thriller91/Cansat-SupOp/README.md

#Projet τετραφάρμακος

#à propos
Nous construisons un cansat, ce satellite, qui sera largué d'un dirigeable du CNES, doit tenir dans une canette. Il doit réaliser 
plusieurs missions. Nous allons faire une mesure de données météorologiques, et une mesure de l'indice de végétation par une prise 
d'image dans deux gammes spectrales.

#les composants

Nous utilisons une Arduino mini pour contrôler nos capteurs (pression, température, hydrométrie, accélération, position GPS), nos 
caméras (caméra JPEG), notre module de transmission sans fil (Xbee) et notre carte mémoire micro-SD.
L'ensemble de ces composants doit être mis en commun, et il est important de bien respecter les tensions de chacun. Les programmes 
permettant de piloter ces composants sont rassemblés dans ce repository.
