thriller91/Cansat-SupOp/sources/Arduino/DHT22/README.md

#Capteur d'humidité et de température

##Branchement

- Pin 1 (on the left) → +5V
- Pin 2 → DHTPIN defini dans le programme
- Pin 4 → GND
- Connect a 10K resistor from pin 2 (data) to pin 1 (power) of the sensor
