thriller91/Cansat-SupOp/sources/Arduino/BMP085/README.md

# Ce programme marche sur la Mini (sans translateur de niveau)

##Branchement:
- SDA → AD4
- SCL → AD5
- GND → GND (alim stab)
- VCC → 3.3V (alim stab)
