thriller91/Cansat-SupOp/sources/prgm sol/communication/pycrop/cooked/Press.pdf

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

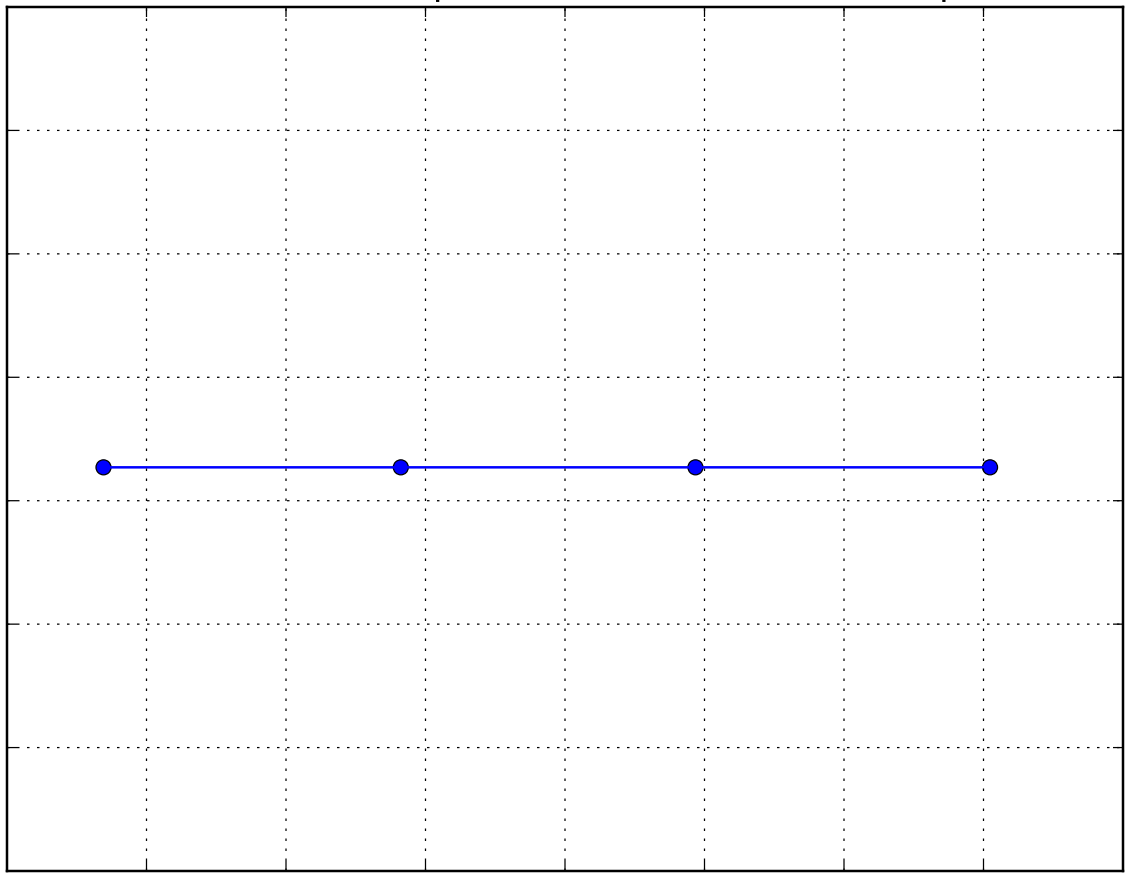
[picture p15: figure]
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
