thriller91/Cansat-SupOp/elec/tetrapharmakos_image0.png

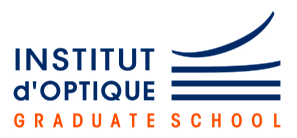
elec/tetrapharmakos_image0.png
