thriller91/Cansat-SupOp/elec/tetrapharmakos_image1.png

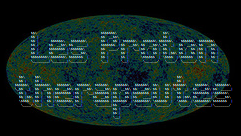
elec/tetrapharmakos_image1.png
