thriller91/Cansat-SupOp/sources/Arduino/tetra/IMG01.JPG

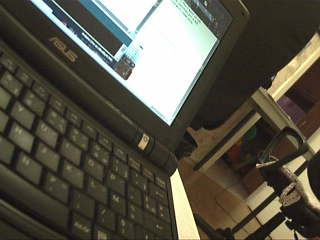
sources/Arduino/tetra/IMG01.JPG
