thriller91/Cansat-SupOp/sources/prgm sol/communication/pycrop/exemple.png

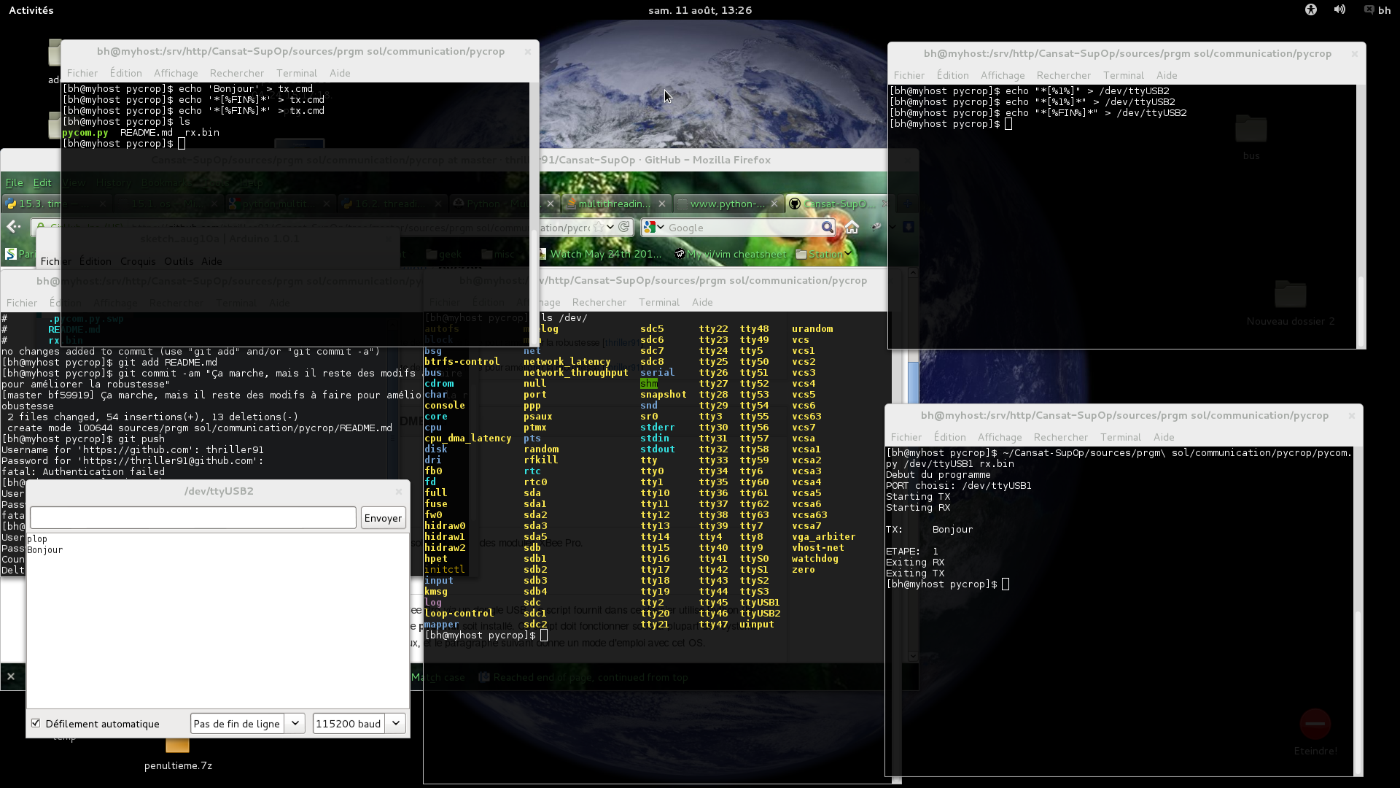
sources/prgm sol/communication/pycrop/exemple.png
