thriller91/Cansat-SupOp/sources/prgm sol/communication/pycrop/images/08-58-16.jpg

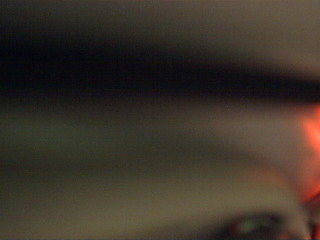
sources/prgm sol/communication/pycrop/images/08-58-16.jpg
