thriller91/Cansat-SupOp/sources/prgm sol/traitement images/a1.png

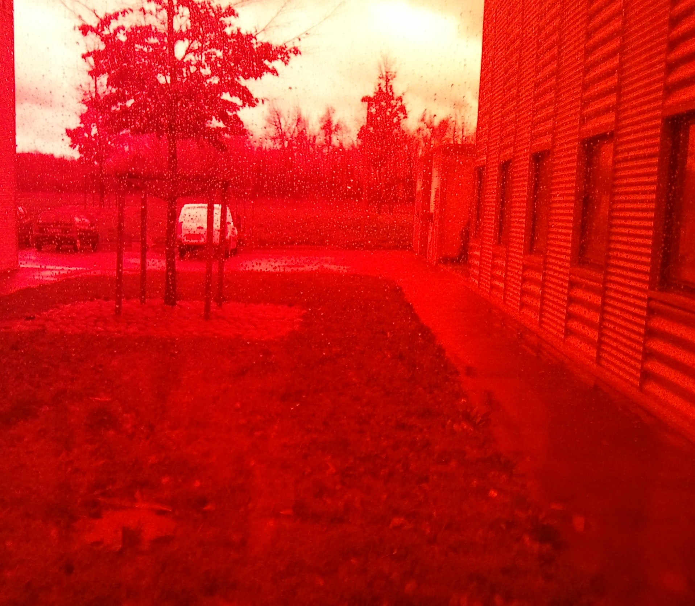
sources/prgm sol/traitement images/a1.png
