thriller91/Cansat-SupOp/sources/prgm sol/traitement images/a2.png

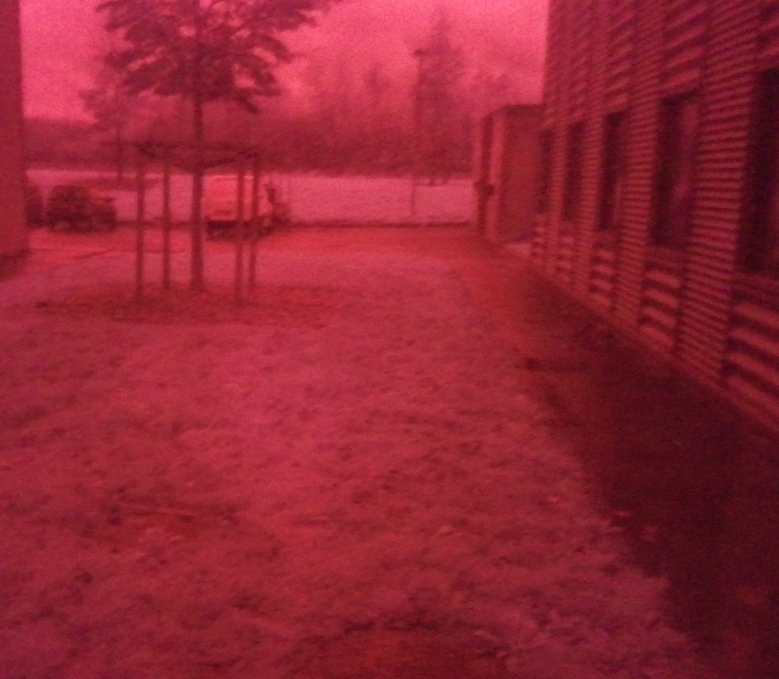
sources/prgm sol/traitement images/a2.png
