thriller91/Cansat-SupOp/sources/prgm sol/traitement images/b1.png

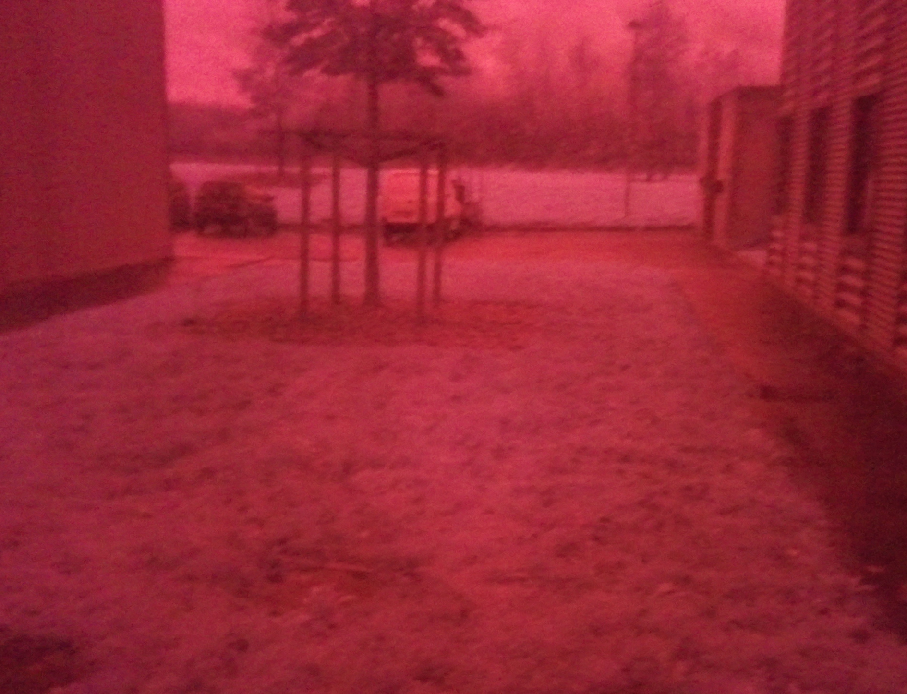
sources/prgm sol/traitement images/b1.png
