thriller91/Cansat-SupOp/sources/prgm sol/traitement images/b2.png

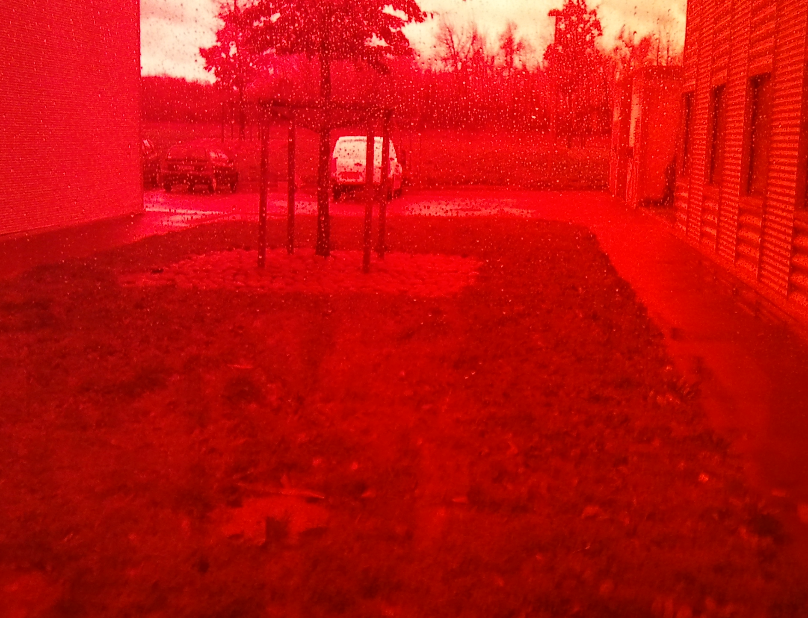
sources/prgm sol/traitement images/b2.png
