thriller91/Cansat-SupOp/sources/prgm sol/traitement images/efg/01.png

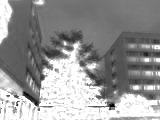
sources/prgm sol/traitement images/efg/01.png
