thriller91/Cansat-SupOp/sources/prgm sol/traitement images/efg/01IR.jpg

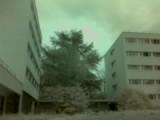
sources/prgm sol/traitement images/efg/01IR.jpg
