thriller91/Cansat-SupOp/sources/prgm sol/traitement images/efg/01R.jpg

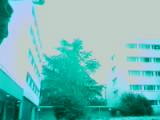
sources/prgm sol/traitement images/efg/01R.jpg
