thriller91/Cansat-SupOp/sources/prgm sol/traitement images/efg/02.png

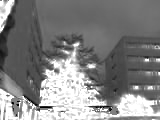
sources/prgm sol/traitement images/efg/02.png
