thriller91/Cansat-SupOp/sources/prgm sol/traitement images/efg/02IR.jpg

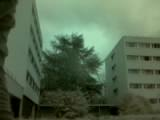
sources/prgm sol/traitement images/efg/02IR.jpg
