thriller91/Cansat-SupOp/sources/prgm sol/traitement images/efg/03.png

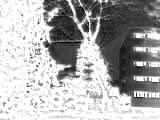
sources/prgm sol/traitement images/efg/03.png
