thriller91/Cansat-SupOp/sources/prgm sol/traitement images/efg/03IR.jpg

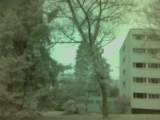
sources/prgm sol/traitement images/efg/03IR.jpg
