thriller91/Cansat-SupOp/sources/prgm sol/traitement images/efg/03R.jpg

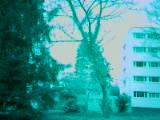
sources/prgm sol/traitement images/efg/03R.jpg
