thriller91/Cansat-SupOp/sources/prgm sol/traitement images/efg/04.png

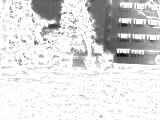
sources/prgm sol/traitement images/efg/04.png
