thriller91/Cansat-SupOp/sources/prgm sol/traitement images/efg/04IR.jpg

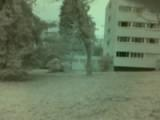
sources/prgm sol/traitement images/efg/04IR.jpg
