thriller91/Cansat-SupOp/sources/prgm sol/traitement images/efg/04R.jpg

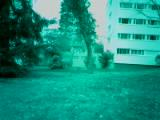
sources/prgm sol/traitement images/efg/04R.jpg
