thriller91/Cansat-SupOp/sources/prgm sol/traitement images/efg/05.png

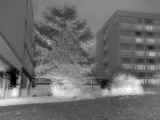
sources/prgm sol/traitement images/efg/05.png
