thriller91/Cansat-SupOp/sources/prgm sol/traitement images/efg/05IR.jpg

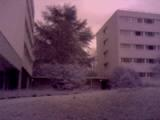
sources/prgm sol/traitement images/efg/05IR.jpg
