thriller91/Cansat-SupOp/sources/prgm sol/traitement images/efg/05R.jpg

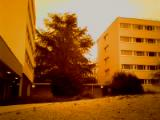
sources/prgm sol/traitement images/efg/05R.jpg
