thriller91/Cansat-SupOp/sources/prgm sol/traitement images/efg/06.png

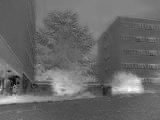
sources/prgm sol/traitement images/efg/06.png
