thriller91/Cansat-SupOp/sources/prgm sol/traitement images/efg/06IR.jpg

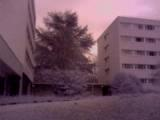
sources/prgm sol/traitement images/efg/06IR.jpg
