thriller91/Cansat-SupOp/sources/prgm sol/traitement images/efg/07.png

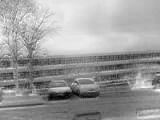
sources/prgm sol/traitement images/efg/07.png
