thriller91/Cansat-SupOp/sources/prgm sol/traitement images/efg/07IR.jpg

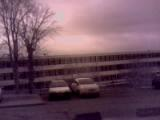
sources/prgm sol/traitement images/efg/07IR.jpg
