thriller91/Cansat-SupOp/sources/prgm sol/traitement images/efg/07R.jpg

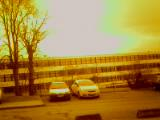
sources/prgm sol/traitement images/efg/07R.jpg
