thriller91/Cansat-SupOp/sources/prgm sol/traitement images/efg/08.png

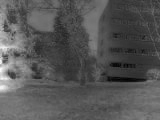
sources/prgm sol/traitement images/efg/08.png
