thriller91/Cansat-SupOp/sources/prgm sol/traitement images/efg/08IR.jpg

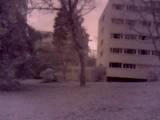
sources/prgm sol/traitement images/efg/08IR.jpg
