thriller91/Cansat-SupOp/sources/prgm sol/traitement images/efg/08R.jpg

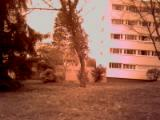
sources/prgm sol/traitement images/efg/08R.jpg
