thriller91/Cansat-SupOp/sources/prgm sol/traitement images/Photo1661.jpg

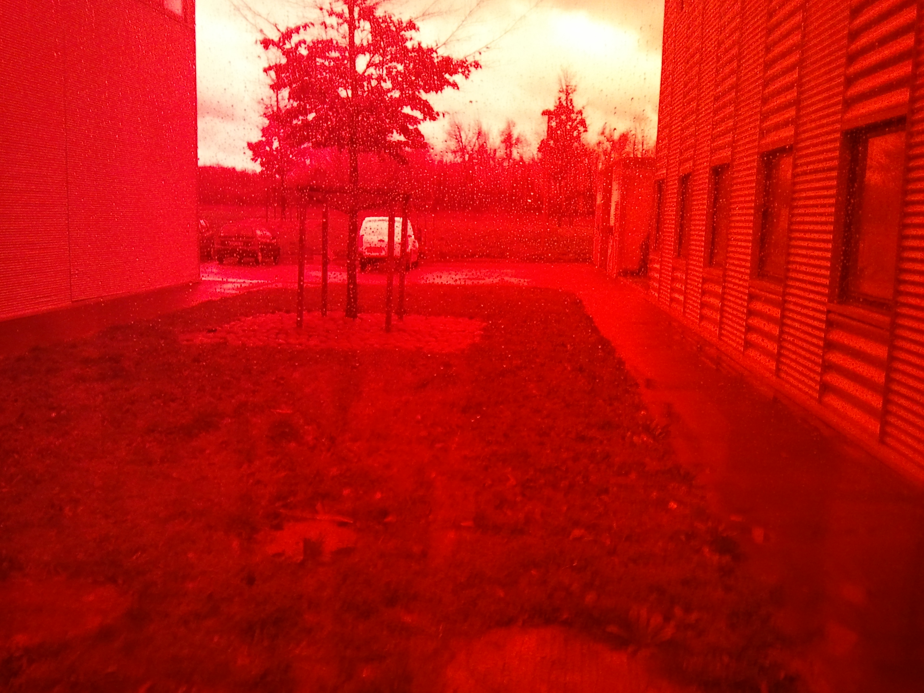
sources/prgm sol/traitement images/Photo1661.jpg
