thriller91/Cansat-SupOp/sources/prgm sol/traitement images/Photo1662.jpg

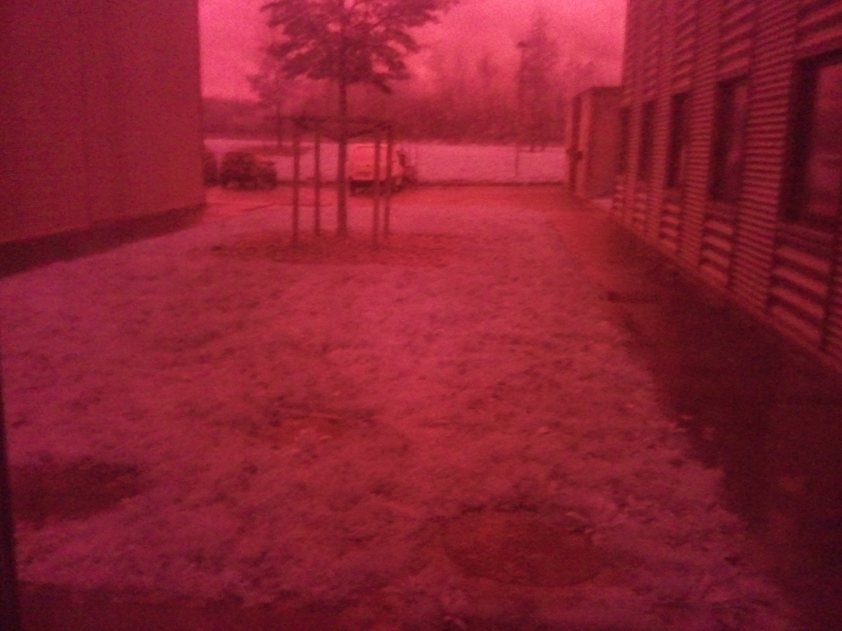
sources/prgm sol/traitement images/Photo1662.jpg
