thriller91/Cansat-SupOp/sources/prgm sol/traitement images/research/IMG01.JPG

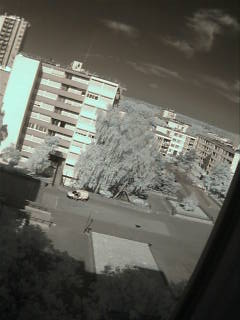
sources/prgm sol/traitement images/research/IMG01.JPG
