thriller91/Cansat-SupOp/website/images/elec/alim-photo.png

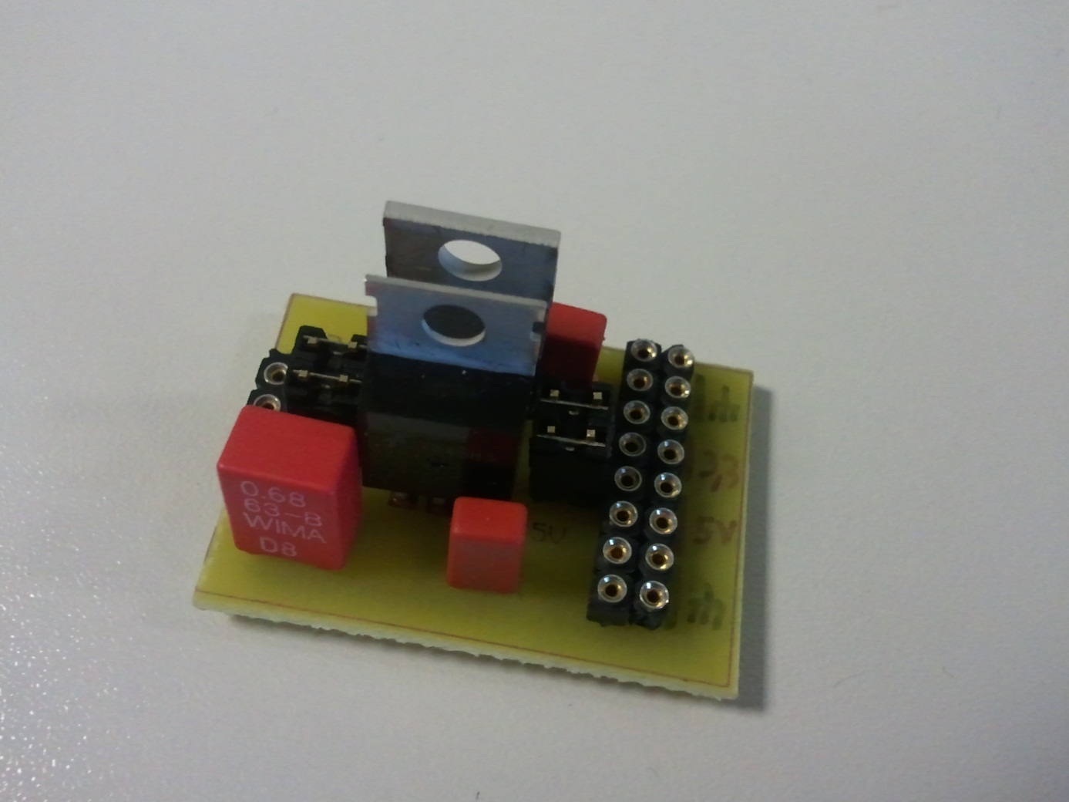
website/images/elec/alim-photo.png
