thriller91/Cansat-SupOp/website/images/elec/alim-schema.png

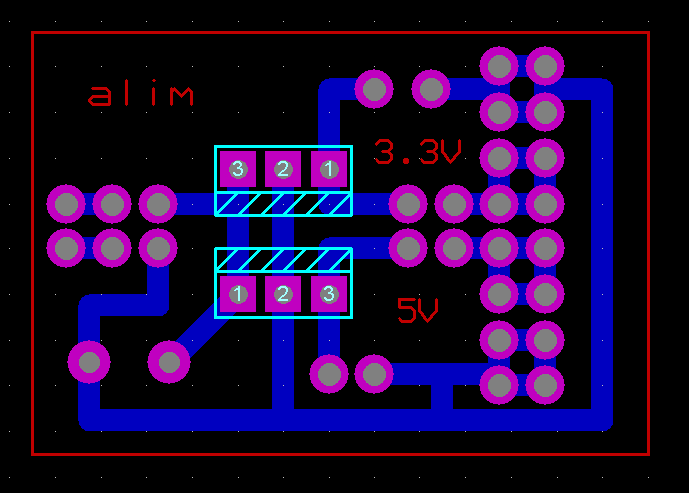
website/images/elec/alim-schema.png
