thriller91/Cansat-SupOp/website/images/elec/cansat-header.png

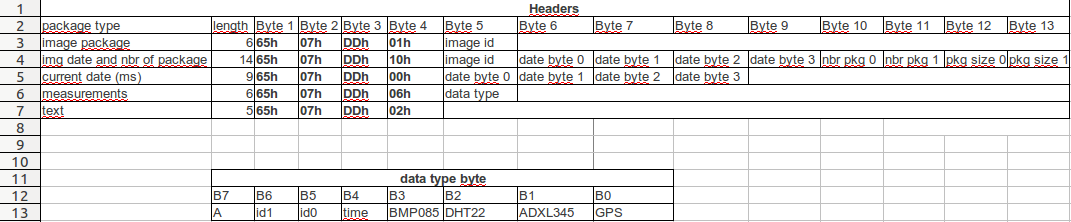
website/images/elec/cansat-header.png
