thriller91/Cansat-SupOp/website/images/elec/ccd.png

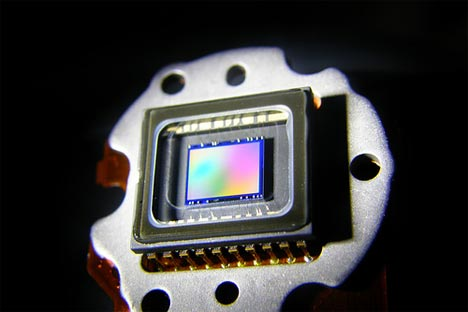
website/images/elec/ccd.png
