thriller91/Cansat-SupOp/website/images/elec/cube-cartes.png

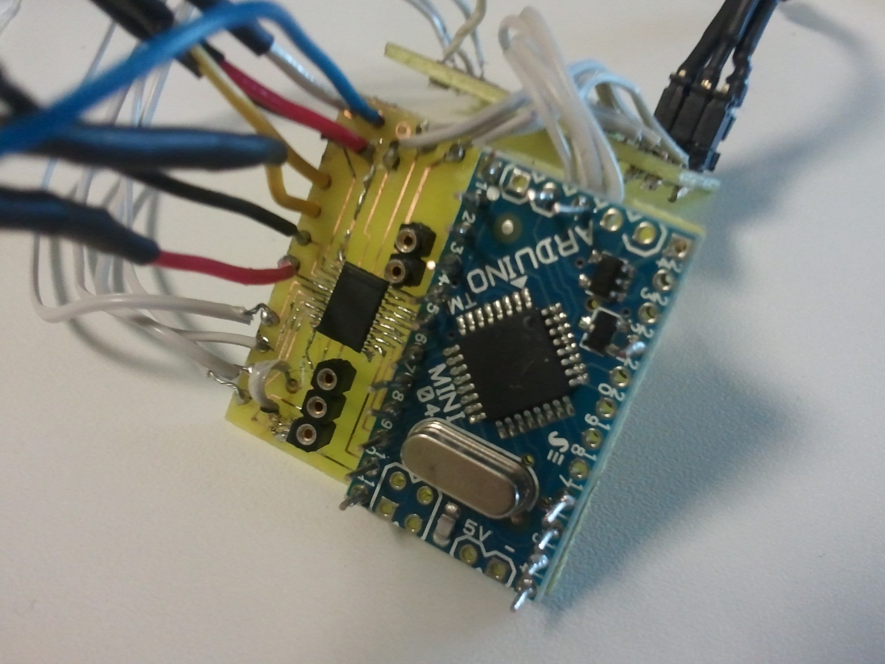
website/images/elec/cube-cartes.png
