thriller91/Cansat-SupOp/website/images/elec/cube-elec.png

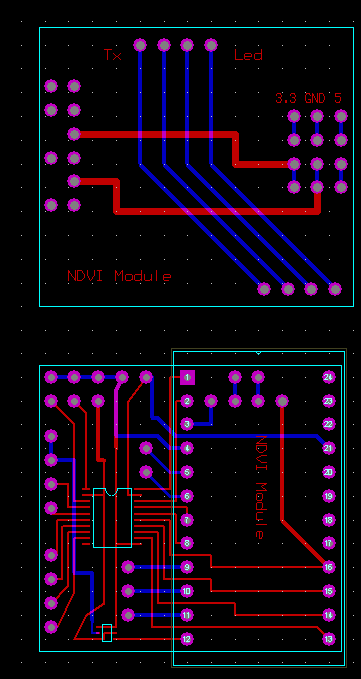
website/images/elec/cube-elec.png
