thriller91/Cansat-SupOp/website/images/elec/fatras.png

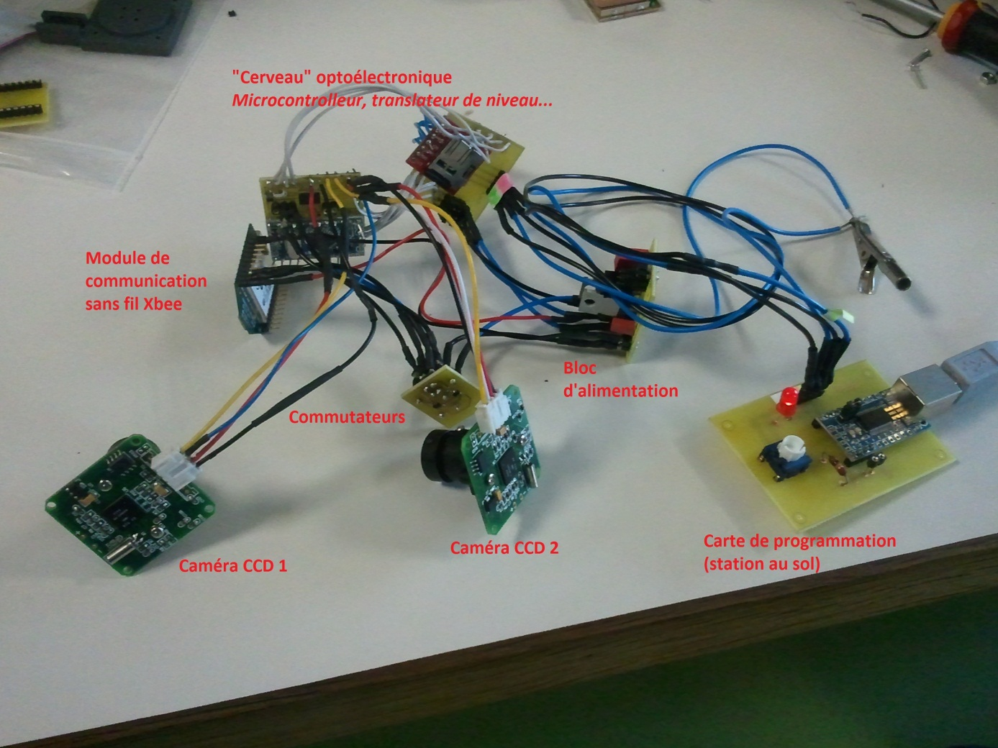
website/images/elec/fatras.png
