thriller91/Cansat-SupOp/website/images/elec/prog.png

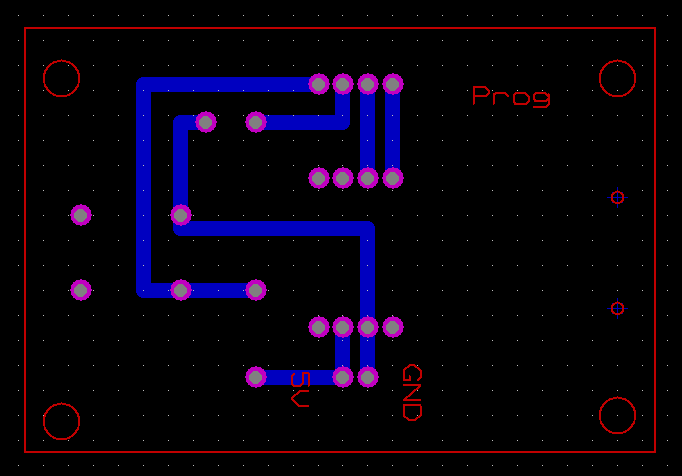
website/images/elec/prog.png
