thriller91/Cansat-SupOp/website/images/elec/schema-1-2-struct-logi.png

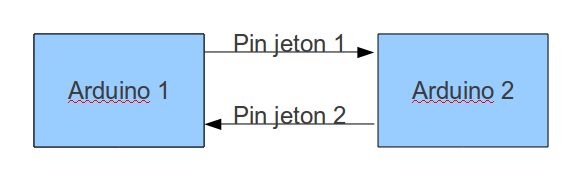
website/images/elec/schema-1-2-struct-logi.png
