thriller91/Cansat-SupOp/website/images/elec/translation-photo.png

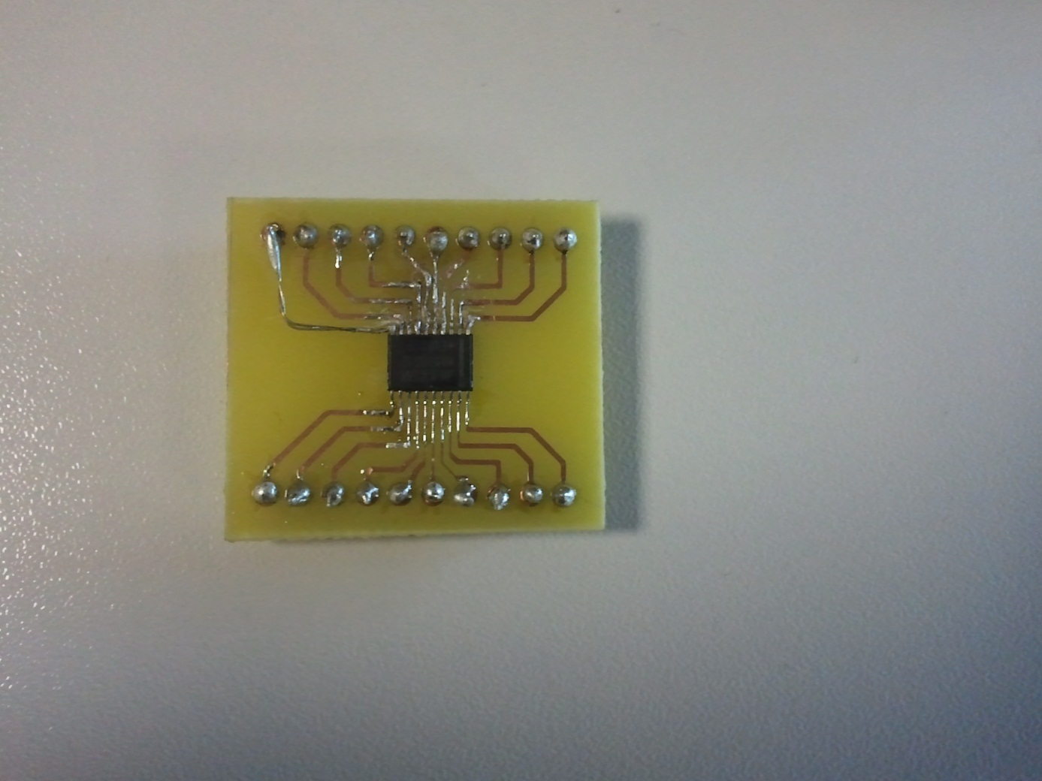
website/images/elec/translation-photo.png
