thriller91/Cansat-SupOp/website/images/elec/translation-schema.png

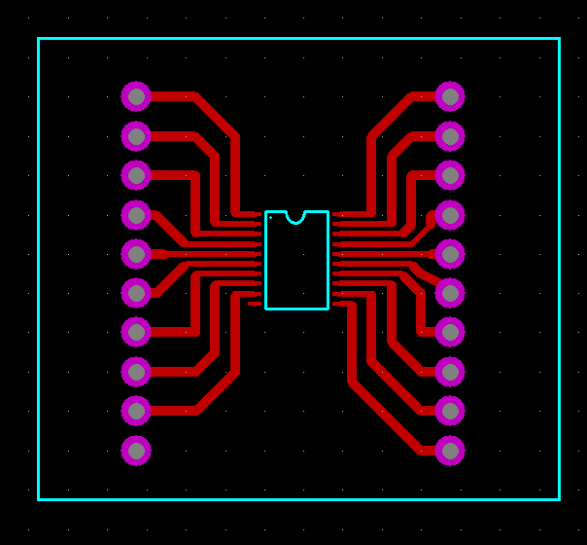
website/images/elec/translation-schema.png
