thriller91/Cansat-SupOp/website/images/global_ndvi_19990921.jpg

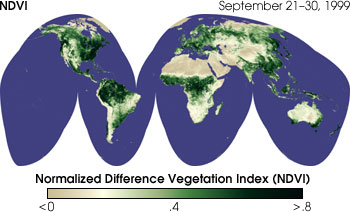
website/images/global_ndvi_19990921.jpg
