thriller91/Cansat-SupOp/website/images/hkgfmh.bmp

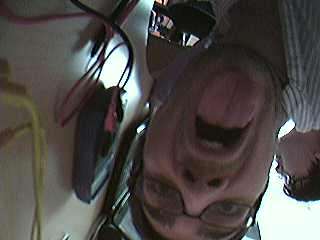
website/images/hkgfmh.bmp
