thriller91/Cansat-SupOp/website/images/nasa-sun-blue.jpg

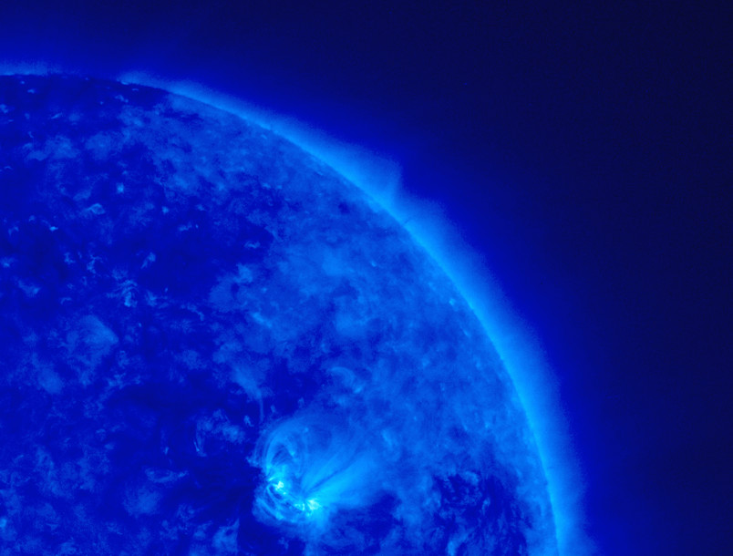
website/images/nasa-sun-blue.jpg
