thriller91/Cansat-SupOp/website/images/nasa-sun-stereo.jpg

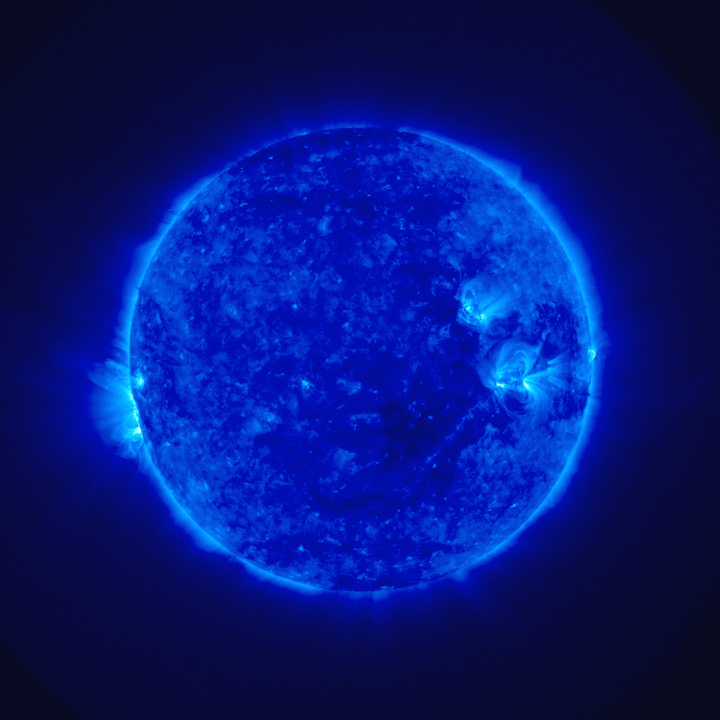
website/images/nasa-sun-stereo.jpg
