thriller91/Cansat-SupOp/website/images/parachute/DSCF2862.JPG

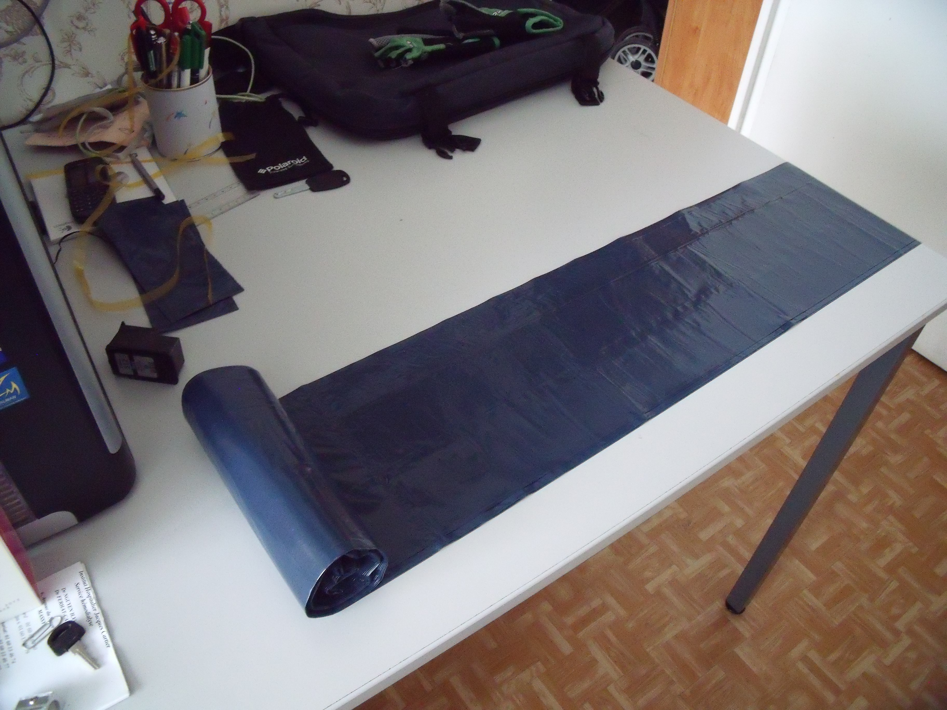
website/images/parachute/DSCF2862.JPG
