thriller91/Cansat-SupOp/website/images/parachute/DSCF2863.JPG

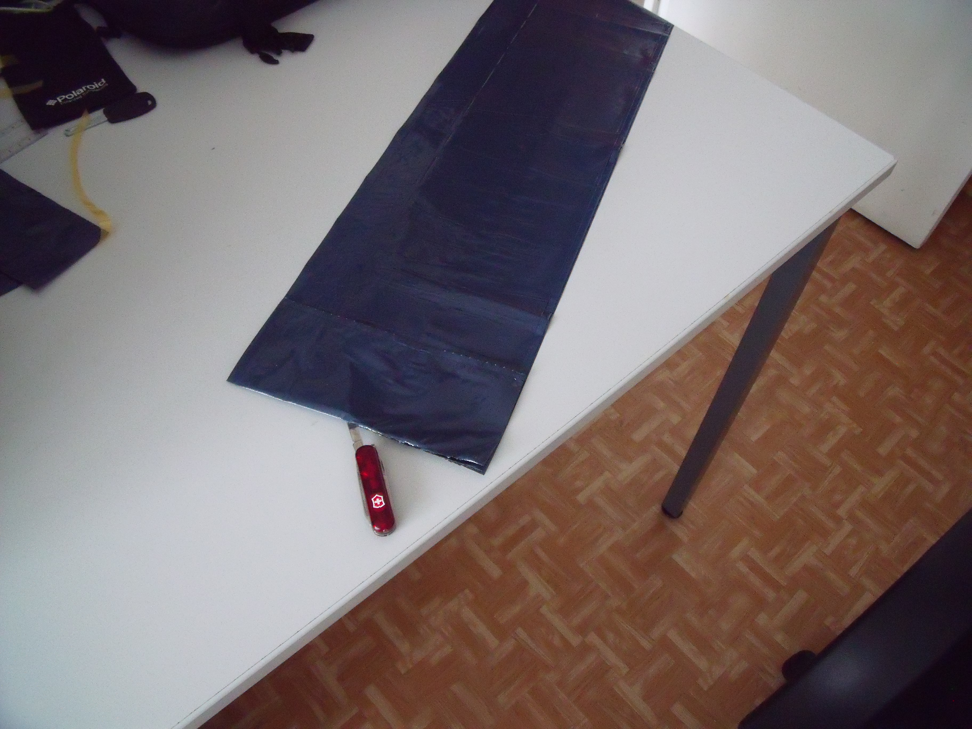
website/images/parachute/DSCF2863.JPG
