thriller91/Cansat-SupOp/website/images/parachute/DSCF2865.JPG

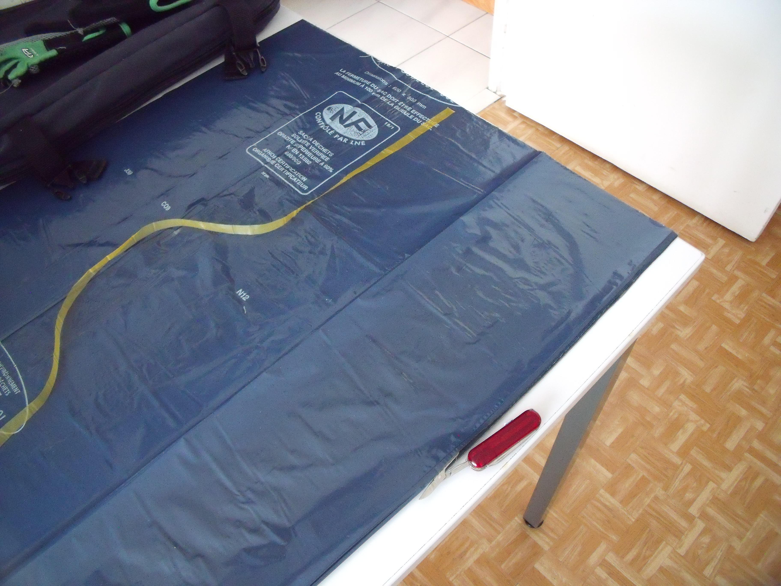
website/images/parachute/DSCF2865.JPG
