thriller91/Cansat-SupOp/website/images/parachute/DSCF2867.JPG

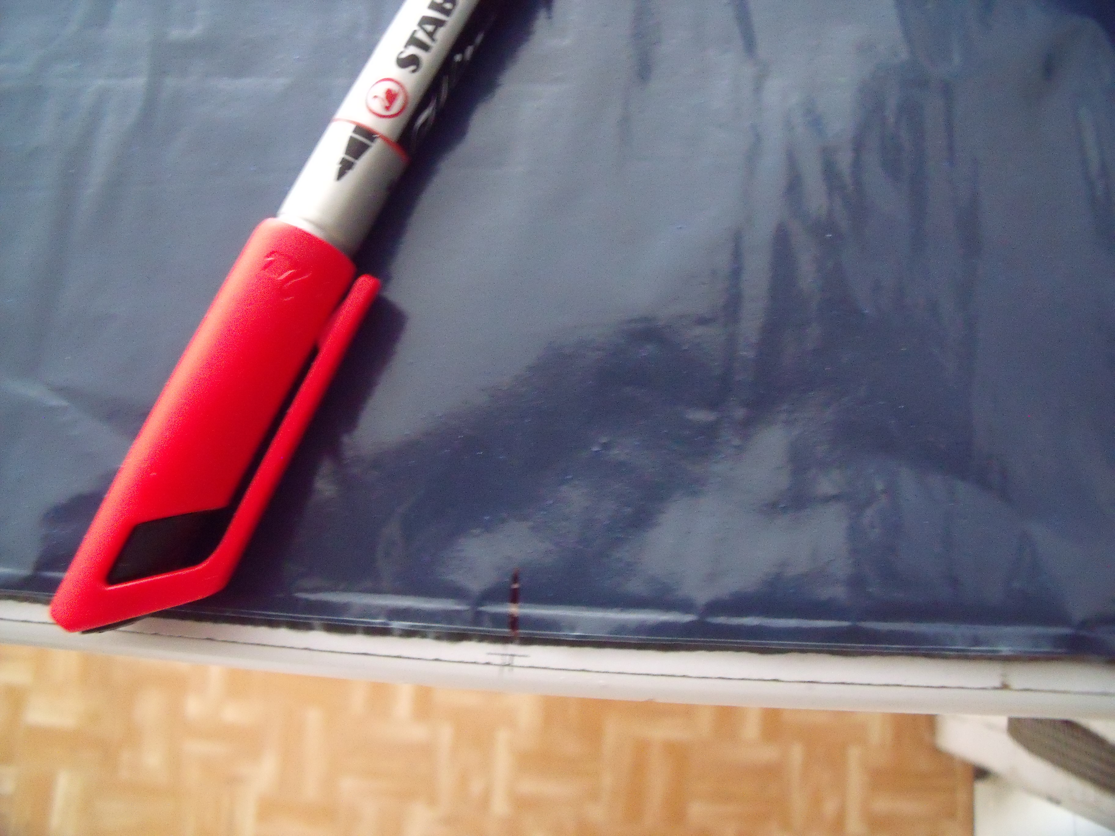
website/images/parachute/DSCF2867.JPG
