thriller91/Cansat-SupOp/website/images/parachute/DSCF2868.JPG

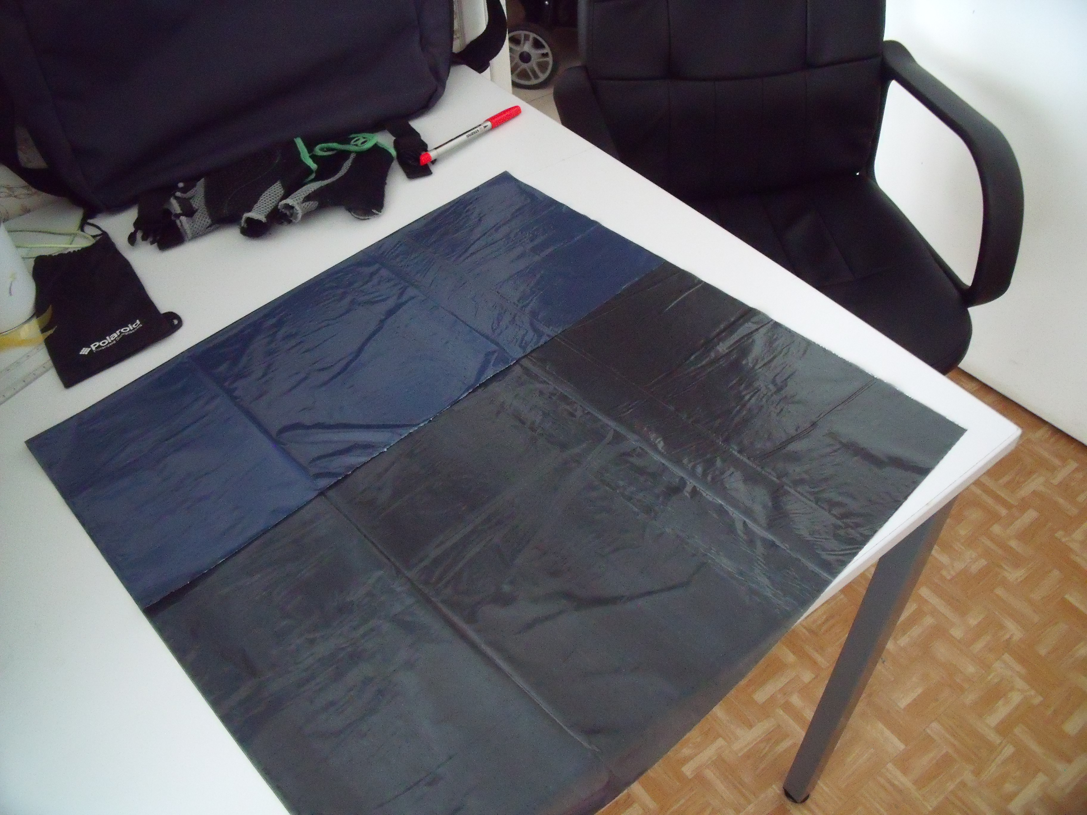
website/images/parachute/DSCF2868.JPG
