thriller91/Cansat-SupOp/website/images/parachute/DSCF2869.JPG

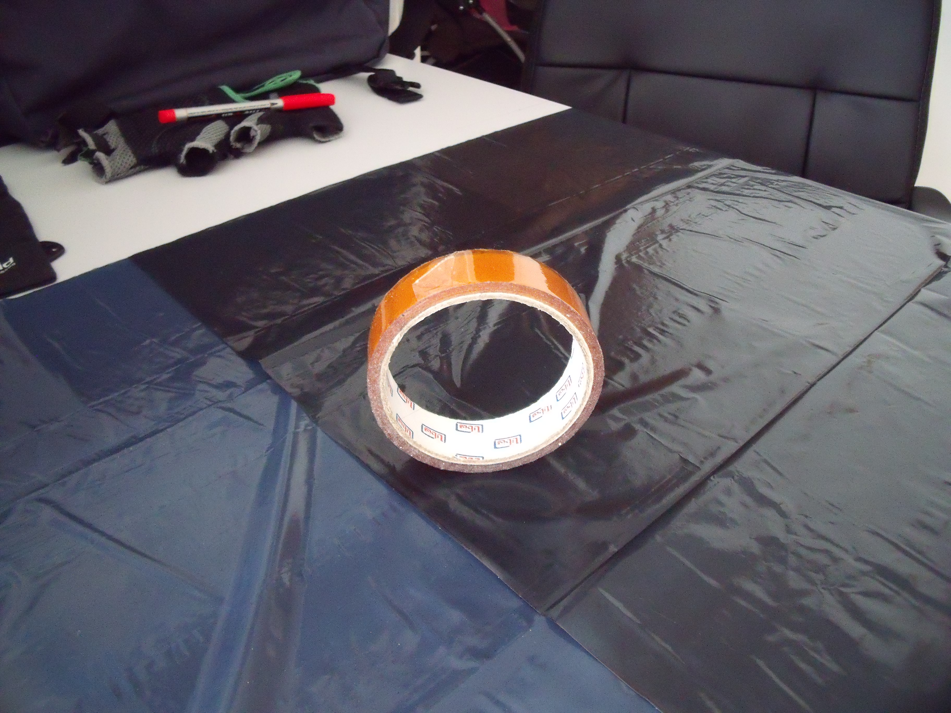
website/images/parachute/DSCF2869.JPG
