thriller91/Cansat-SupOp/website/images/parachute/DSCF2870.JPG

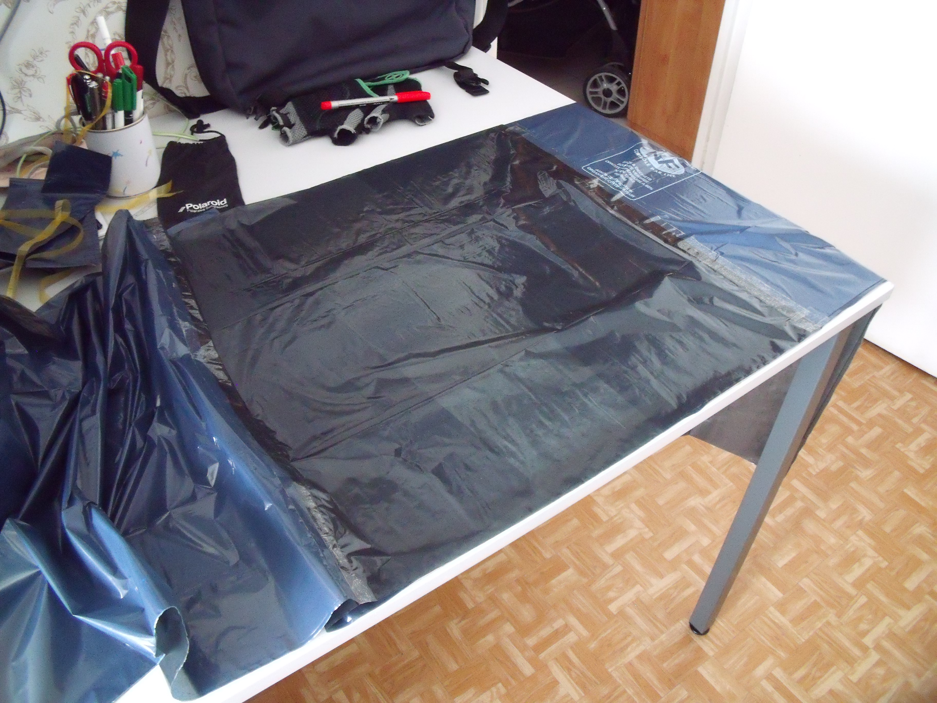
website/images/parachute/DSCF2870.JPG
