thriller91/Cansat-SupOp/website/images/parachute/DSCF2871.JPG

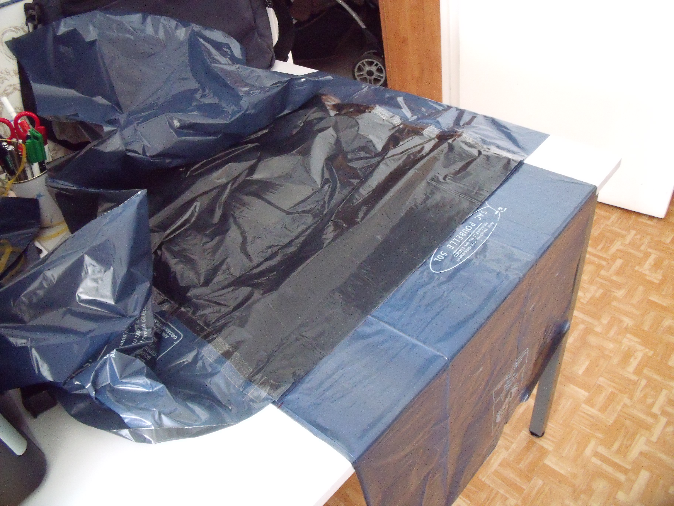
website/images/parachute/DSCF2871.JPG
