thriller91/Cansat-SupOp/website/images/parachute/DSCF2872.JPG

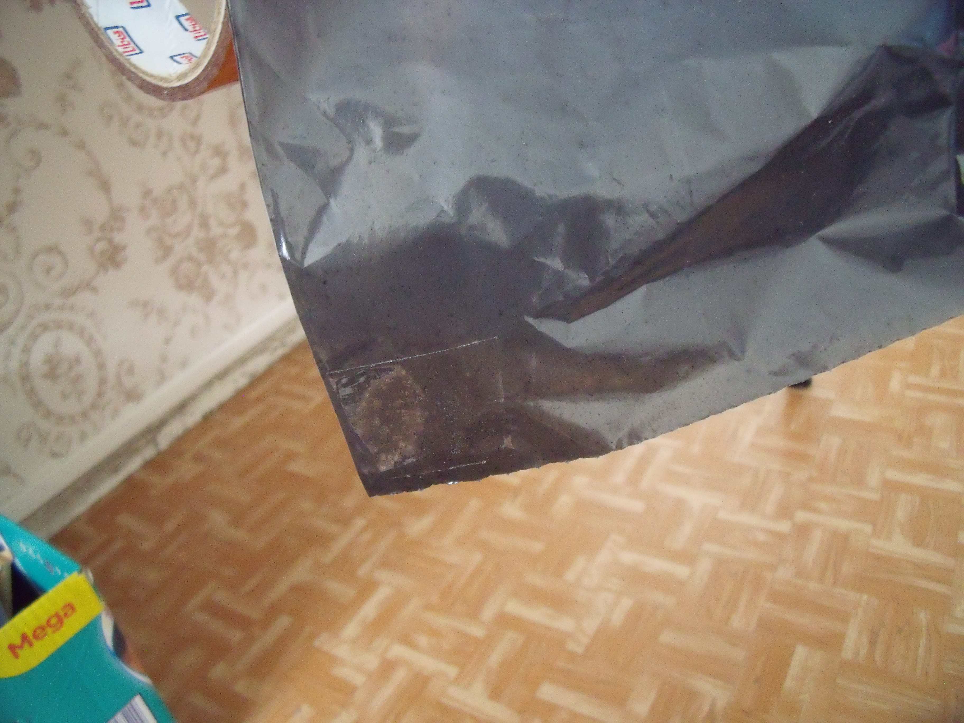
website/images/parachute/DSCF2872.JPG
