thriller91/Cansat-SupOp/website/images/parachute/DSCF2873.JPG

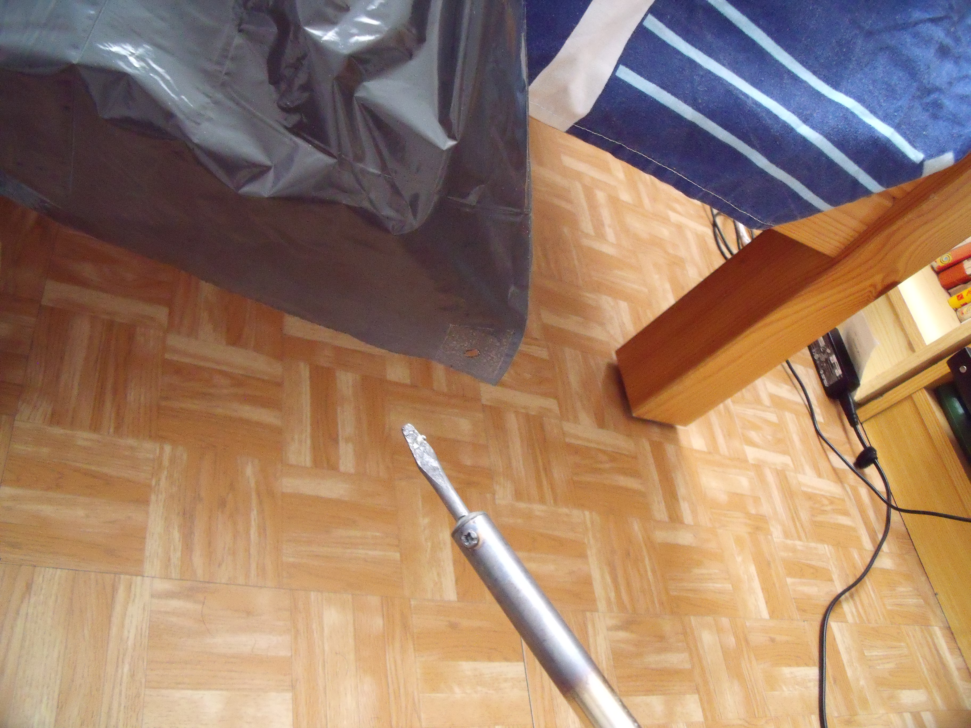
website/images/parachute/DSCF2873.JPG
