thriller91/Cansat-SupOp/website/images/parachute/DSCF2874.JPG

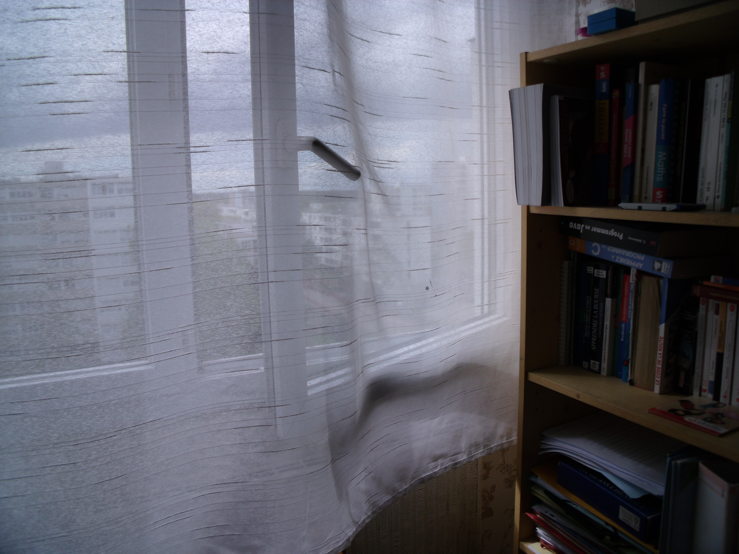
website/images/parachute/DSCF2874.JPG
