thriller91/Cansat-SupOp/website/images/parachute/DSCF2877.JPG

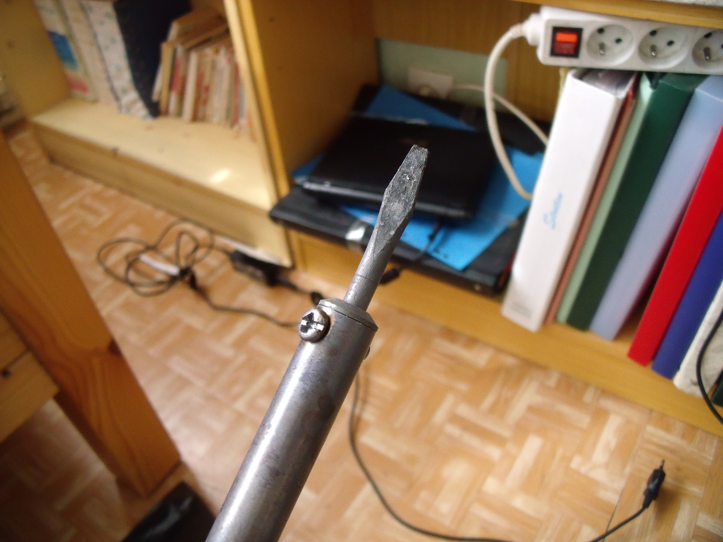
website/images/parachute/DSCF2877.JPG
