thriller91/Cansat-SupOp/website/images/parachute/DSCF2883.JPG

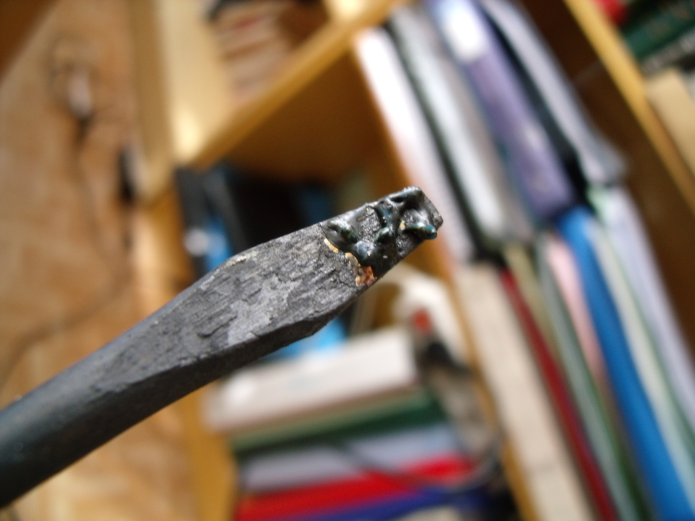
website/images/parachute/DSCF2883.JPG
