thriller91/Cansat-SupOp/website/images/parachute/DSCF2886.JPG

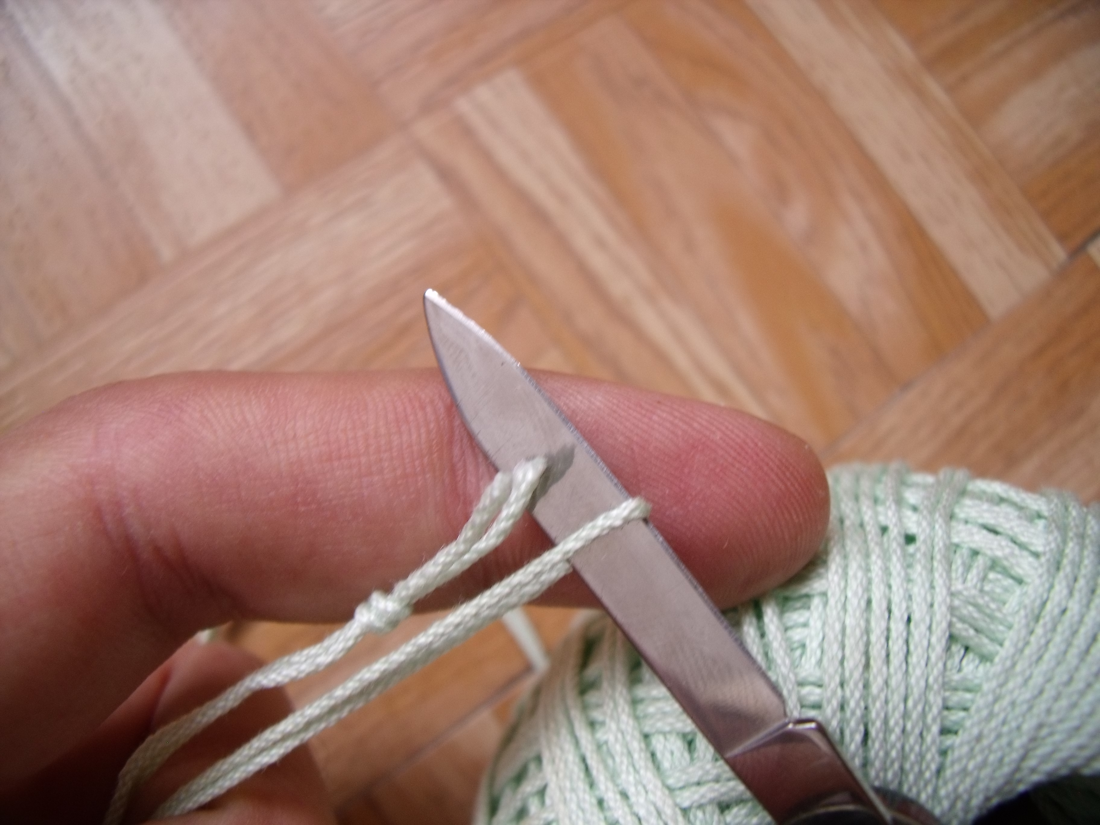
website/images/parachute/DSCF2886.JPG
