thriller91/Cansat-SupOp/website/images/parachute/DSCF2887.JPG

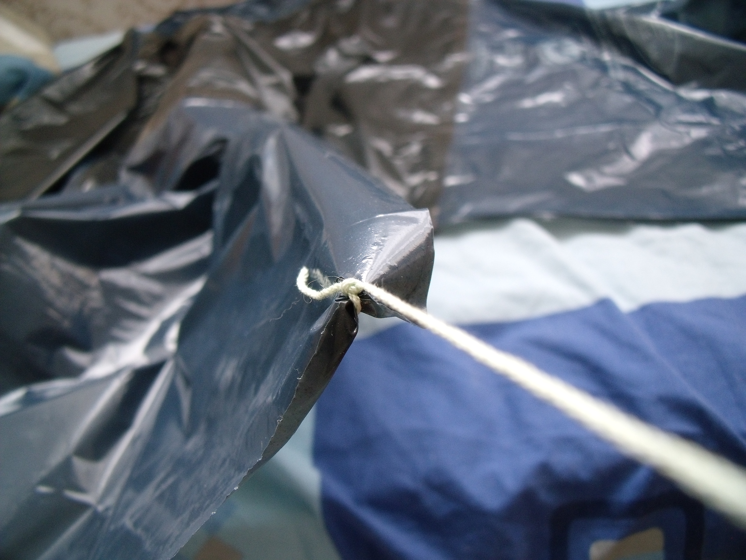
website/images/parachute/DSCF2887.JPG
