thriller91/Cansat-SupOp/website/images/parachute/DSCF2889.JPG

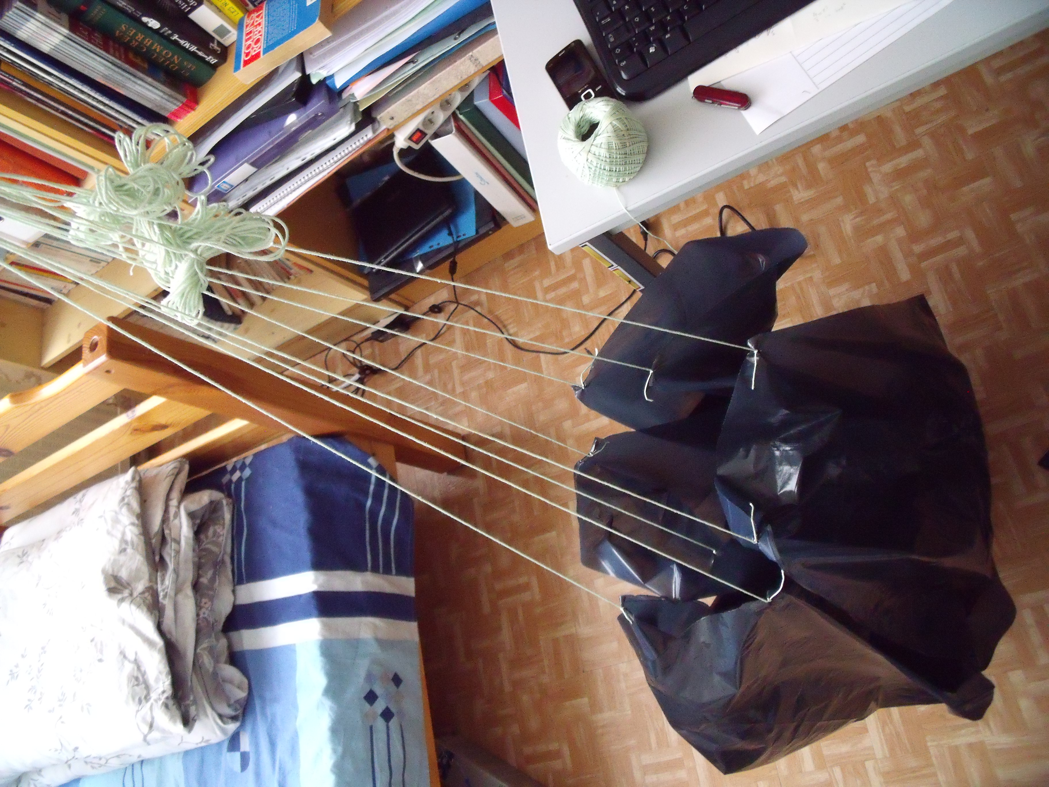
website/images/parachute/DSCF2889.JPG
