thriller91/Cansat-SupOp/website/images/plots/Budget_total.png

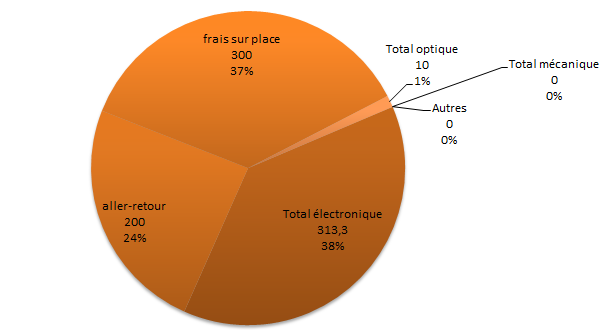
website/images/plots/Budget_total.png
