thriller91/Cansat-SupOp/website/images/plots/elec_diag.png

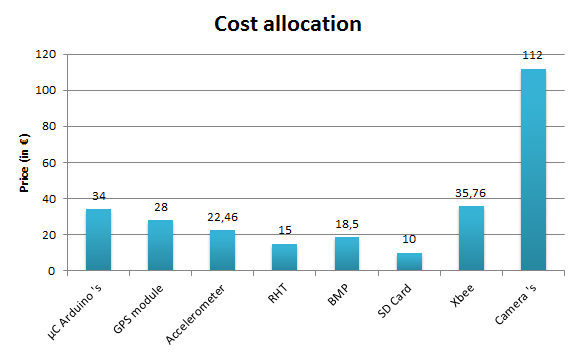
website/images/plots/elec_diag.png
