thriller91/Cansat-SupOp/website/images/plots/elec_mass.png

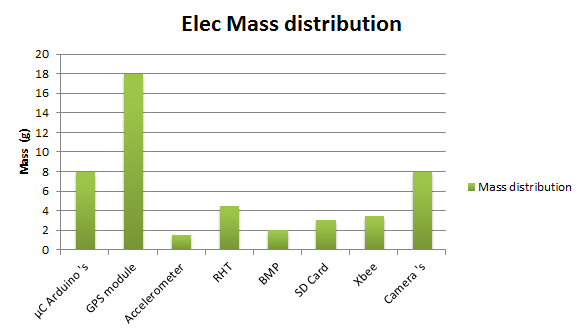
website/images/plots/elec_mass.png
