thriller91/Cansat-SupOp/website/images/plots/max_cons_camembert.png

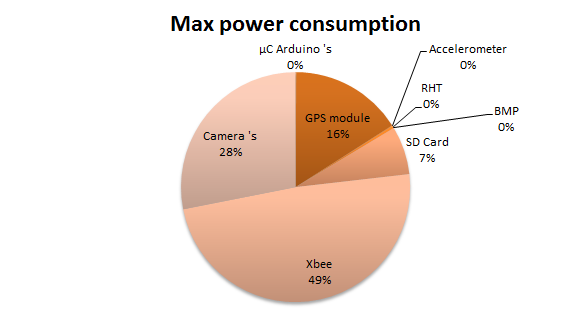
website/images/plots/max_cons_camembert.png
