thriller91/Cansat-SupOp/website/images/plots/max_cons_hist.png

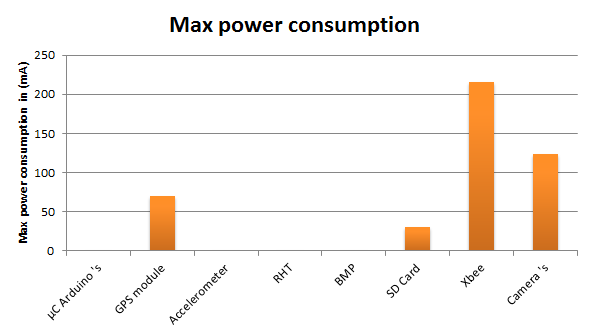
website/images/plots/max_cons_hist.png
