thriller91/Cansat-SupOp/website/images/plots/max_pow_camembert.png

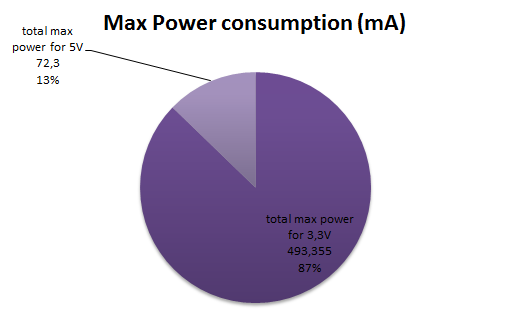
website/images/plots/max_pow_camembert.png
