thriller91/Cansat-SupOp/website/images/plots/max_pow_hist.png

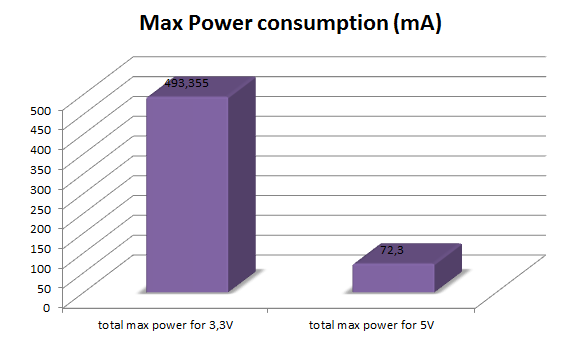
website/images/plots/max_pow_hist.png
