thriller91/Cansat-SupOp/website/images/plots/op_voltage.png

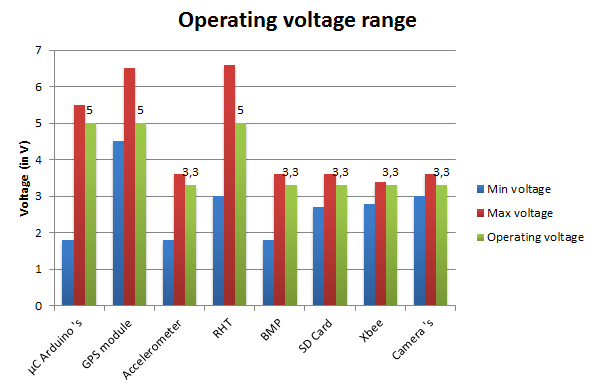
website/images/plots/op_voltage.png
