thriller91/Cansat-SupOp/website/images/plots/Structure_elec.png

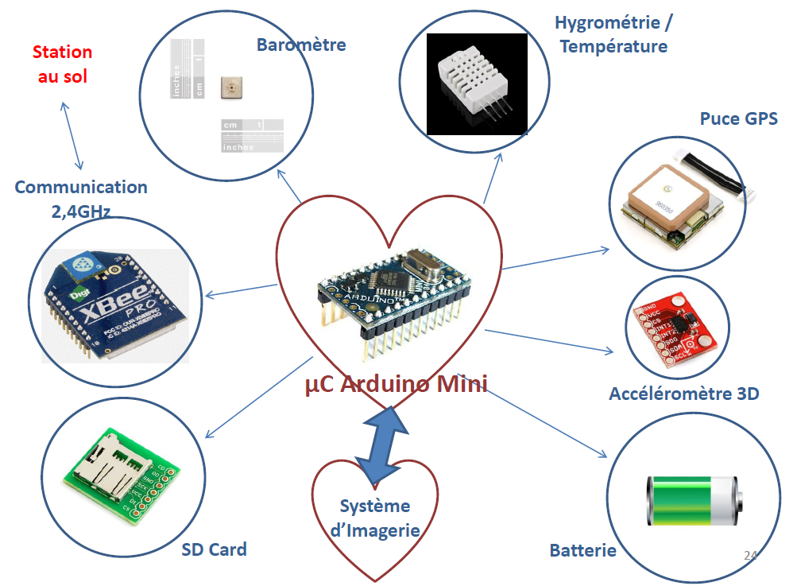
website/images/plots/Structure_elec.png
