thriller91/Cansat-SupOp/website/images/plots/temp.png

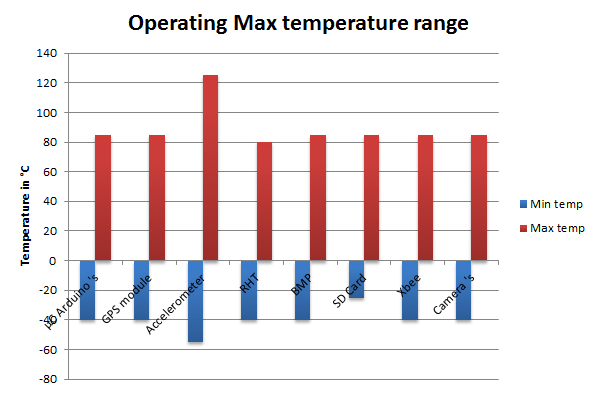
website/images/plots/temp.png
