thriller91/Cansat-SupOp/website/images/selec/DSCF3150.JPG

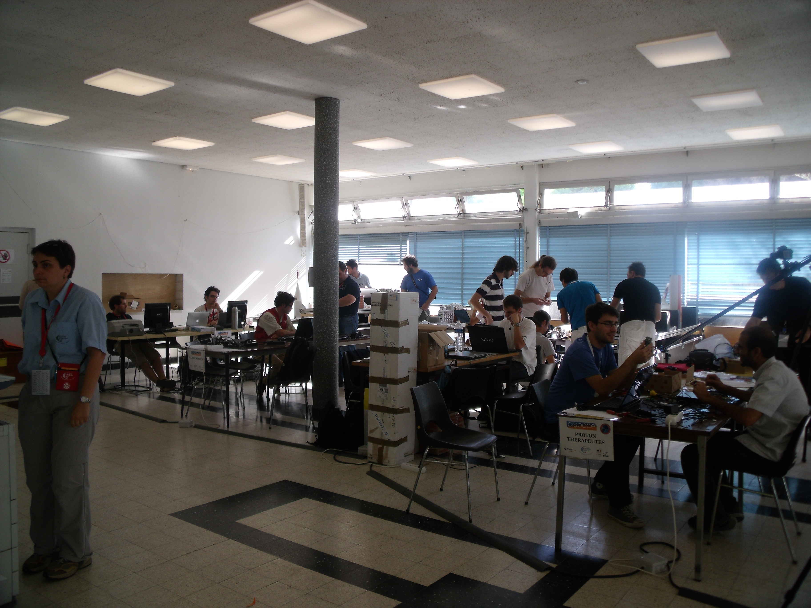
website/images/selec/DSCF3150.JPG
