thriller91/Cansat-SupOp/website/images/selec/DSCF3154.JPG

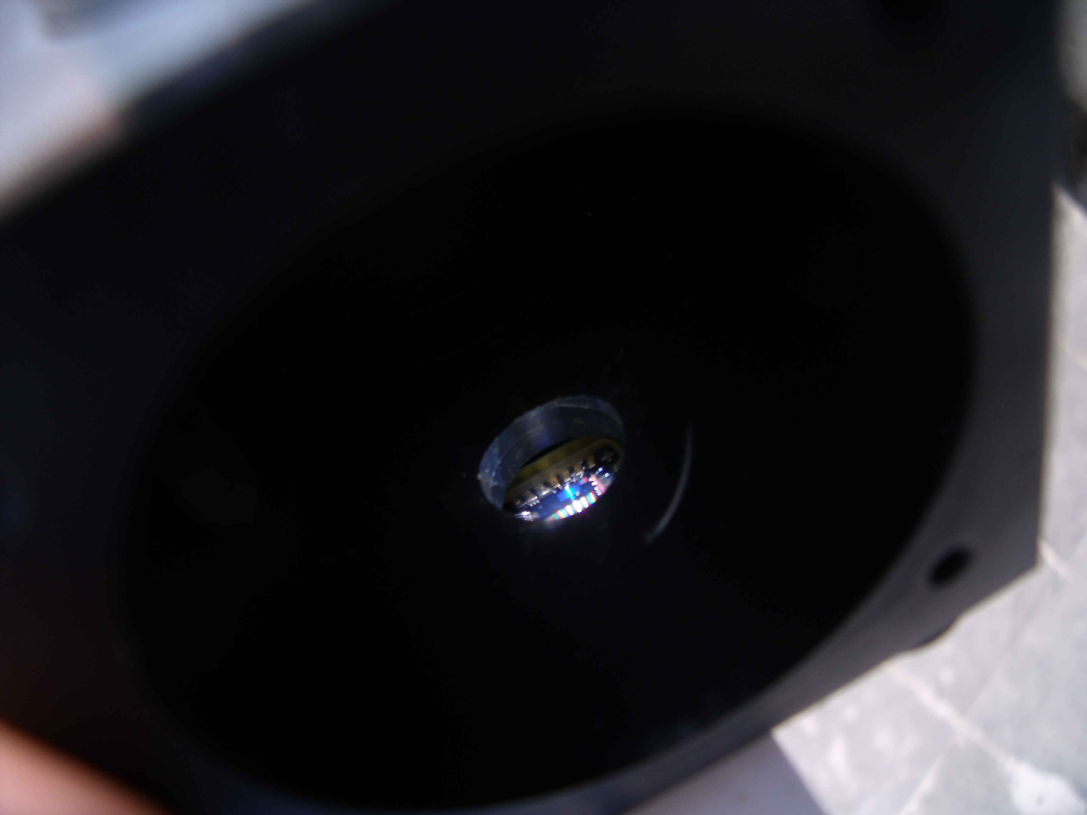
website/images/selec/DSCF3154.JPG
