thriller91/Cansat-SupOp/website/images/selec/DSCF3156.JPG

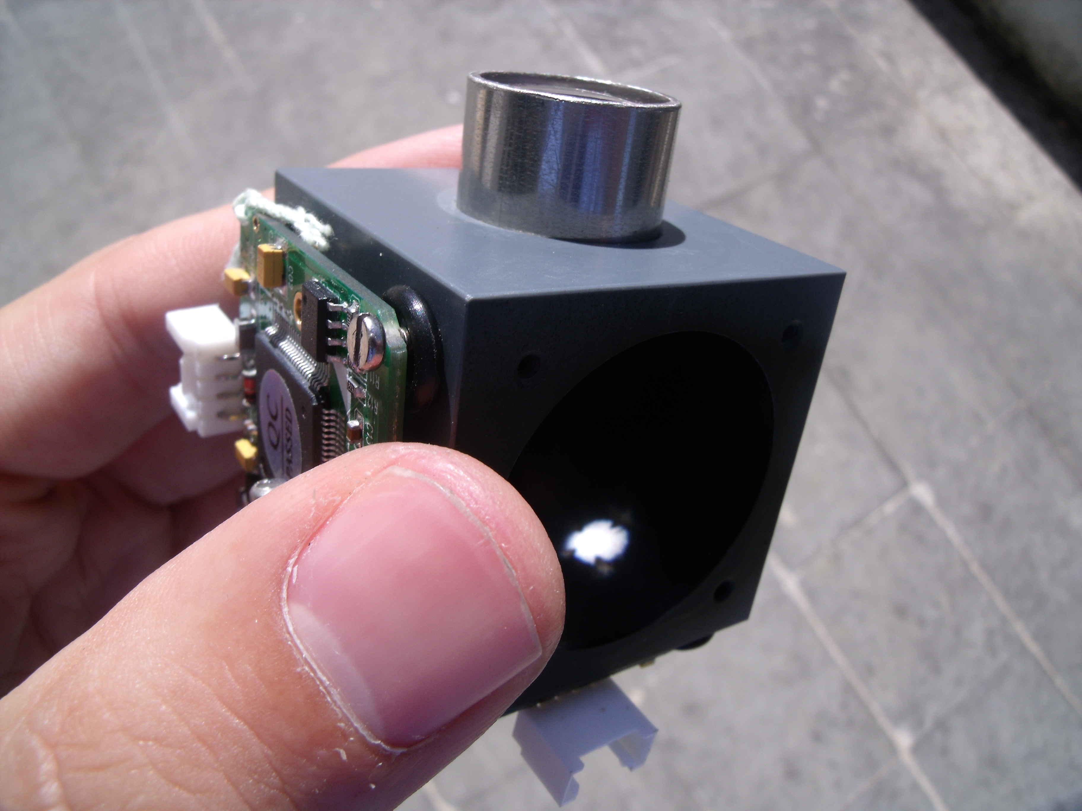
website/images/selec/DSCF3156.JPG
