thriller91/Cansat-SupOp/website/images/selec/DSCF3159.JPG

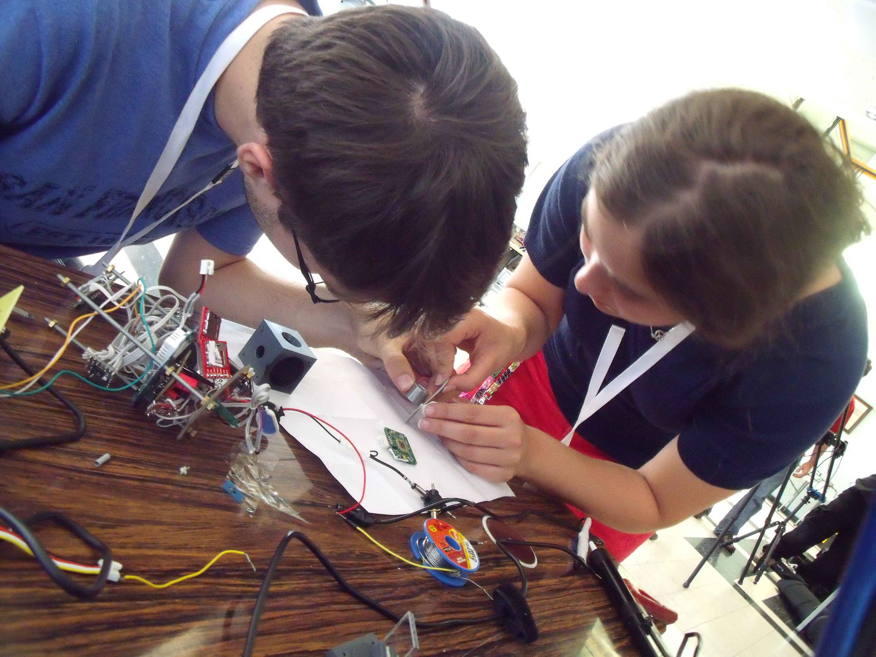
website/images/selec/DSCF3159.JPG
