thriller91/Cansat-SupOp/website/images/selec/DSCF3164.JPG

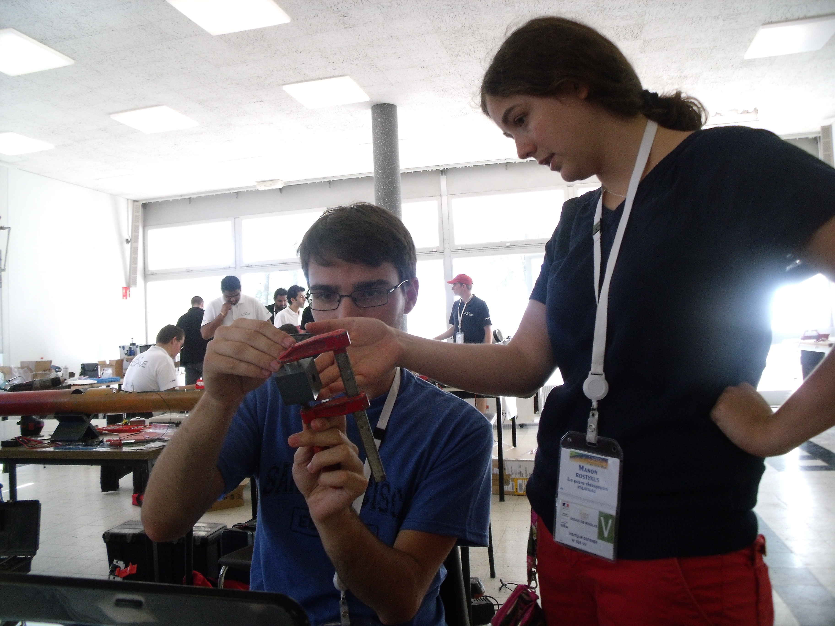
website/images/selec/DSCF3164.JPG
