thriller91/Cansat-SupOp/website/images/selec/DSCF3168.JPG

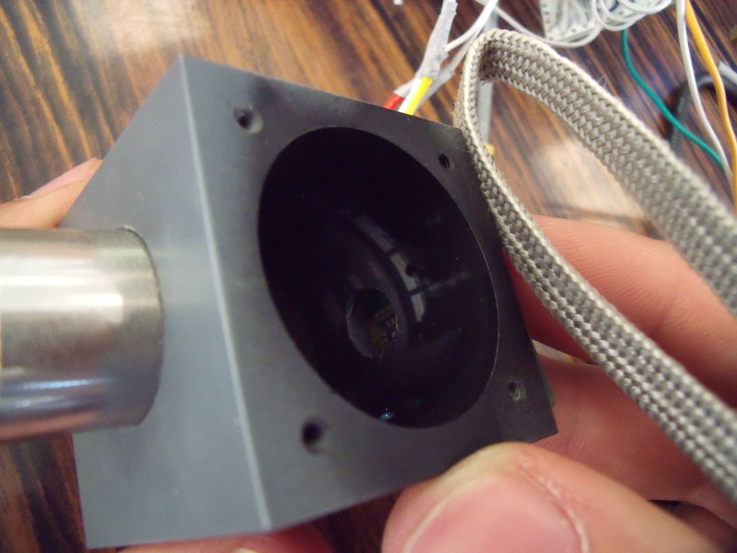
website/images/selec/DSCF3168.JPG
