thriller91/Cansat-SupOp/website/images/selec/DSCF3175.JPG

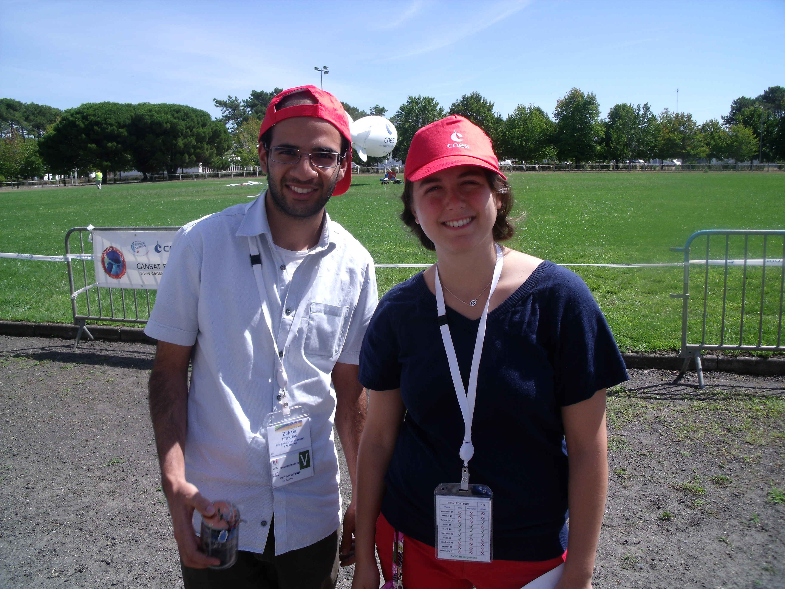
website/images/selec/DSCF3175.JPG
