thriller91/Cansat-SupOp/website/images/selec/DSCF3176.JPG

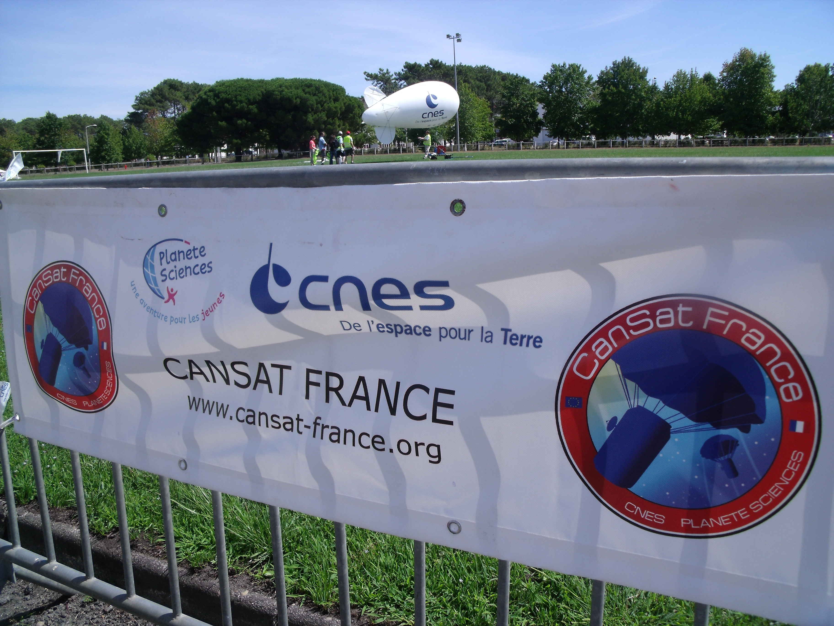
website/images/selec/DSCF3176.JPG
