thriller91/Cansat-SupOp/website/images/selec/DSCF3178.JPG

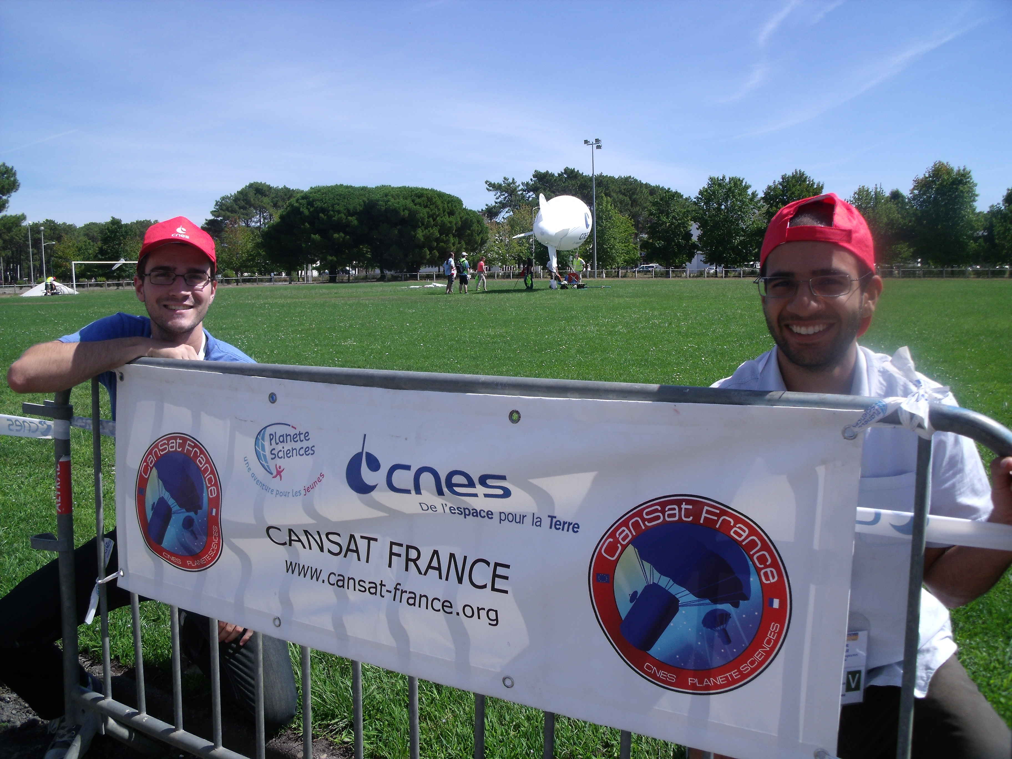
website/images/selec/DSCF3178.JPG
