thriller91/Cansat-SupOp/website/images/selec/DSCF3181.JPG

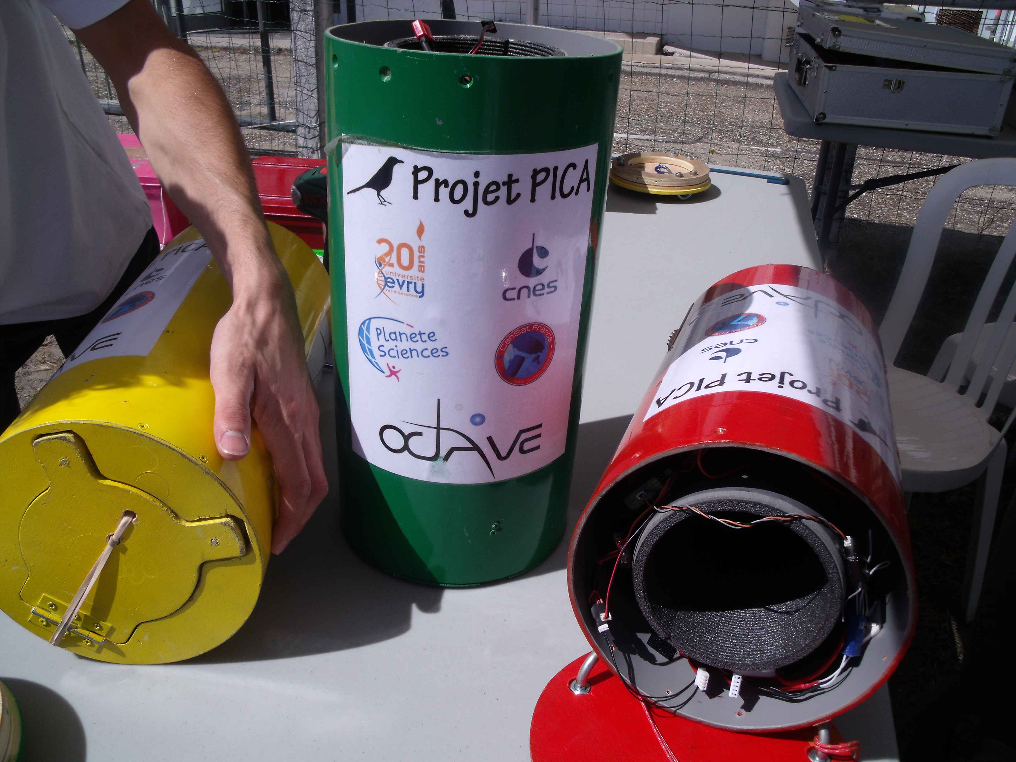
website/images/selec/DSCF3181.JPG
