thriller91/Cansat-SupOp/website/images/selec/DSCF3187.JPG

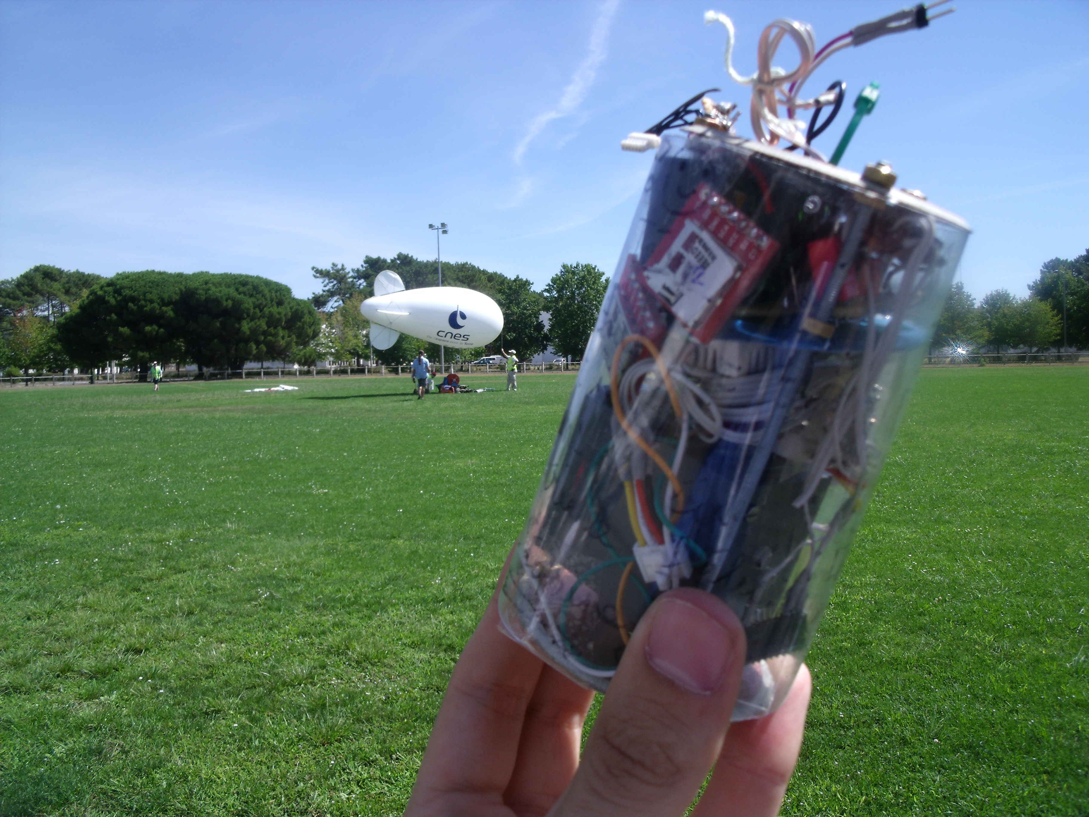
website/images/selec/DSCF3187.JPG
