thriller91/Cansat-SupOp/website/images/selec/DSCF3188.JPG

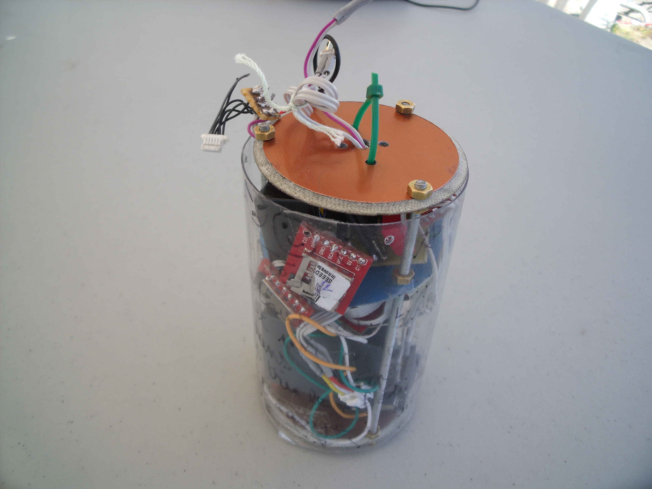
website/images/selec/DSCF3188.JPG
