thriller91/Cansat-SupOp/website/images/selec/DSCF3200.JPG

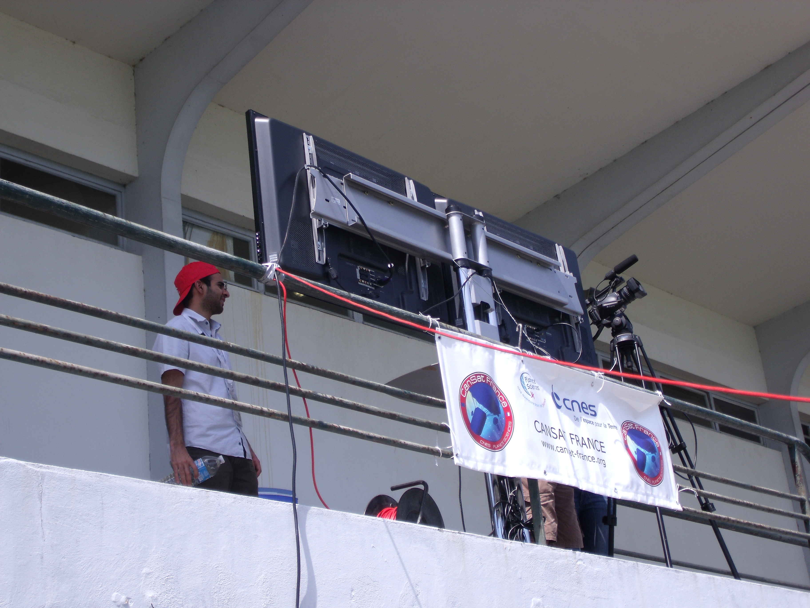
website/images/selec/DSCF3200.JPG
