thriller91/Cansat-SupOp/website/images/selec/DSCF3201.JPG

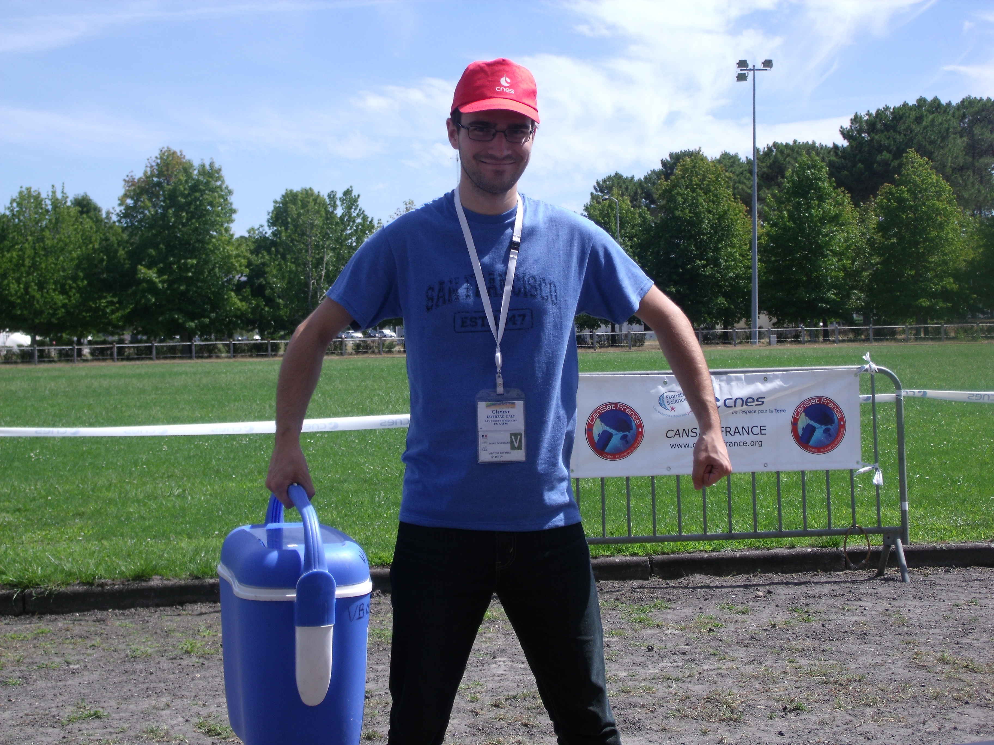
website/images/selec/DSCF3201.JPG
