thriller91/Cansat-SupOp/website/images/selec/DSCF3203.JPG

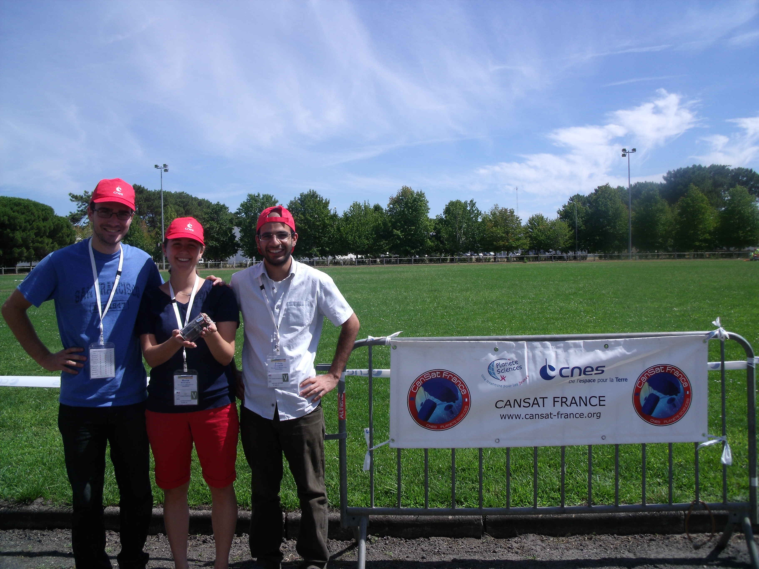
website/images/selec/DSCF3203.JPG
