thriller91/Cansat-SupOp/website/images/selec/DSCF3207.JPG

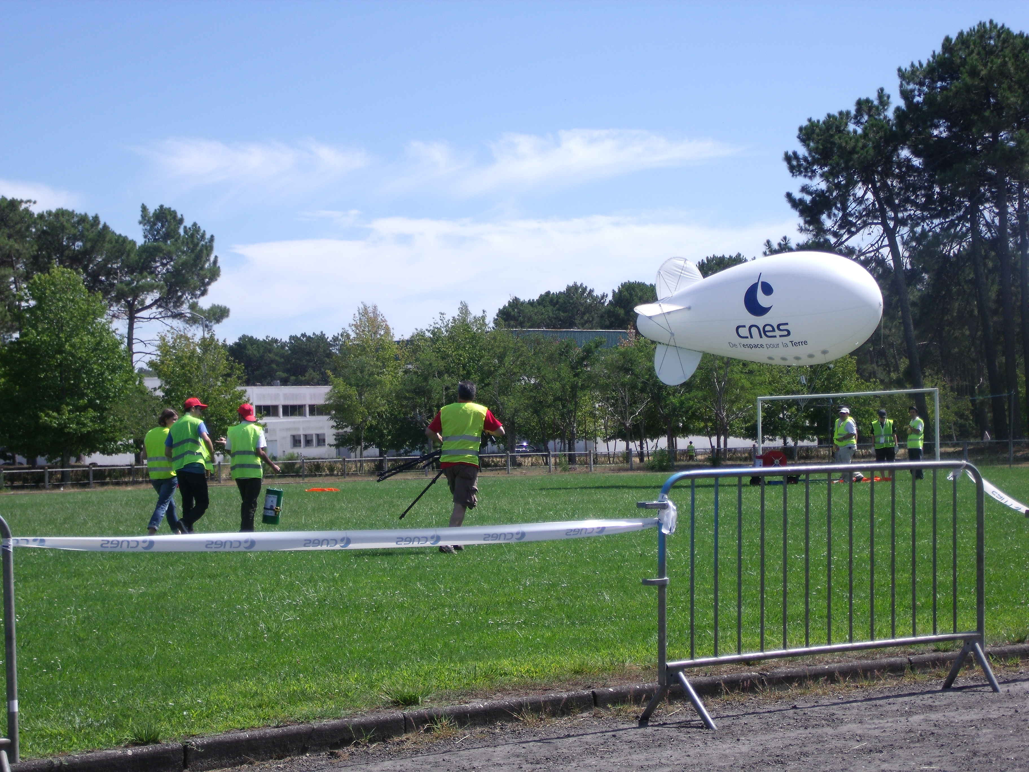
website/images/selec/DSCF3207.JPG
