thriller91/Cansat-SupOp/website/images/selec/DSCF3209.JPG

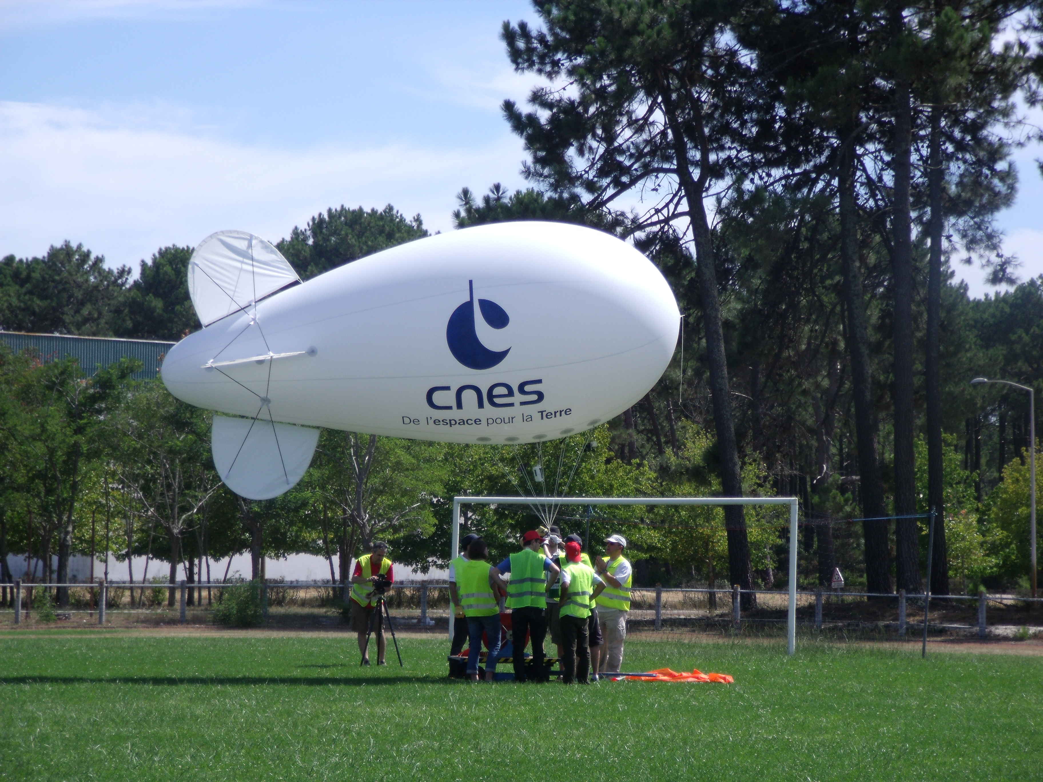
website/images/selec/DSCF3209.JPG
