thriller91/Cansat-SupOp/website/images/selec/DSCF3211.JPG

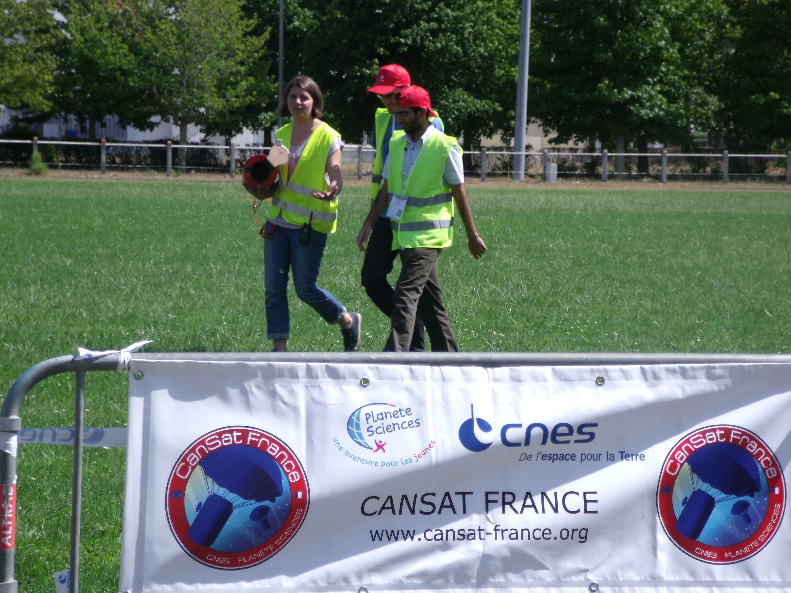
website/images/selec/DSCF3211.JPG
