thriller91/Cansat-SupOp/website/images/selec/DSCF3214.JPG

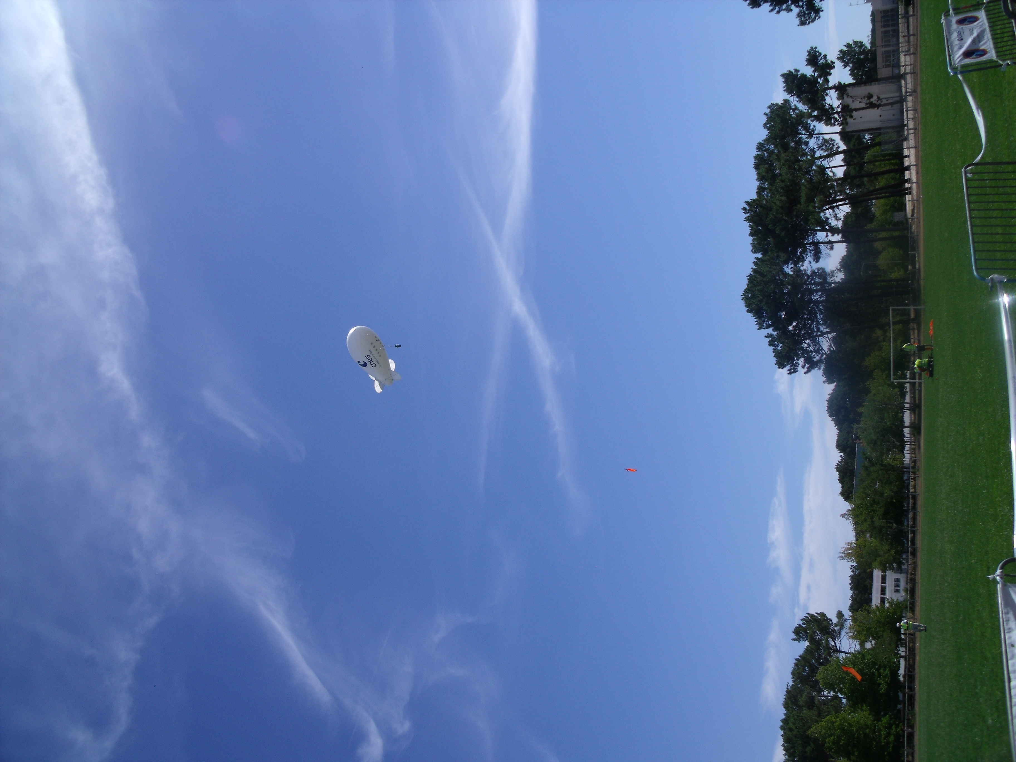
website/images/selec/DSCF3214.JPG
