thriller91/Cansat-SupOp/website/images/selec/DSCF3219.JPG

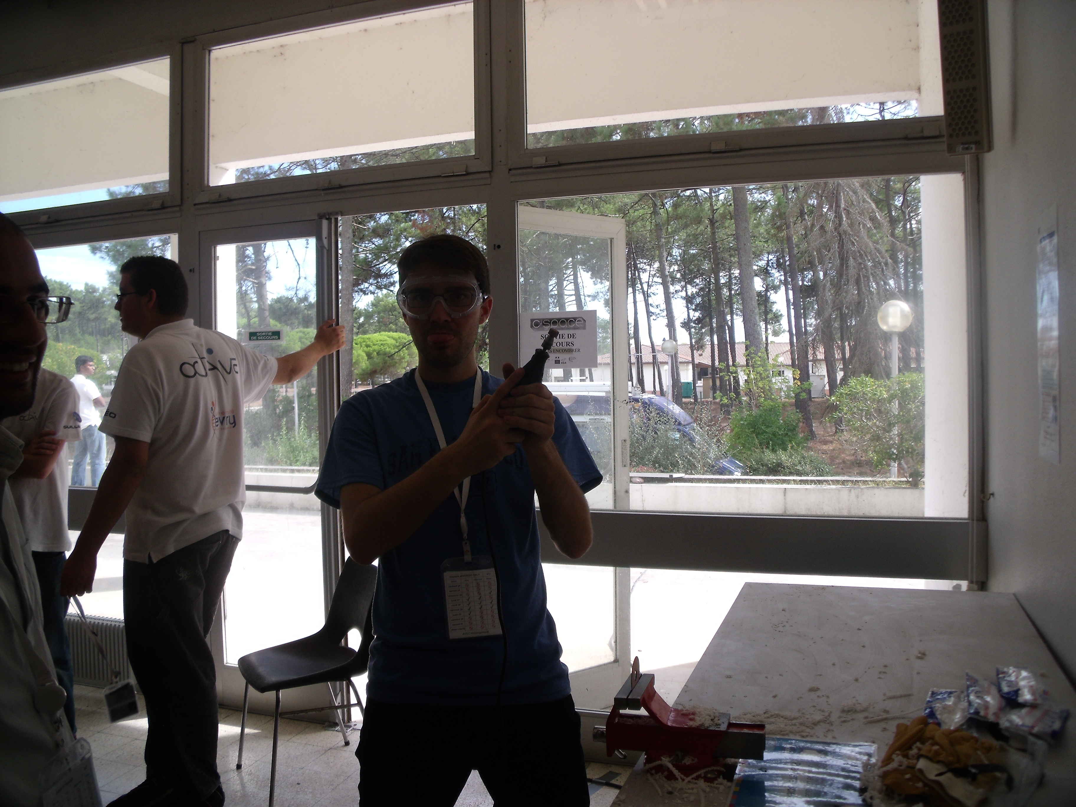
website/images/selec/DSCF3219.JPG
