thriller91/Cansat-SupOp/website/images/selec/DSCF3220.JPG

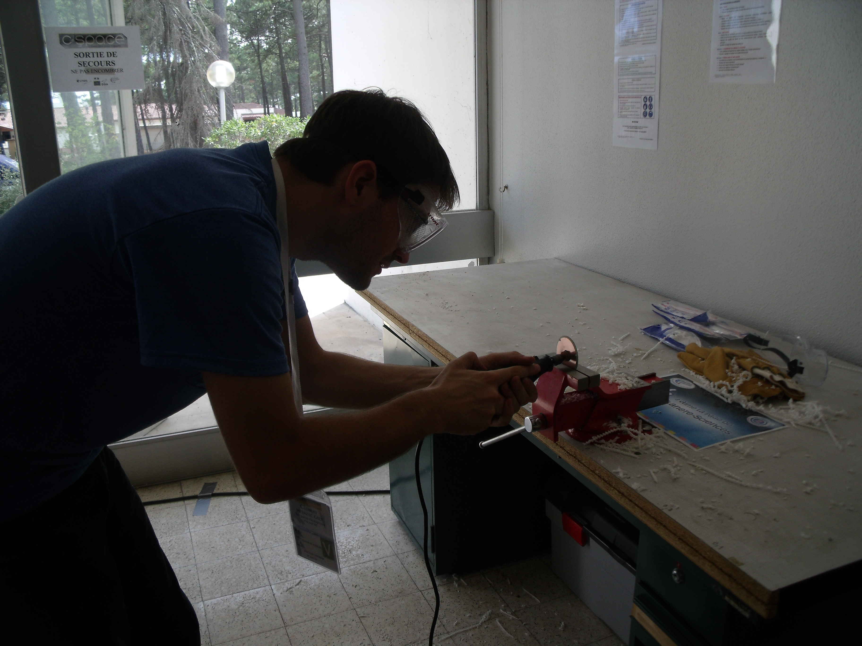
website/images/selec/DSCF3220.JPG
