thriller91/Cansat-SupOp/website/images/selec/DSCF3222.JPG

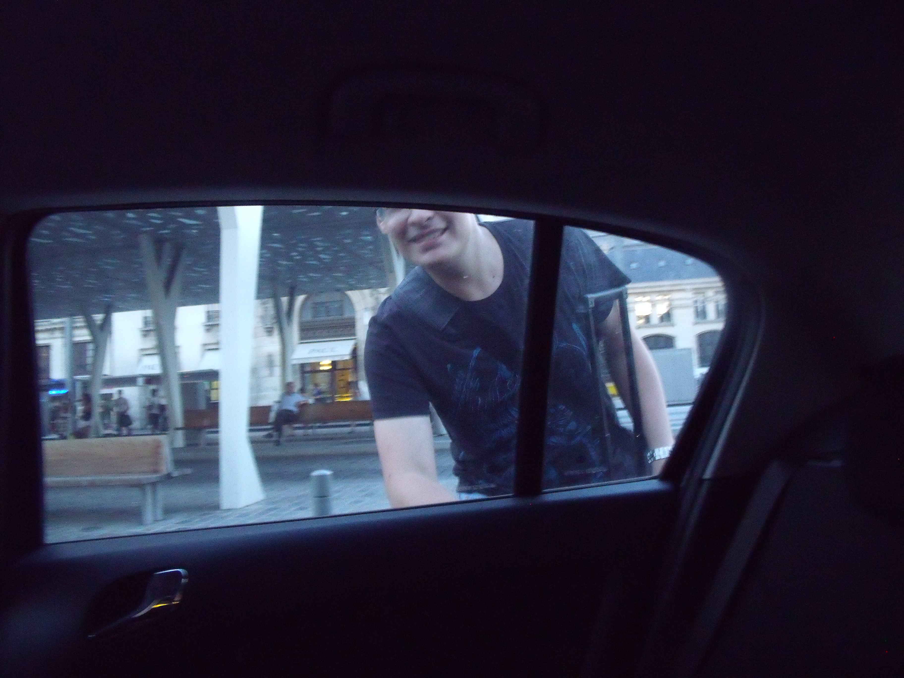
website/images/selec/DSCF3222.JPG
