thriller91/Cansat-SupOp/website/images/selec/DSCF3223.JPG

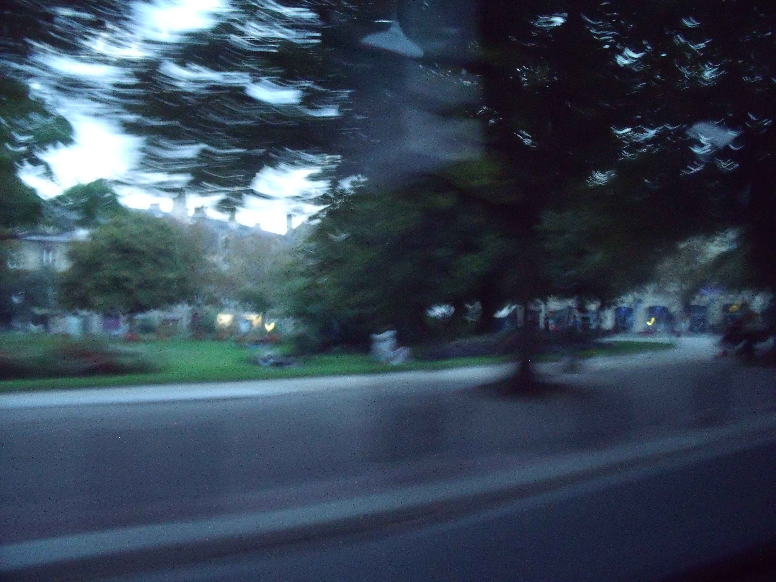
website/images/selec/DSCF3223.JPG
