thriller91/Cansat-SupOp/website/images/selec/DSCF3224.JPG

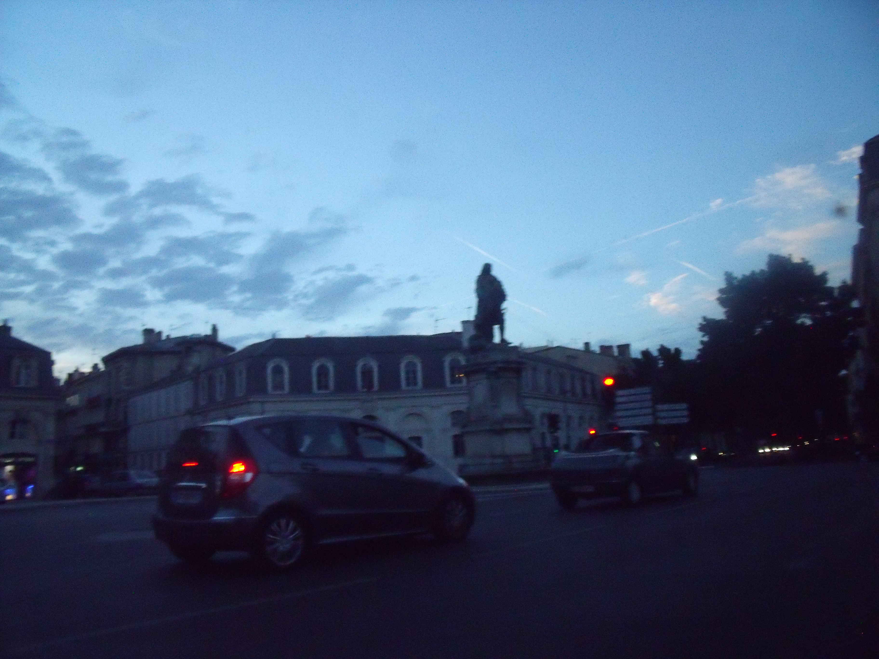
website/images/selec/DSCF3224.JPG
