thriller91/Cansat-SupOp/website/images/selec/DSCF3228.JPG

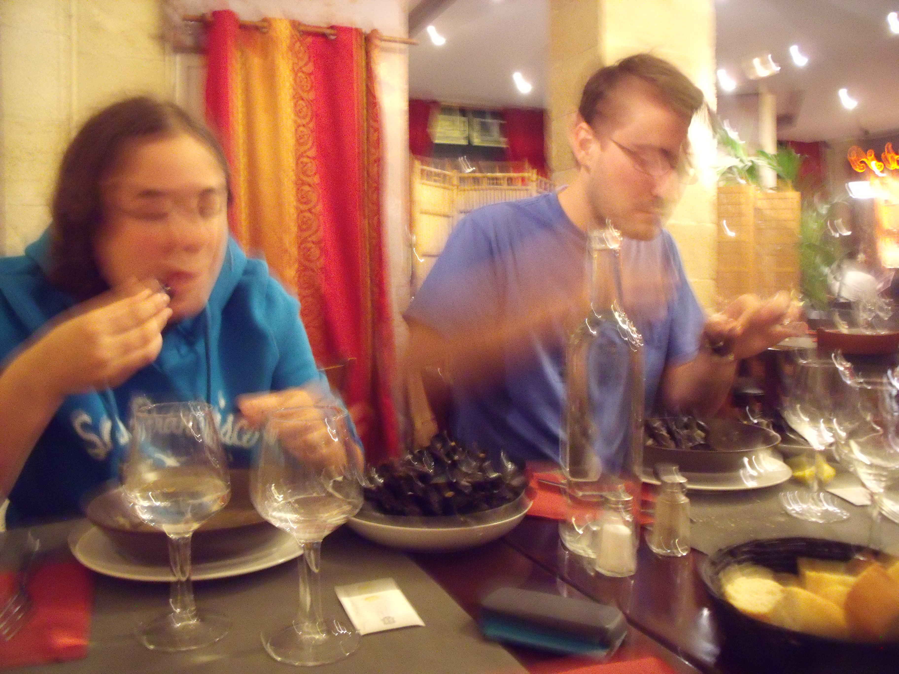
website/images/selec/DSCF3228.JPG
