thriller91/Cansat-SupOp/website/images/selec/DSCF3235.JPG

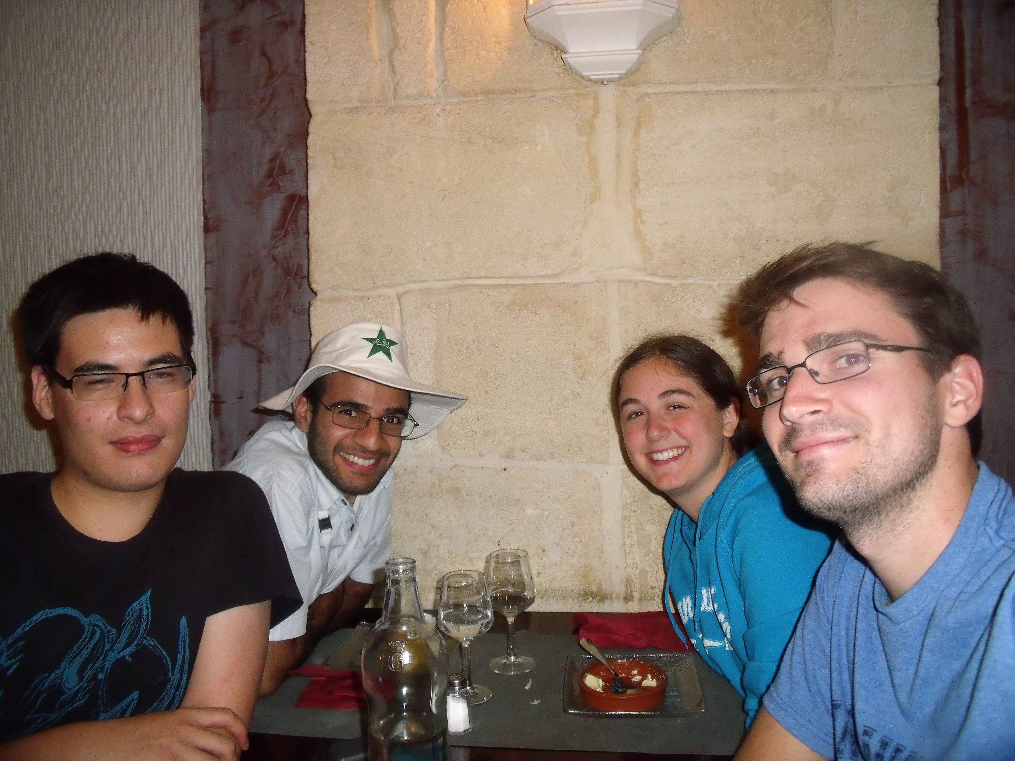
website/images/selec/DSCF3235.JPG
