thriller91/Cansat-SupOp/website/images/selec/DSCF3244.JPG

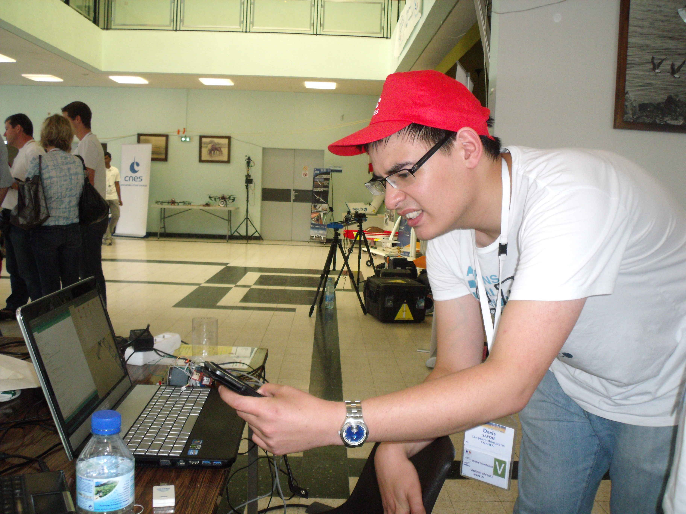
website/images/selec/DSCF3244.JPG
