thriller91/Cansat-SupOp/website/images/selec/DSCF3253.JPG

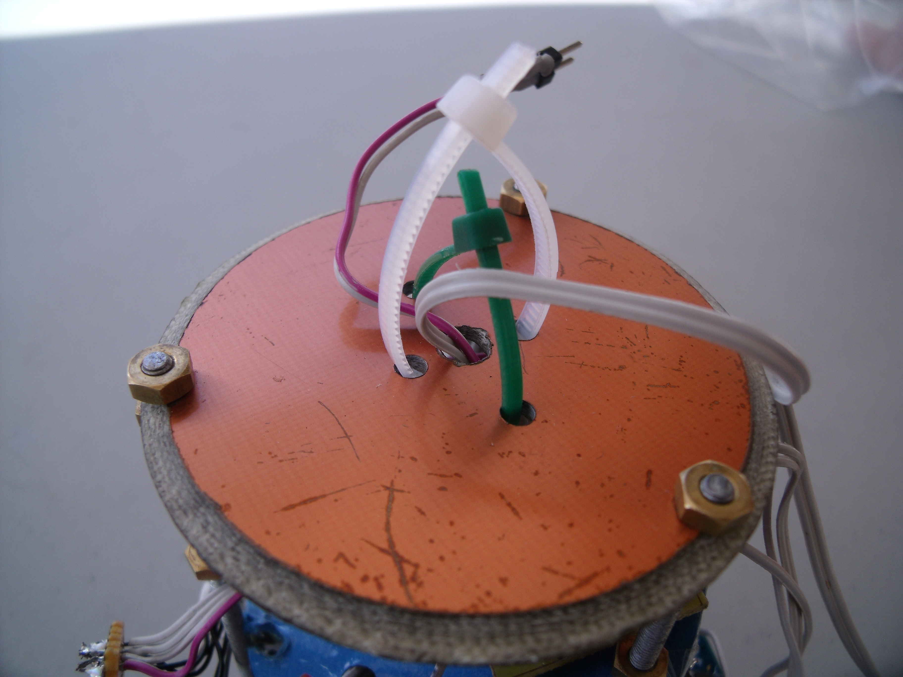
website/images/selec/DSCF3253.JPG
