thriller91/Cansat-SupOp/website/images/selec/DSCF3254.JPG

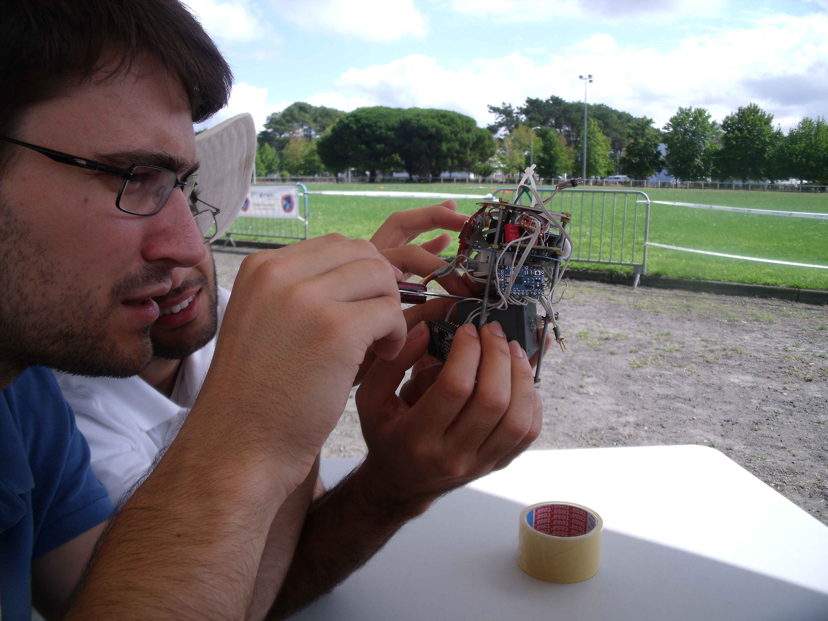
website/images/selec/DSCF3254.JPG
