thriller91/Cansat-SupOp/website/images/selec/DSCF3255.JPG

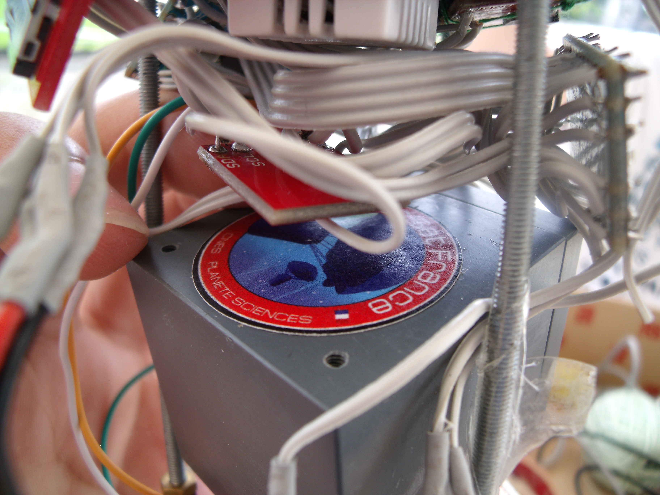
website/images/selec/DSCF3255.JPG
