thriller91/Cansat-SupOp/website/images/selec/DSCF3259.JPG

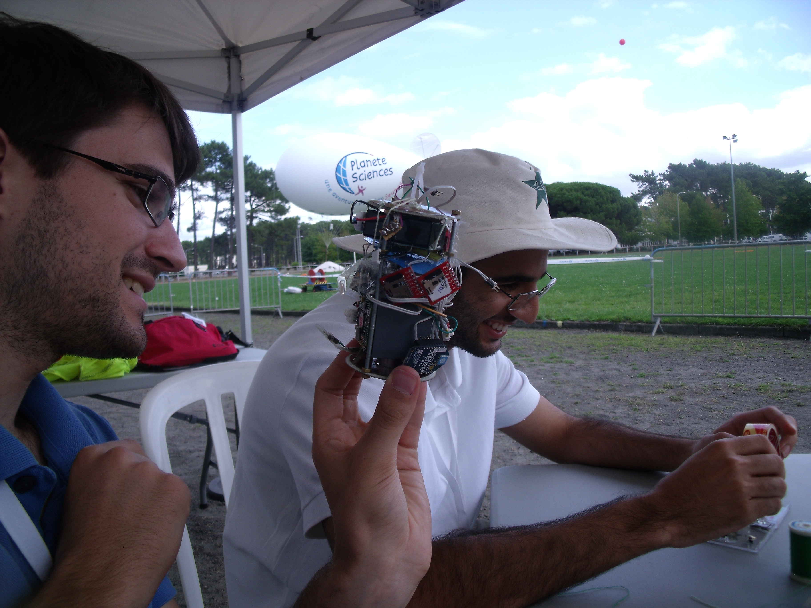
website/images/selec/DSCF3259.JPG
