thriller91/Cansat-SupOp/website/images/selec/DSCF3260.JPG

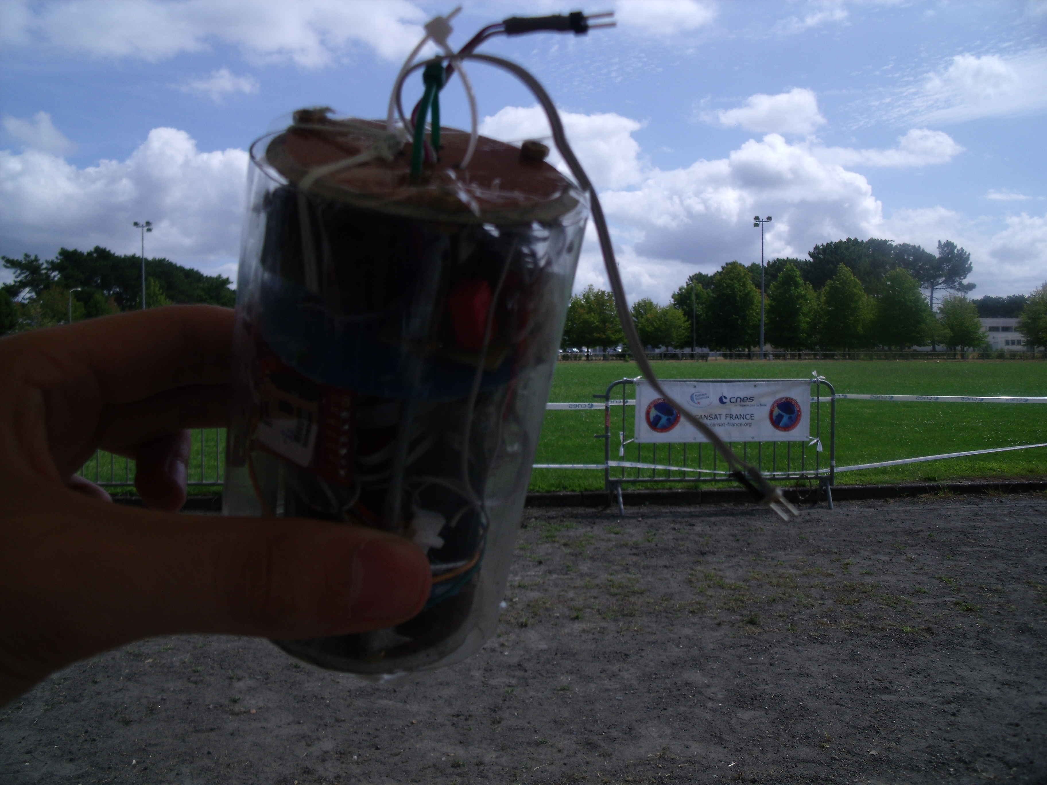
website/images/selec/DSCF3260.JPG
