thriller91/Cansat-SupOp/website/images/selec/DSCF3261.JPG

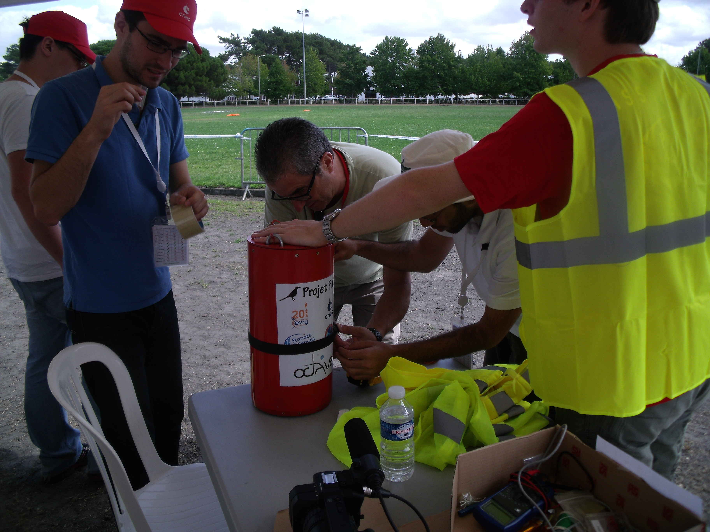
website/images/selec/DSCF3261.JPG
