thriller91/Cansat-SupOp/website/images/selec/DSCF3262.JPG

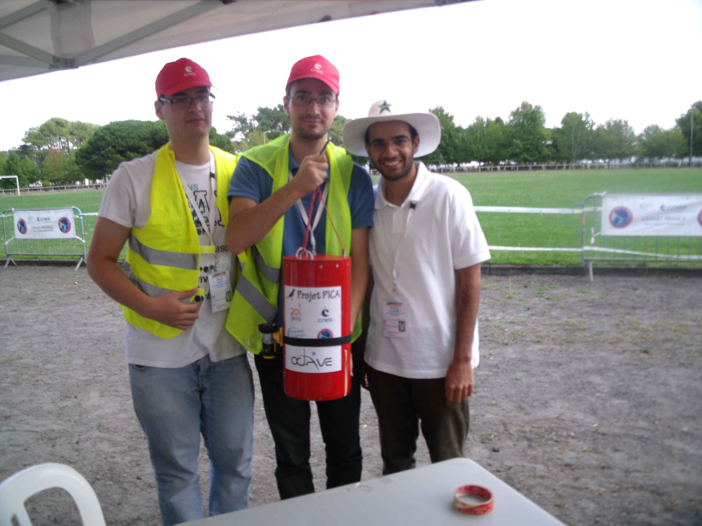
website/images/selec/DSCF3262.JPG
