thriller91/Cansat-SupOp/website/images/selec/DSCF3264.JPG

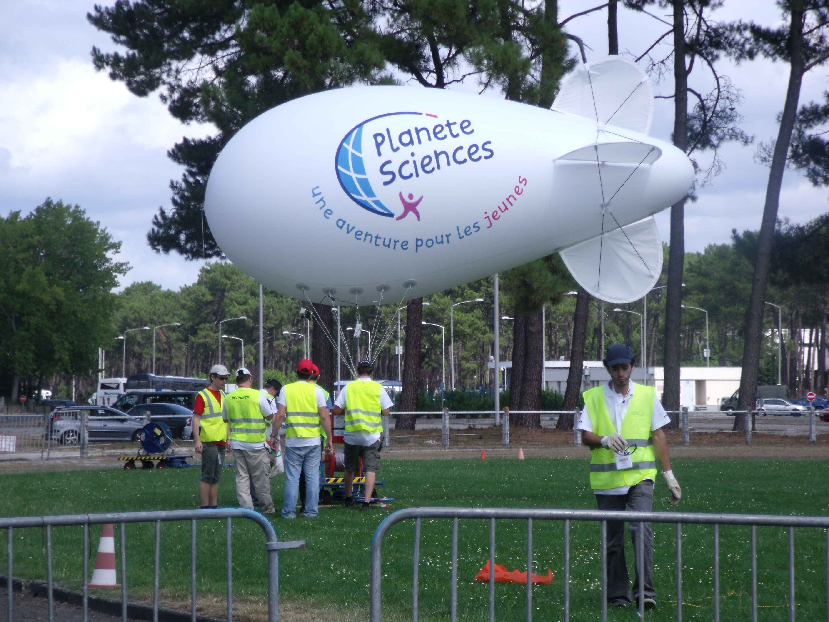
website/images/selec/DSCF3264.JPG
