thriller91/Cansat-SupOp/website/images/selec/DSCF3266.JPG

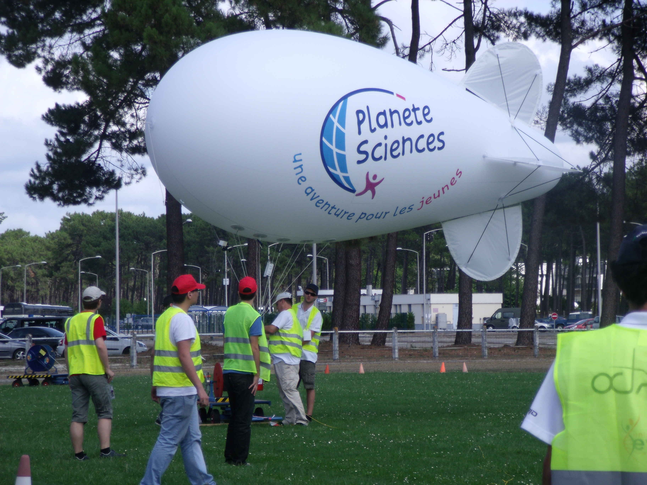
website/images/selec/DSCF3266.JPG
