thriller91/Cansat-SupOp/website/images/selec/DSCF3269.JPG

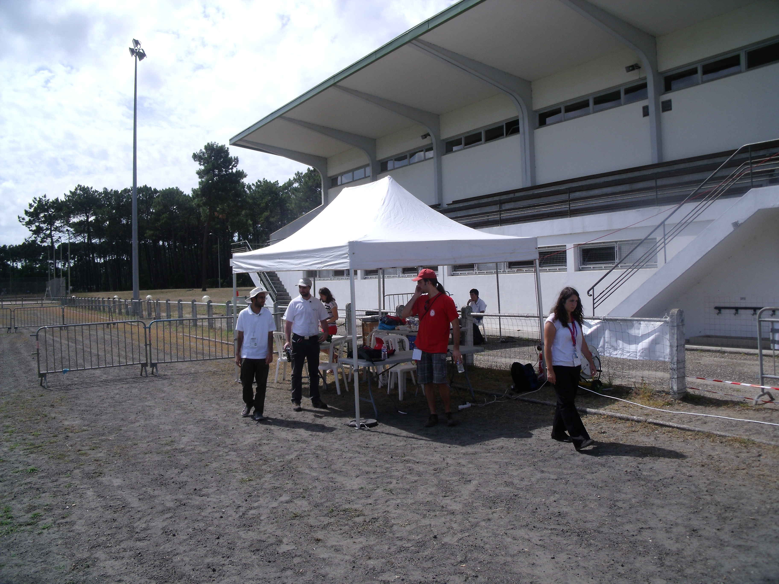
website/images/selec/DSCF3269.JPG
