thriller91/Cansat-SupOp/website/images/selec/DSCF3271.JPG

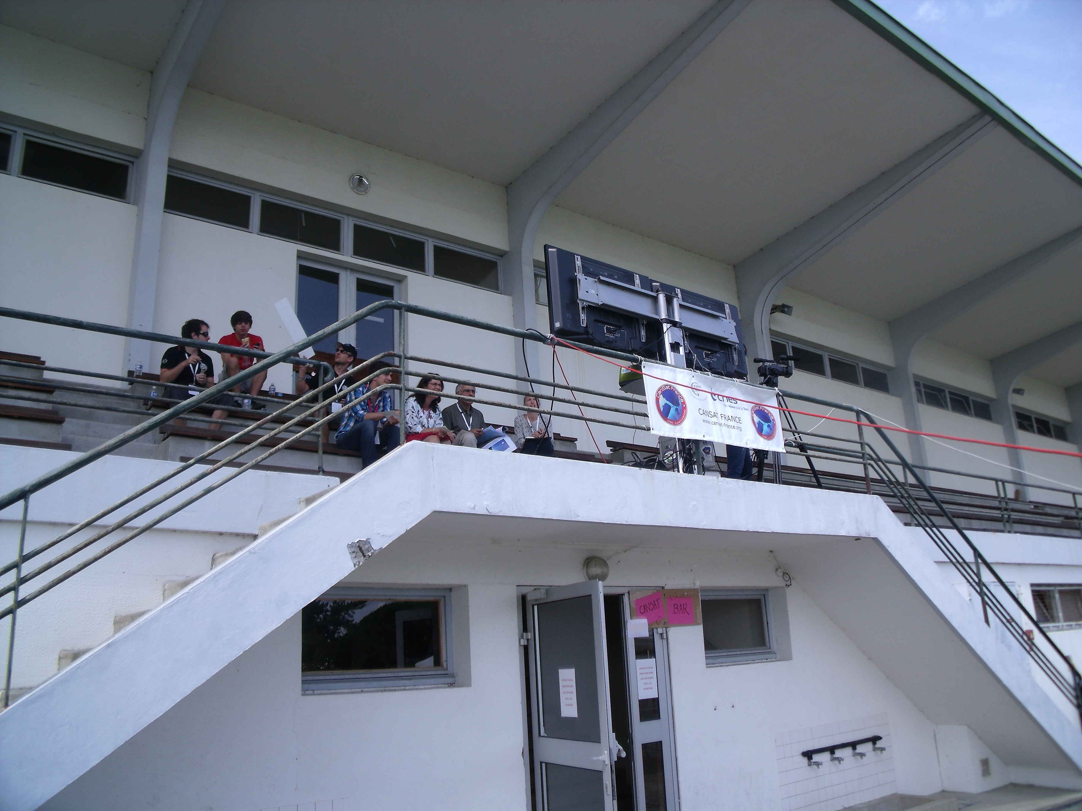
website/images/selec/DSCF3271.JPG
