thriller91/Cansat-SupOp/website/images/selec/DSCF3273.JPG

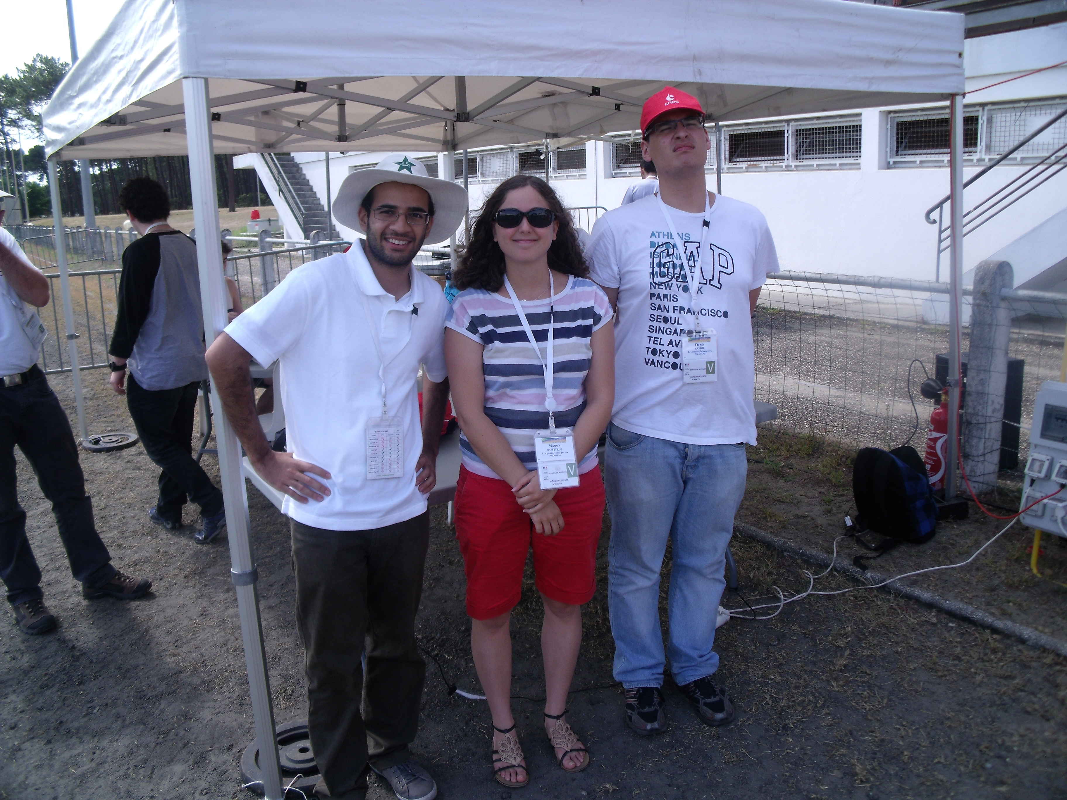
website/images/selec/DSCF3273.JPG
