thriller91/Cansat-SupOp/website/images/selec/DSCF3276.JPG

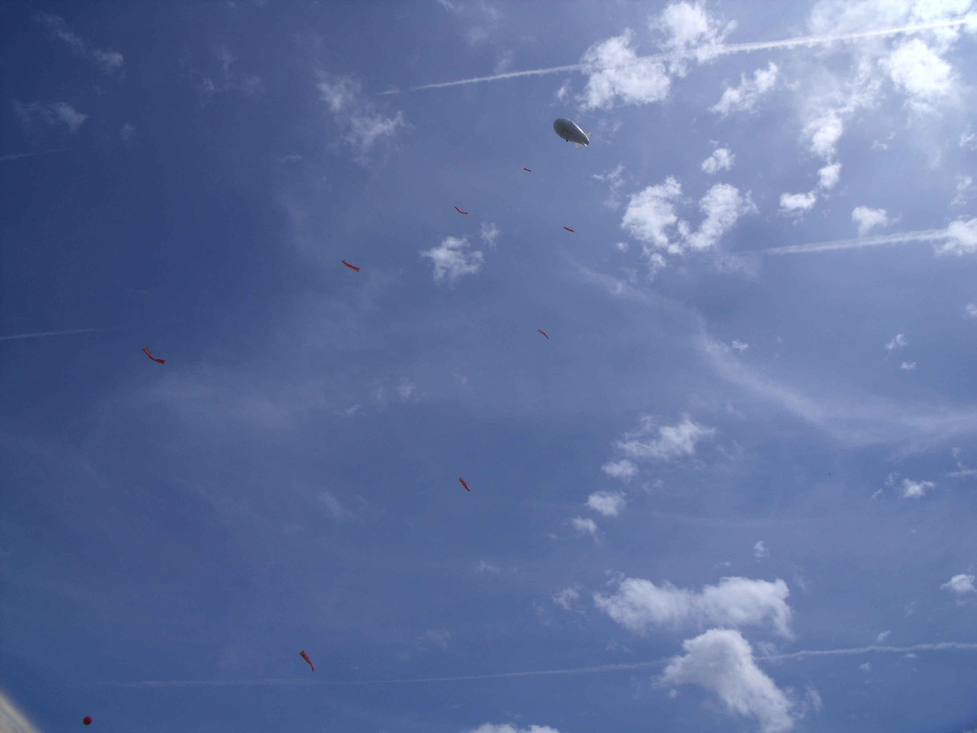
website/images/selec/DSCF3276.JPG
