thriller91/Cansat-SupOp/website/images/selec/DSCF3283.JPG

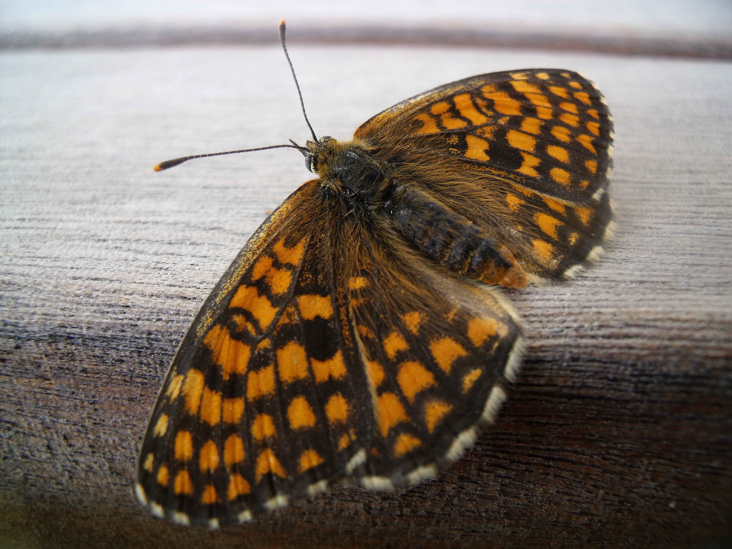
website/images/selec/DSCF3283.JPG
