thriller91/Cansat-SupOp/website/images/selec/DSCF3285.JPG

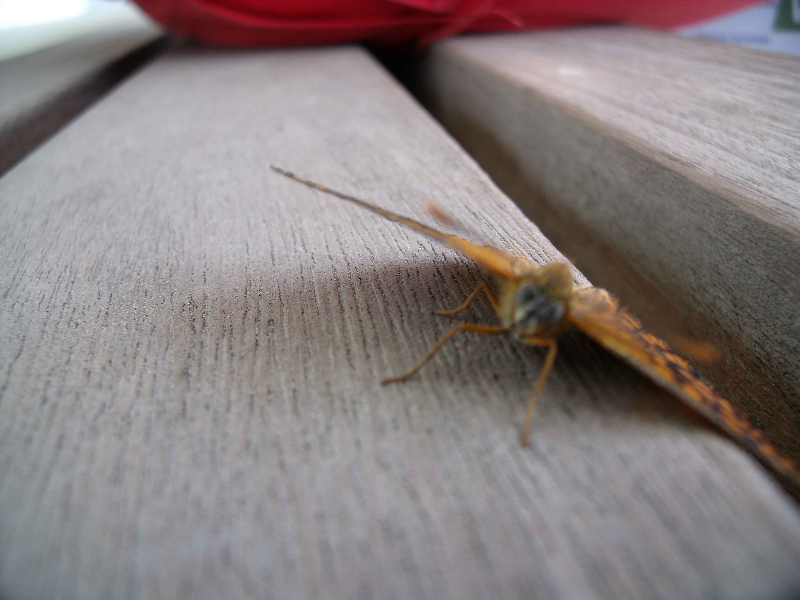
website/images/selec/DSCF3285.JPG
