thriller91/Cansat-SupOp/website/images/selec/DSCF3289.JPG

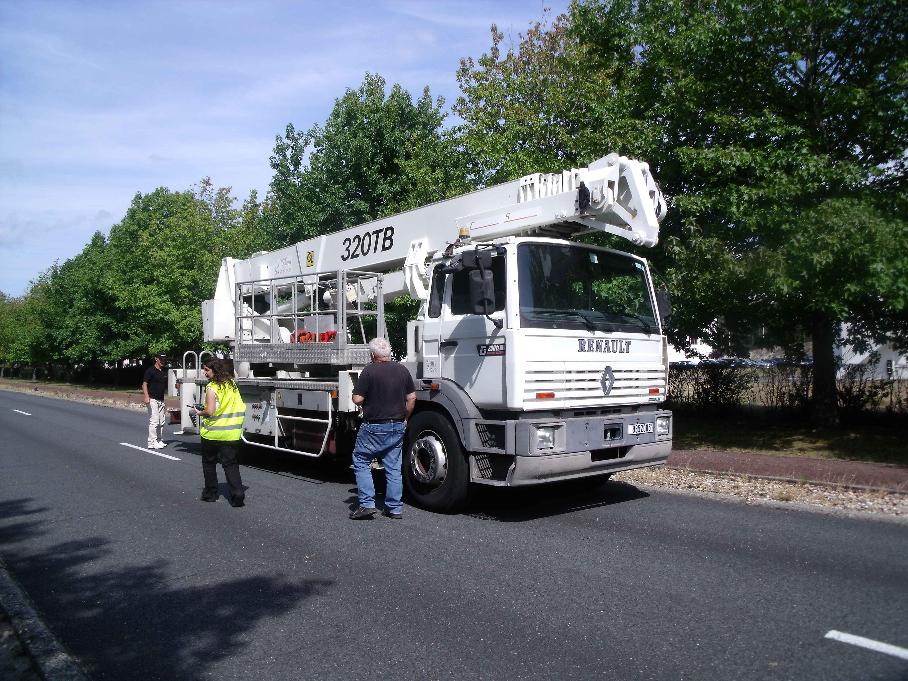
website/images/selec/DSCF3289.JPG
