thriller91/Cansat-SupOp/website/images/selec/DSCF3296.JPG

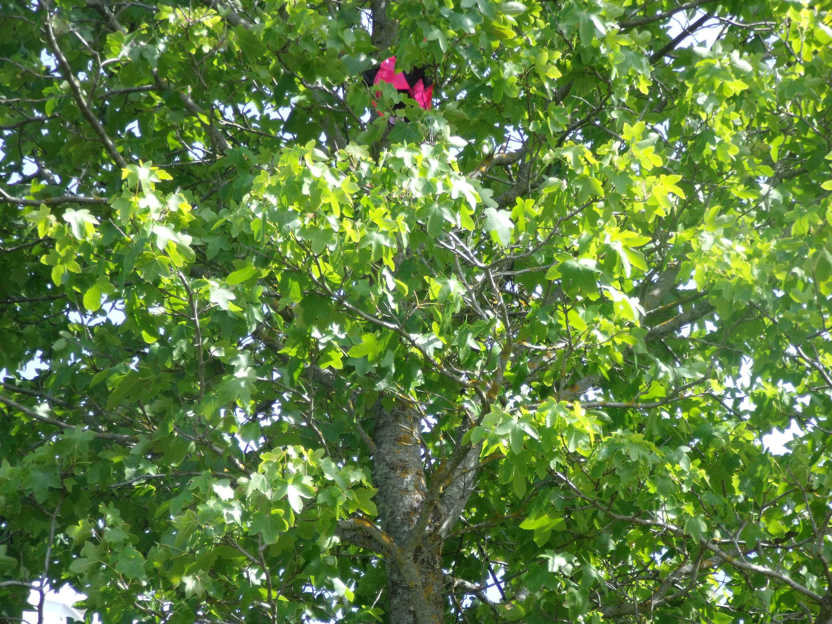
website/images/selec/DSCF3296.JPG
