thriller91/Cansat-SupOp/website/images/selec/DSCF3302.JPG

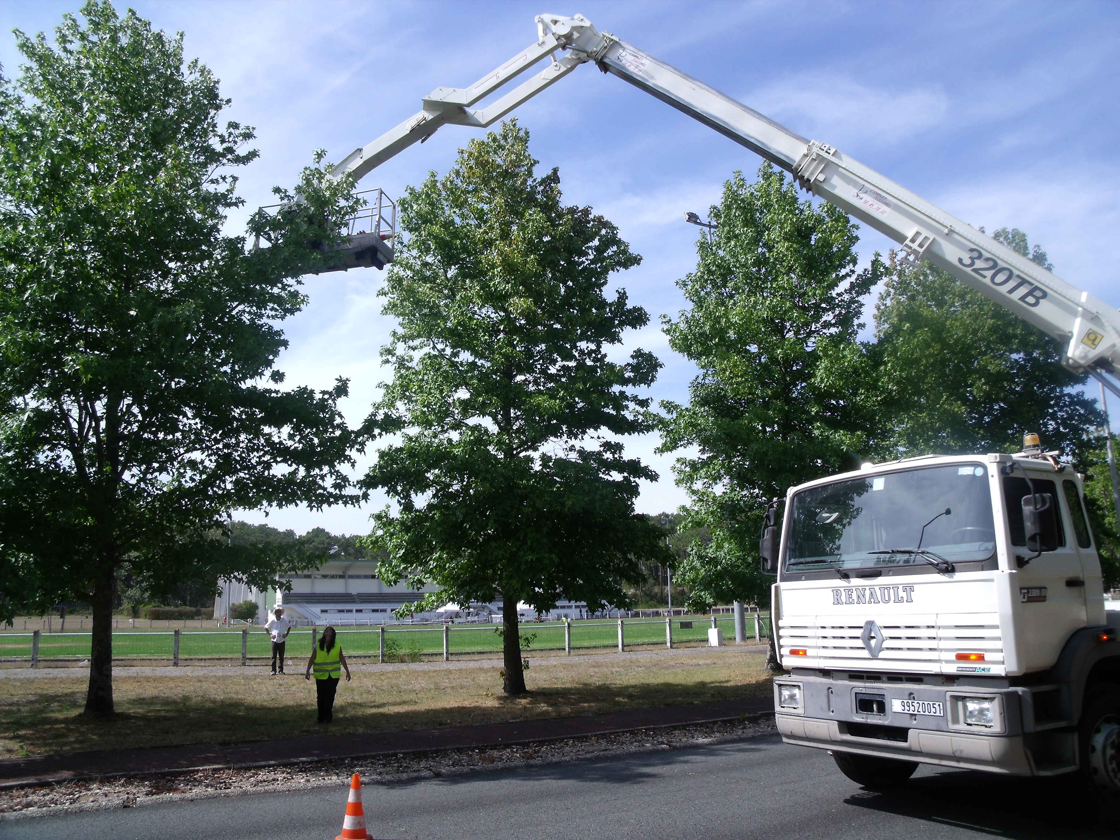
website/images/selec/DSCF3302.JPG
