thriller91/Cansat-SupOp/website/images/selec/DSCF3311.JPG

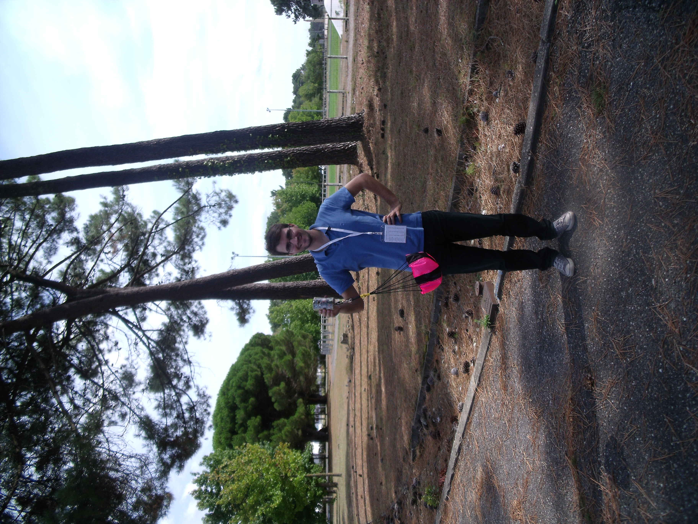
website/images/selec/DSCF3311.JPG
