thriller91/Cansat-SupOp/website/images/selec/DSCF3313.JPG

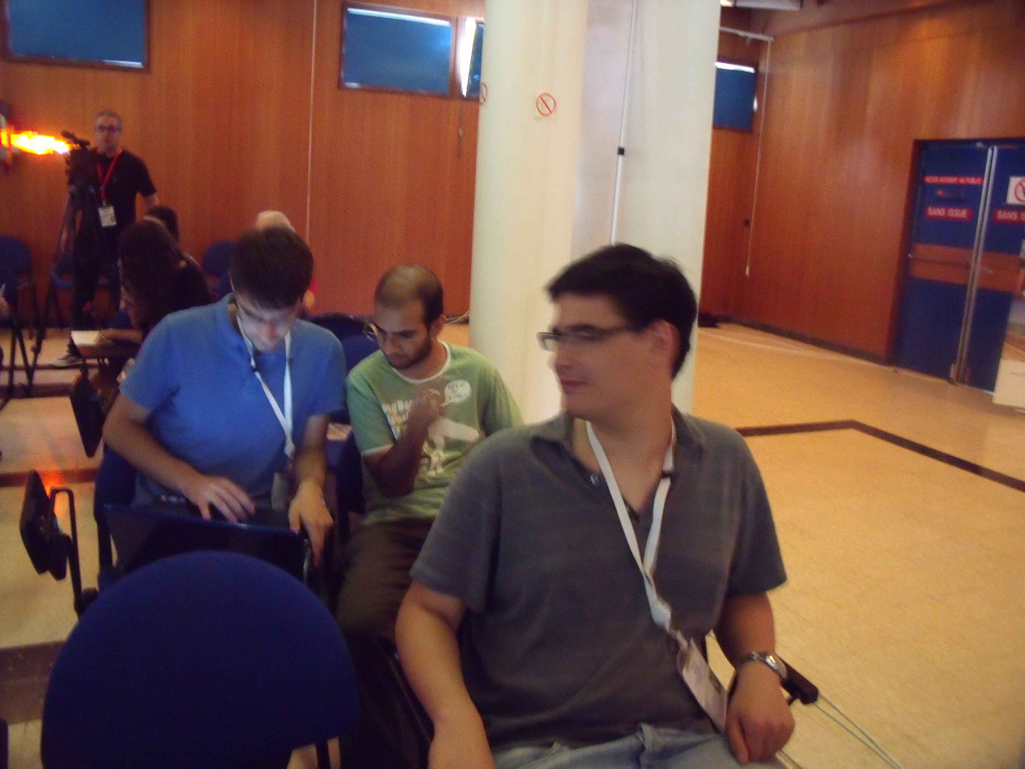
website/images/selec/DSCF3313.JPG
