thriller91/Cansat-SupOp/website/images/selec/DSCF3315.JPG

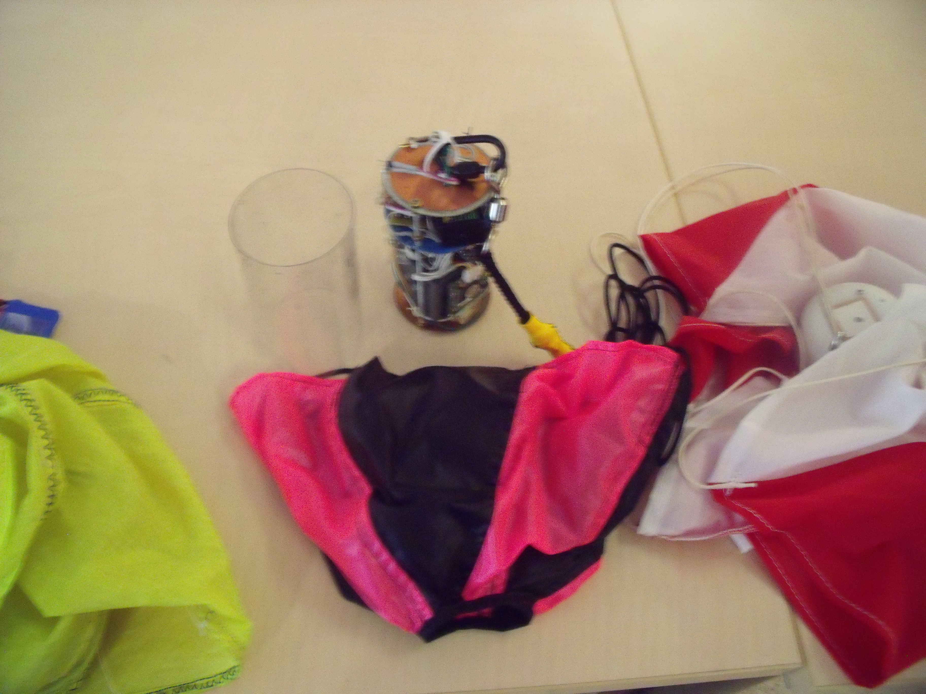
website/images/selec/DSCF3315.JPG
