thriller91/Cansat-SupOp/website/images/selec/DSCF3316.JPG

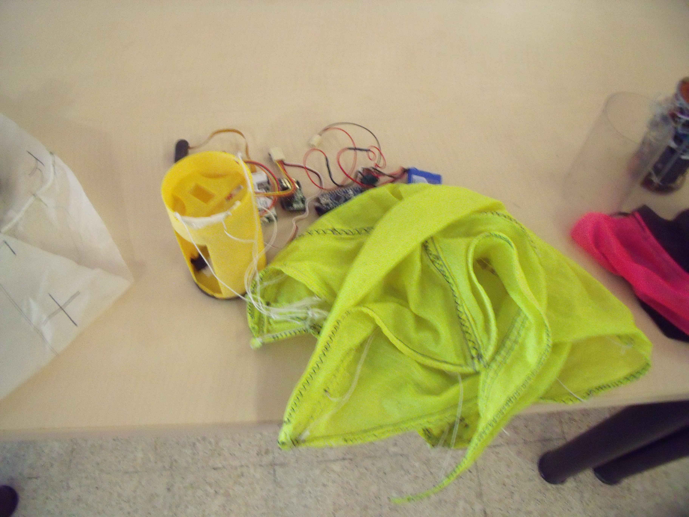
website/images/selec/DSCF3316.JPG
