thriller91/Cansat-SupOp/website/images/selec/DSCF3317.JPG

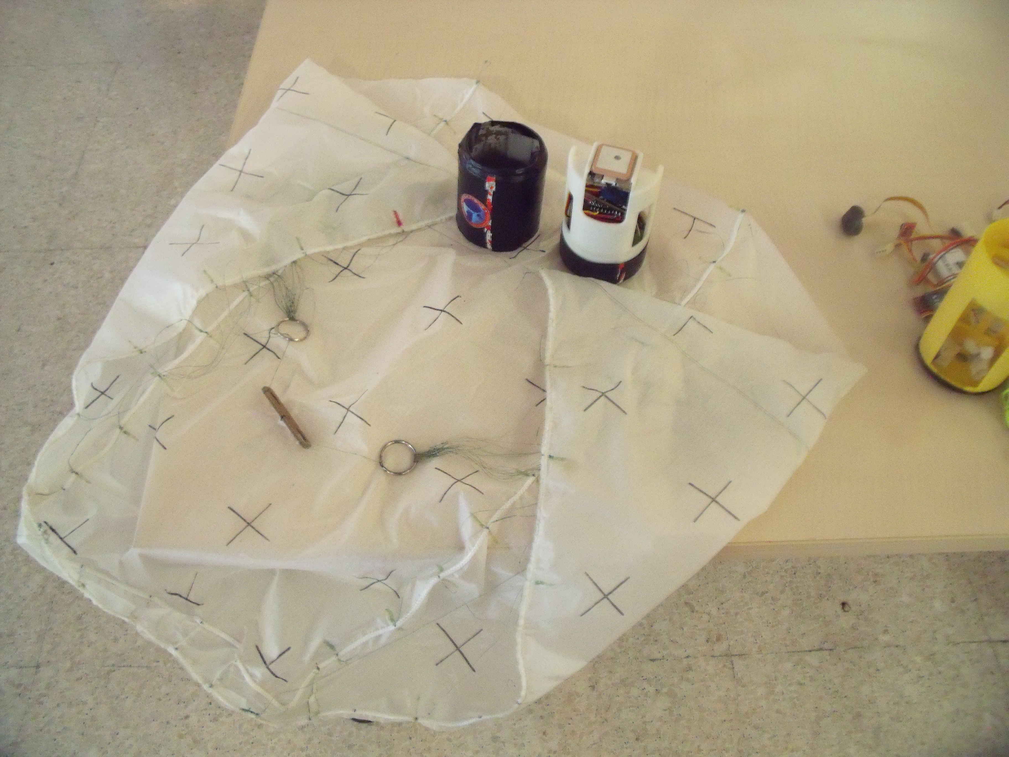
website/images/selec/DSCF3317.JPG
