thriller91/Cansat-SupOp/website/images/selec/DSCF3318.JPG

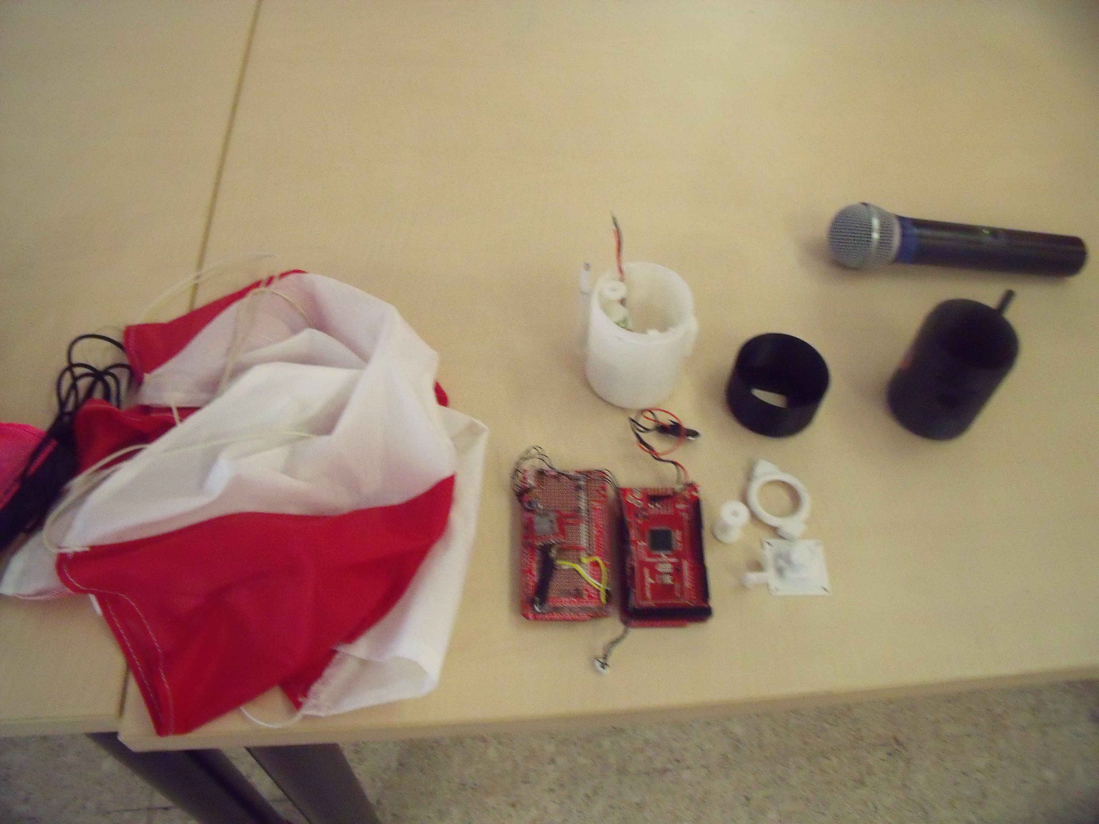
website/images/selec/DSCF3318.JPG
