thriller91/Cansat-SupOp/website/images/selec/DSCF3319.JPG

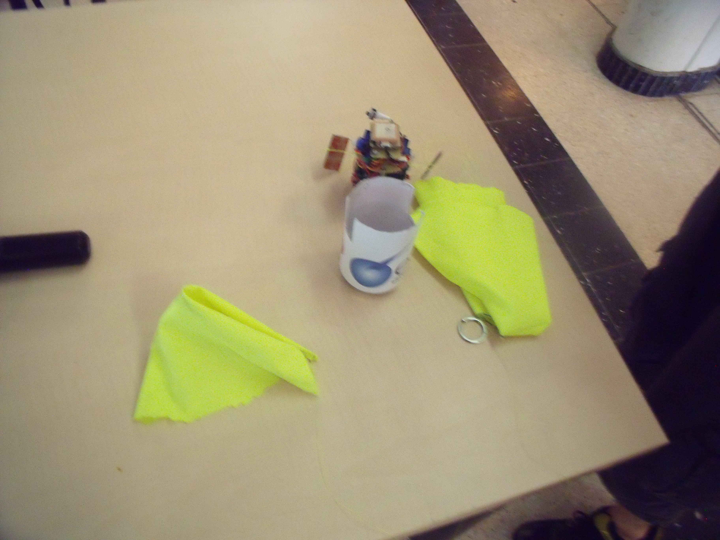
website/images/selec/DSCF3319.JPG
