thriller91/Cansat-SupOp/website/images/selec/DSCF3322.JPG

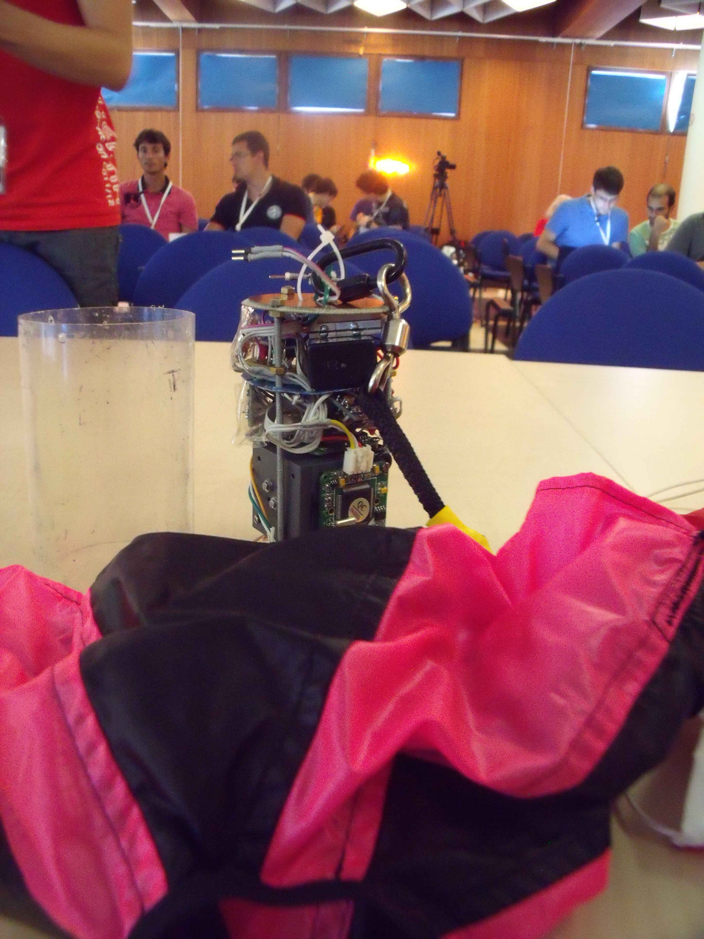
website/images/selec/DSCF3322.JPG
