thriller91/Cansat-SupOp/website/images/selec/DSCF3323.JPG

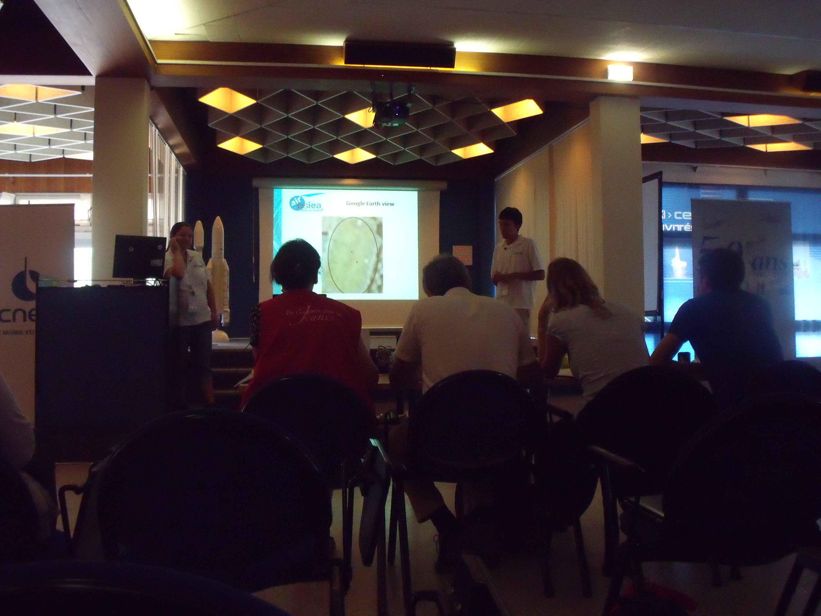
website/images/selec/DSCF3323.JPG
