thriller91/Cansat-SupOp/website/images/selec/DSCF3330.JPG

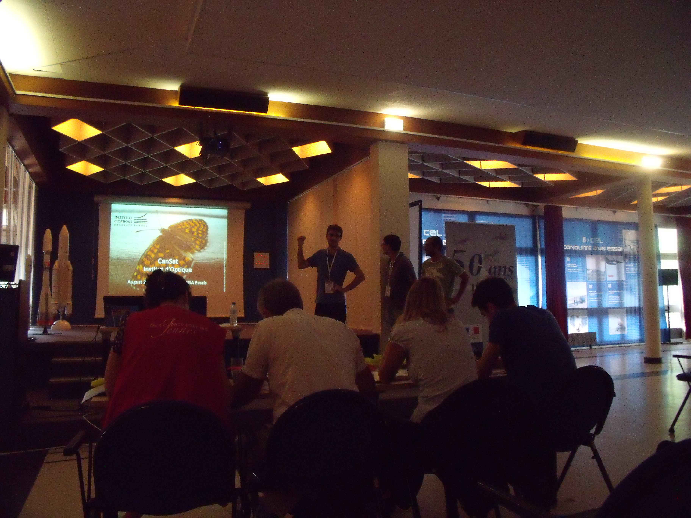
website/images/selec/DSCF3330.JPG
