thriller91/Cansat-SupOp/website/images/selec/DSCF3333.JPG

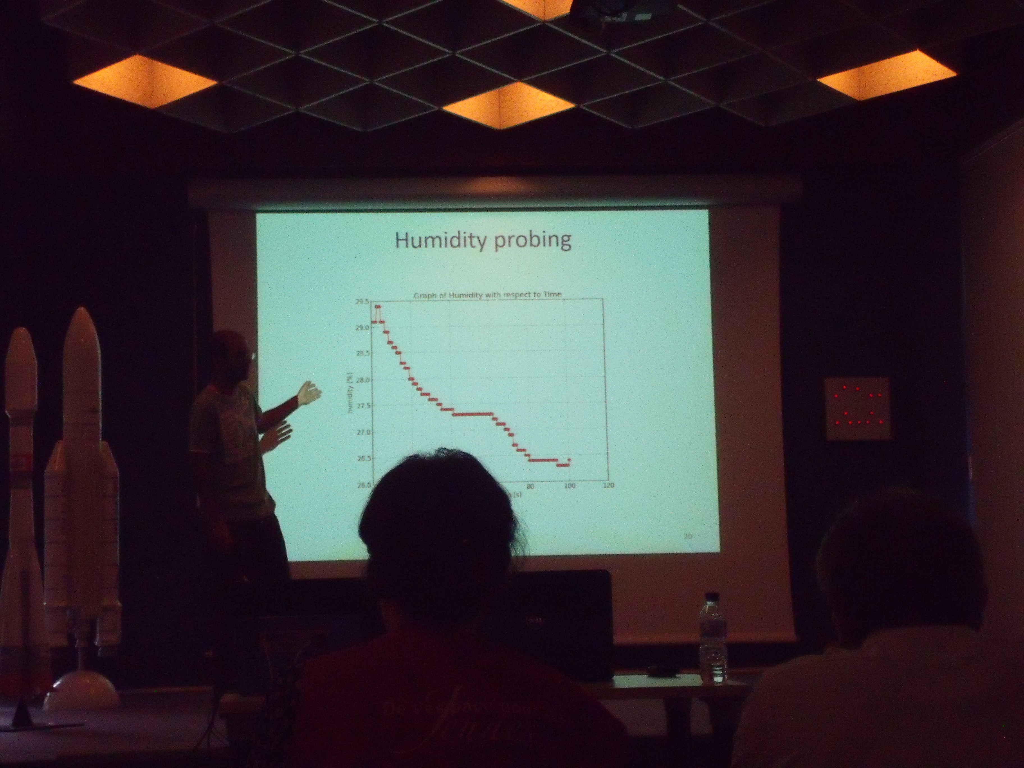
website/images/selec/DSCF3333.JPG
