thriller91/Cansat-SupOp/website/images/selec/DSCF3336.JPG

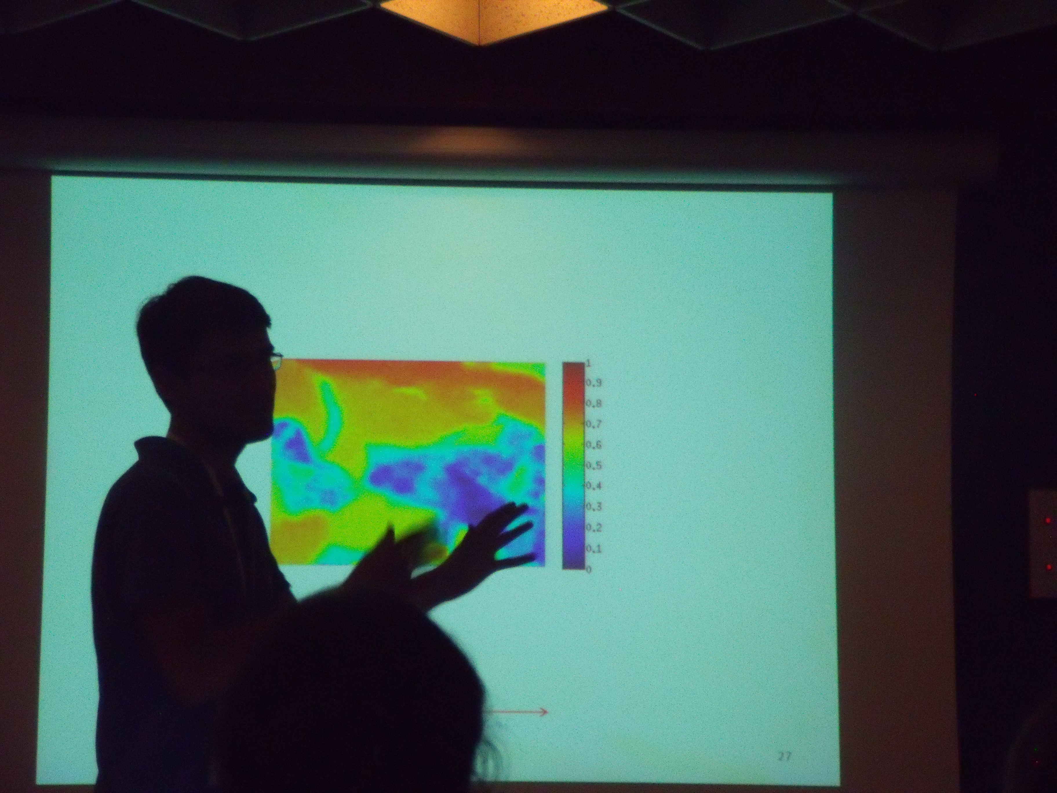
website/images/selec/DSCF3336.JPG
