thriller91/Cansat-SupOp/website/images/selec/DSCF3341.JPG

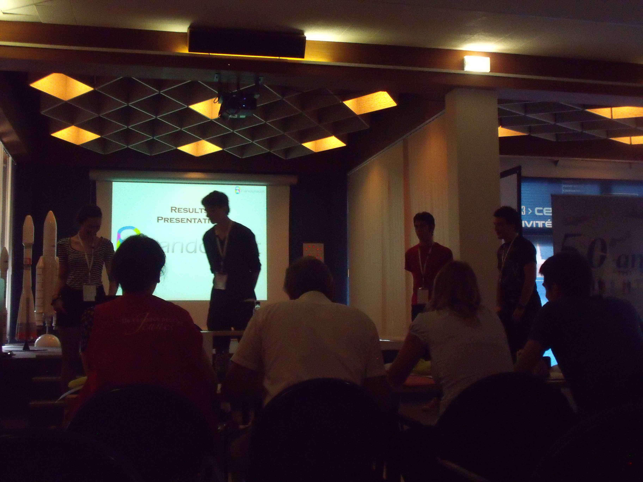
website/images/selec/DSCF3341.JPG
