thriller91/Cansat-SupOp/website/images/selec/DSCF3342.JPG

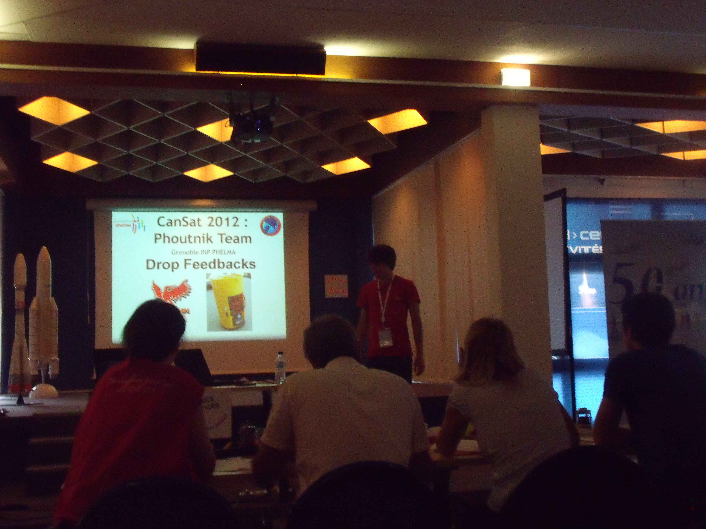
website/images/selec/DSCF3342.JPG
