thriller91/Cansat-SupOp/website/images/selec/DSCF3343.JPG

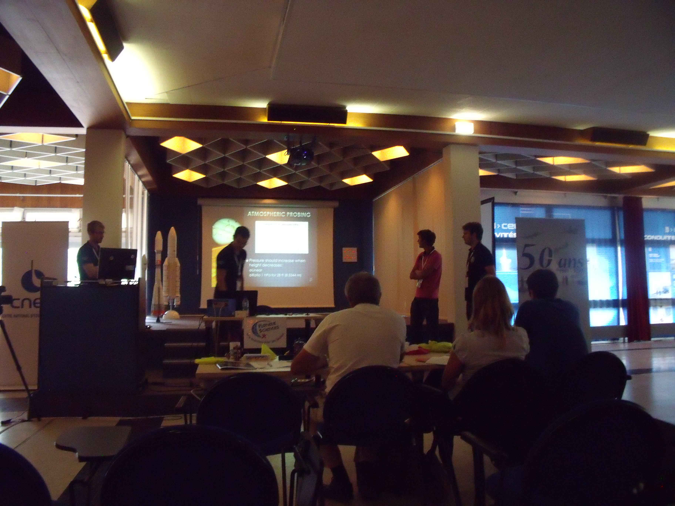
website/images/selec/DSCF3343.JPG
