thriller91/Cansat-SupOp/website/images/selec/DSCF3352.JPG

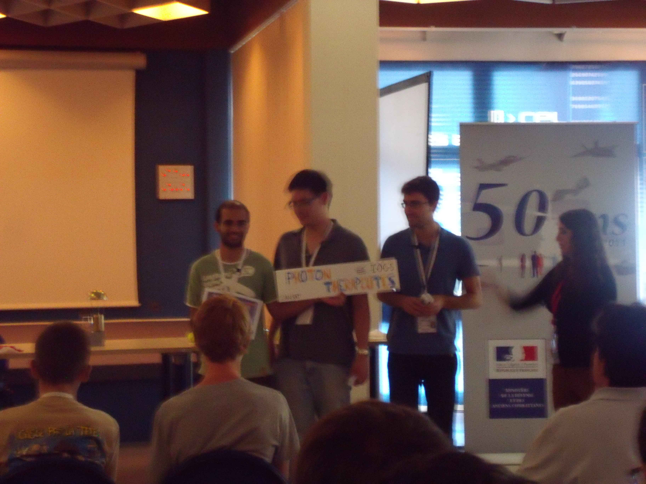
website/images/selec/DSCF3352.JPG
