thriller91/Cansat-SupOp/website/images/selec/DSCF3356.JPG

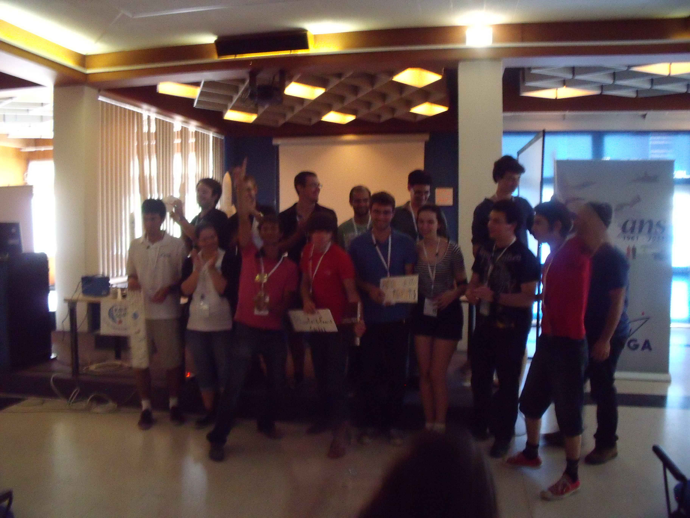
website/images/selec/DSCF3356.JPG
