thriller91/Cansat-SupOp/website/images/selec/DSCF3373.JPG

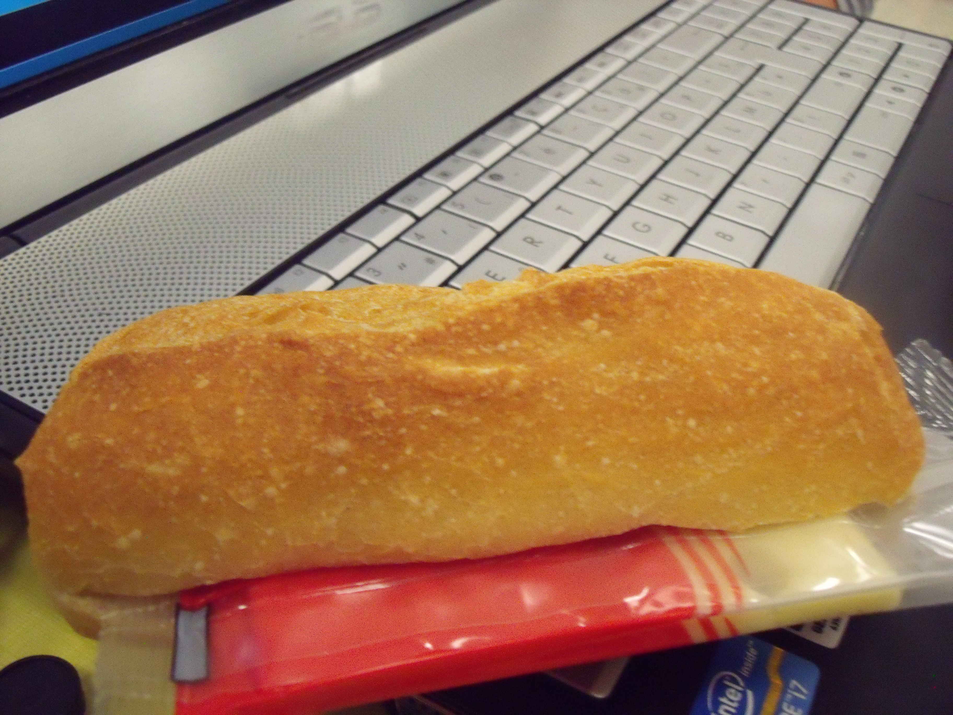
website/images/selec/DSCF3373.JPG
