thriller91/Cansat-SupOp/website/images/selec/DSCF3376.JPG

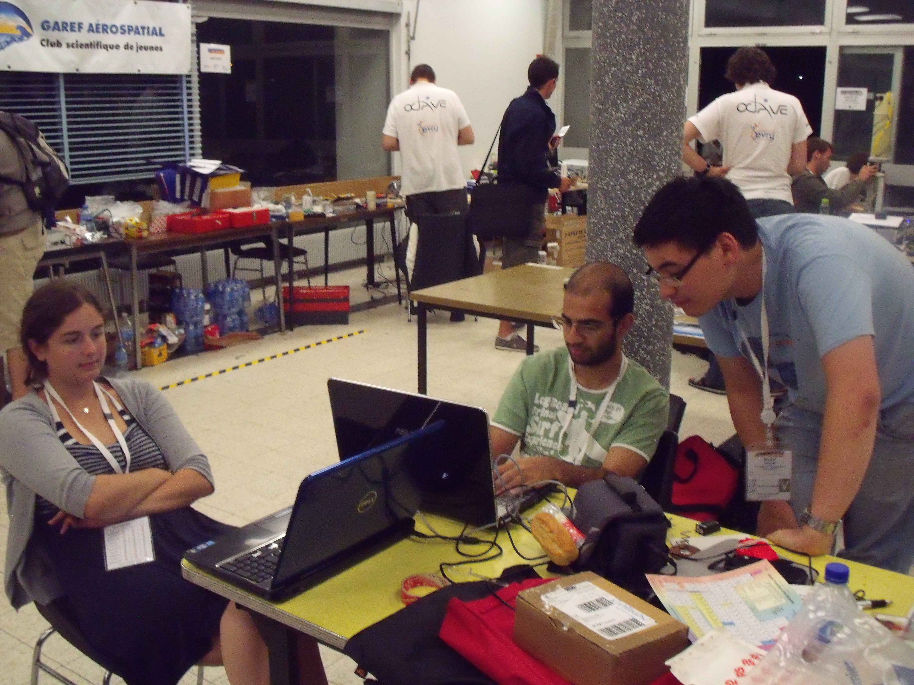
website/images/selec/DSCF3376.JPG
