thriller91/Cansat-SupOp/website/images/selec/SANY0806.JPG

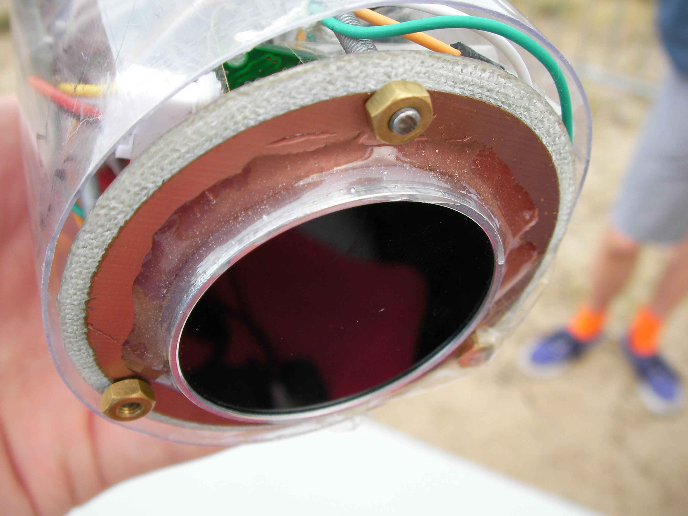
website/images/selec/SANY0806.JPG
