thriller91/Cansat-SupOp/website/images/selec/SANY0810.JPG

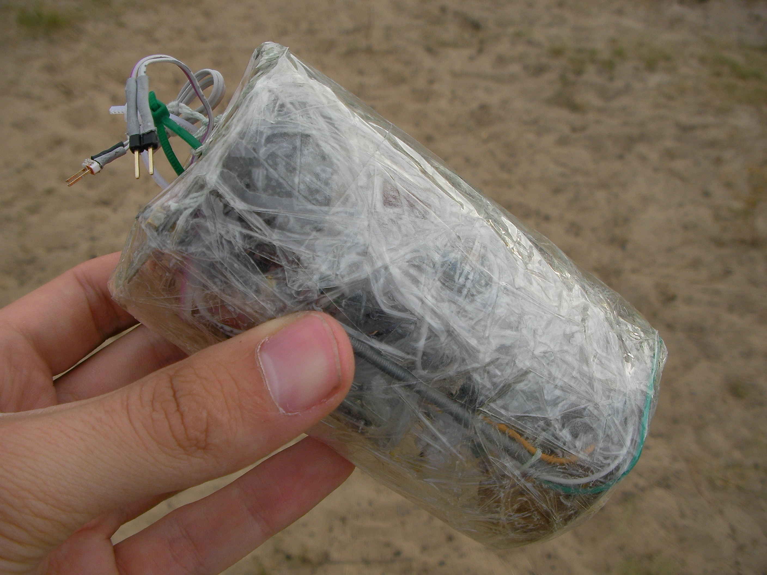
website/images/selec/SANY0810.JPG
