thriller91/Cansat-SupOp/website/images/selec/SANY0812.JPG

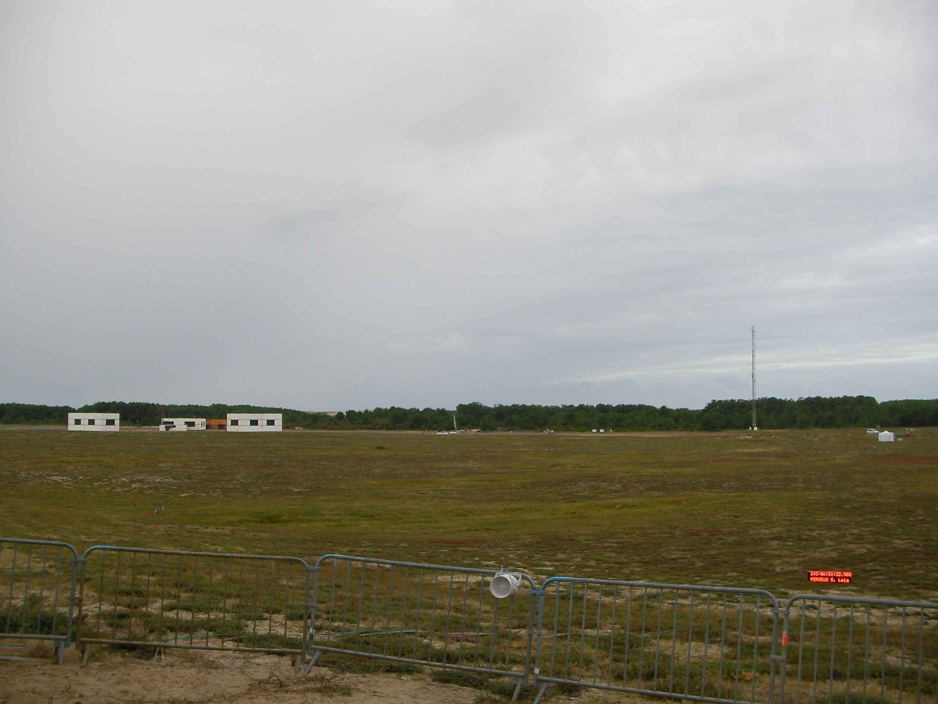
website/images/selec/SANY0812.JPG
