thriller91/Cansat-SupOp/website/images/selec/SANY0814.JPG

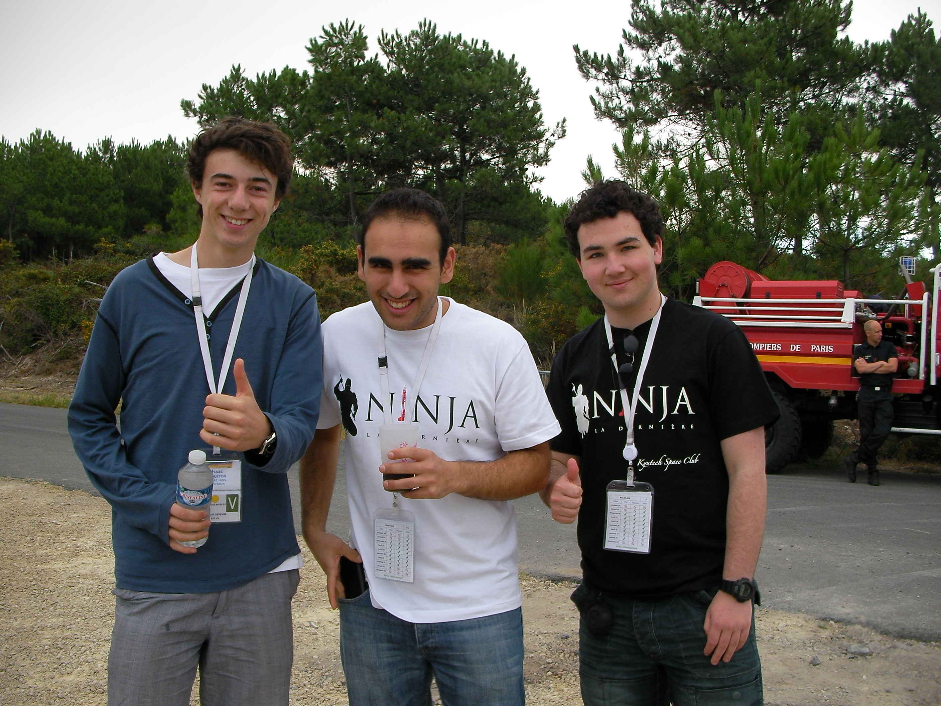
website/images/selec/SANY0814.JPG
