thriller91/Cansat-SupOp/website/images/selec/SANY0836.JPG

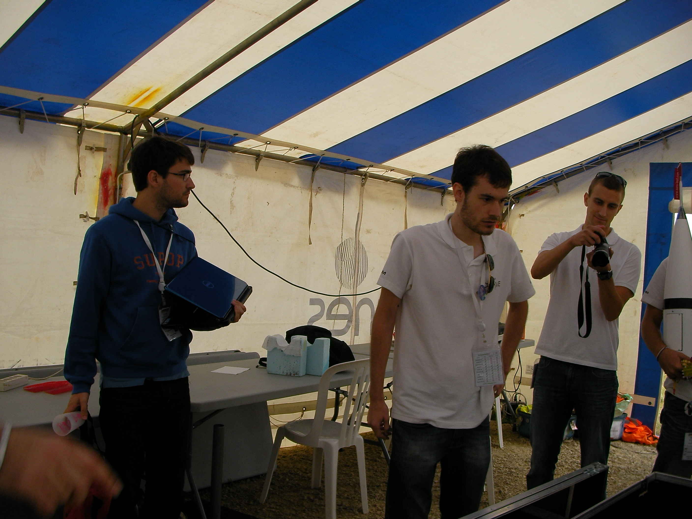
website/images/selec/SANY0836.JPG
