thriller91/Cansat-SupOp/website/images/selec/SANY0837.JPG

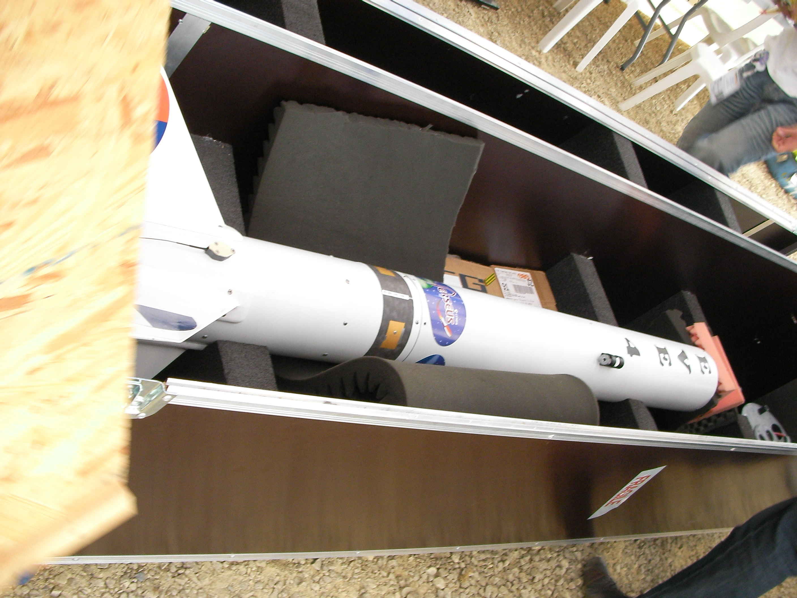
website/images/selec/SANY0837.JPG
