thriller91/Cansat-SupOp/website/images/selec/SANY0842.JPG

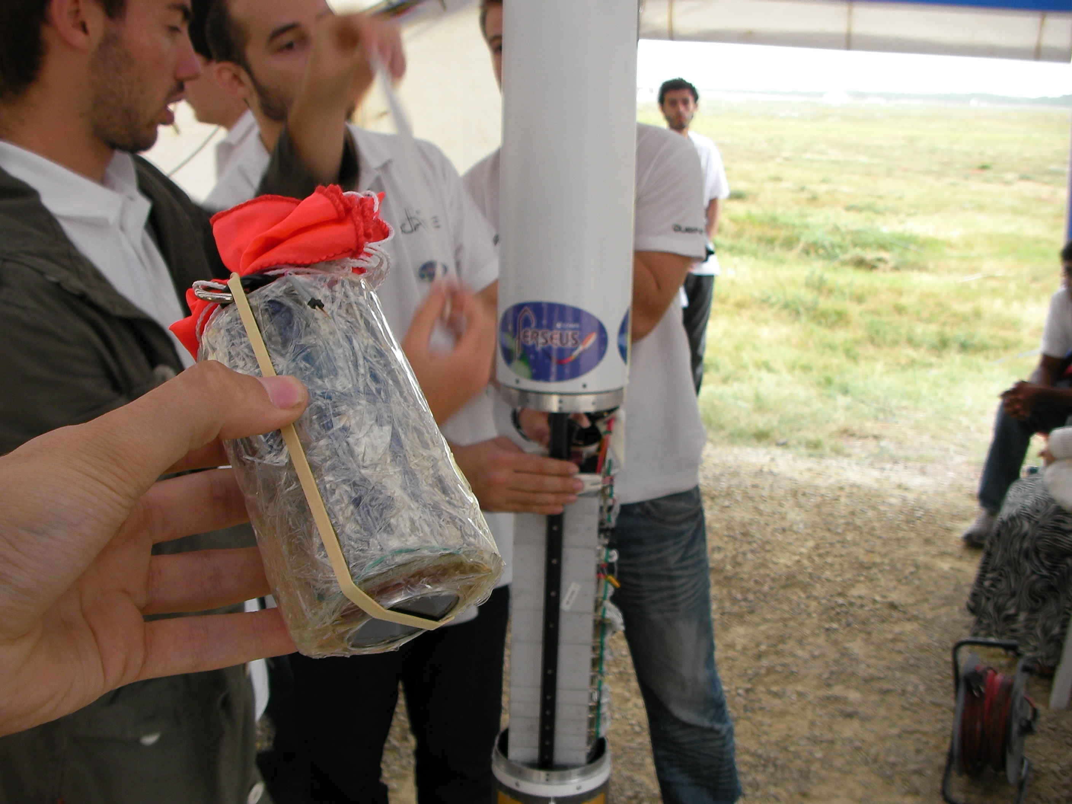
website/images/selec/SANY0842.JPG
