thriller91/Cansat-SupOp/website/images/selec/SANY0843.JPG

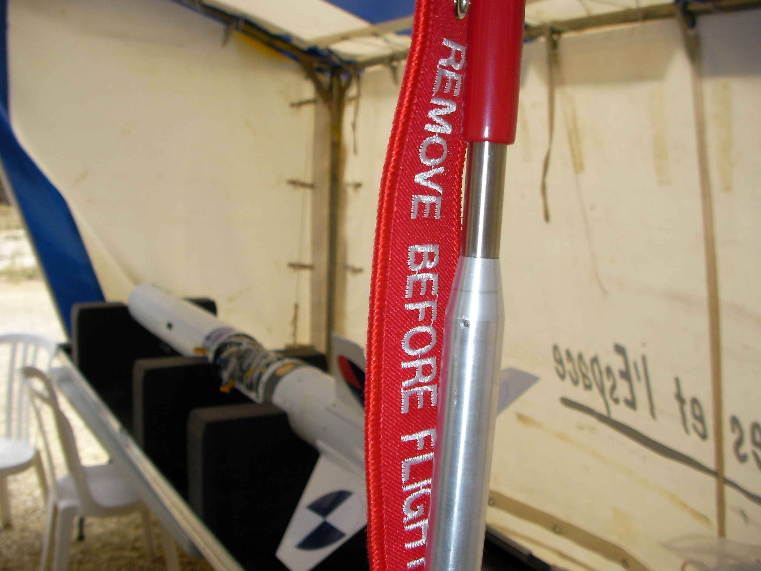
website/images/selec/SANY0843.JPG
