thriller91/Cansat-SupOp/website/images/selec/SANY0849.JPG

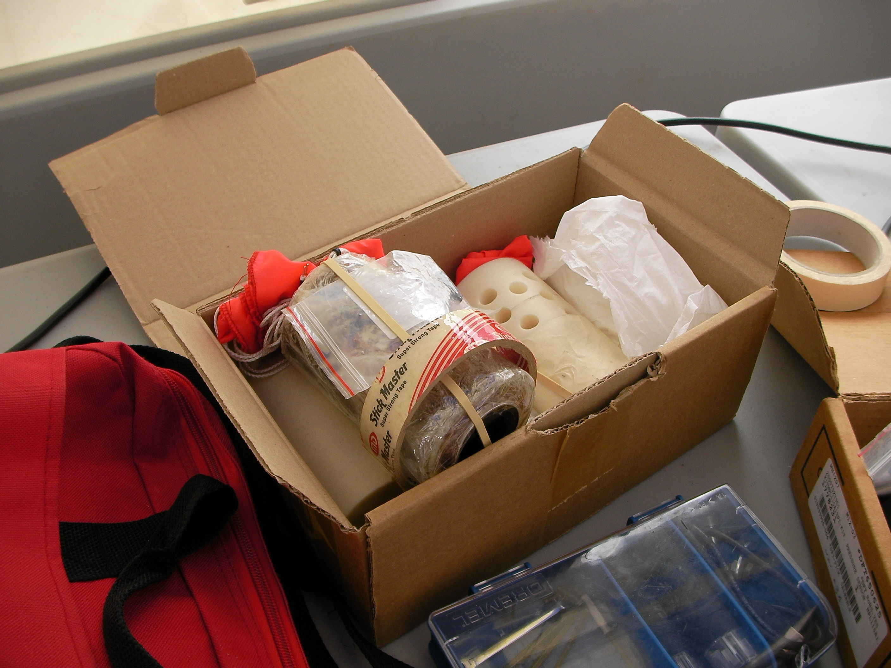
website/images/selec/SANY0849.JPG
