thriller91/Cansat-SupOp/website/images/selec/SANY0855.JPG

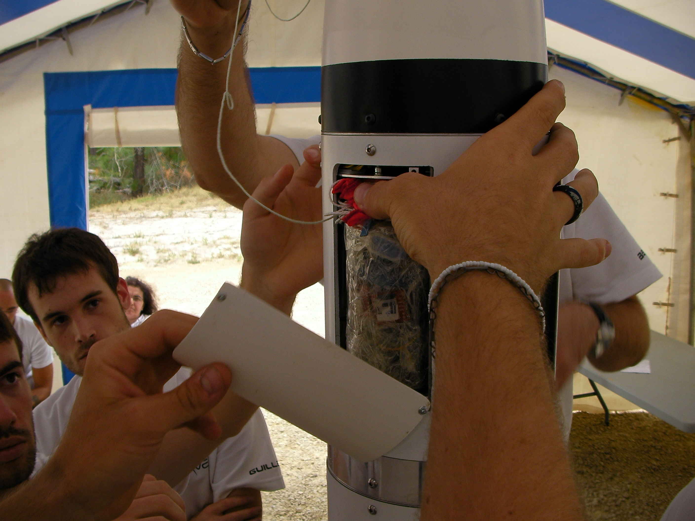
website/images/selec/SANY0855.JPG
