thriller91/Cansat-SupOp/website/images/selec/SANY0858.JPG

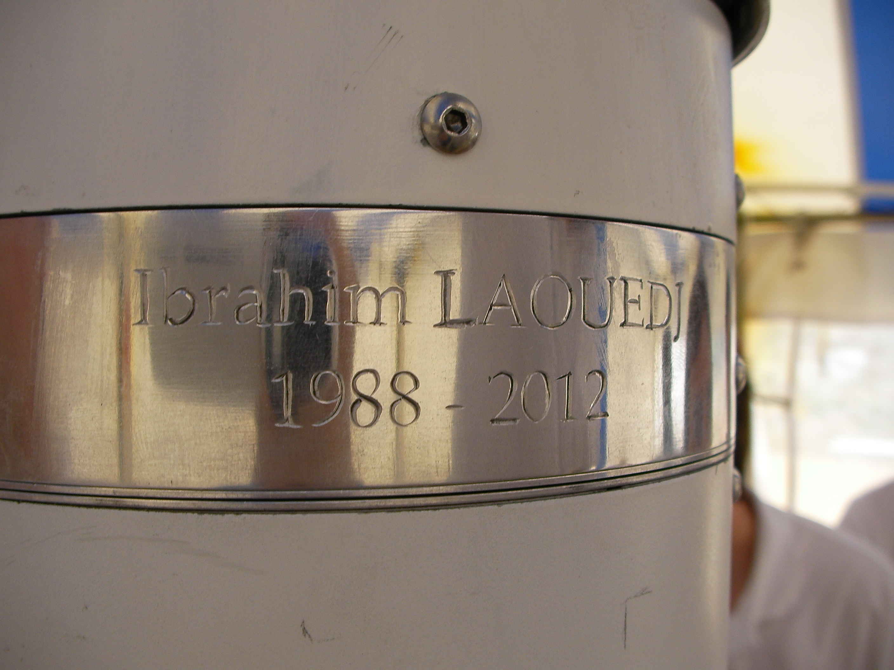
website/images/selec/SANY0858.JPG
