thriller91/Cansat-SupOp/website/images/selec/SANY0865.JPG

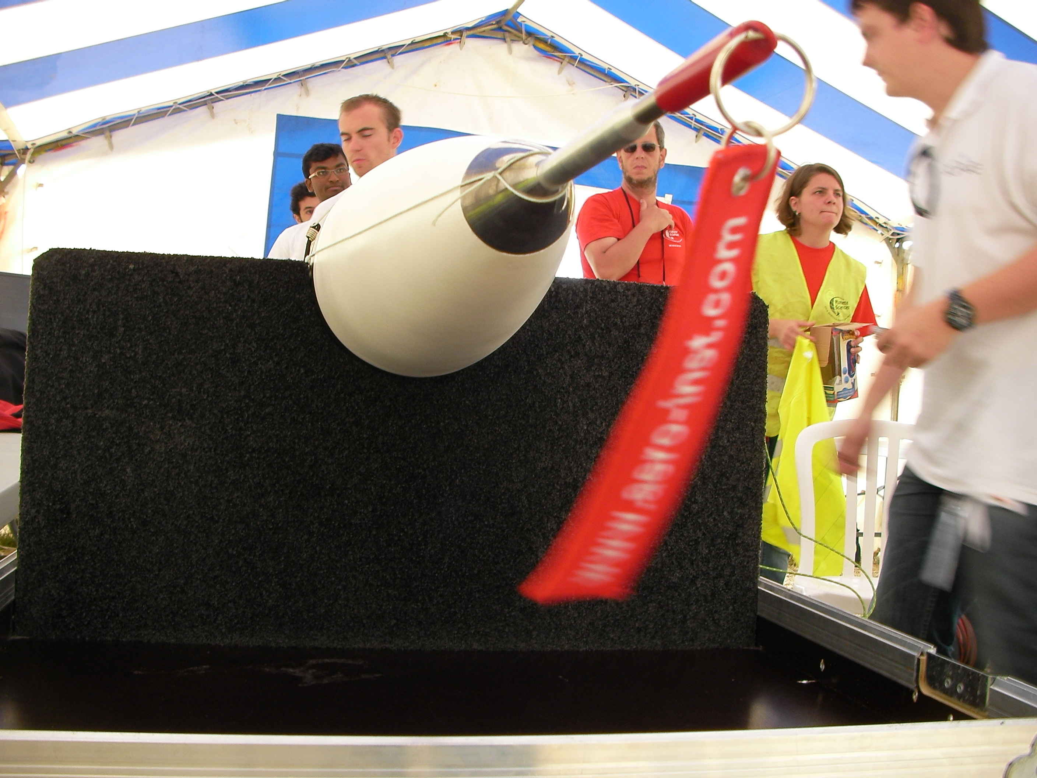
website/images/selec/SANY0865.JPG
