thriller91/Cansat-SupOp/website/images/selec/SANY0874.JPG

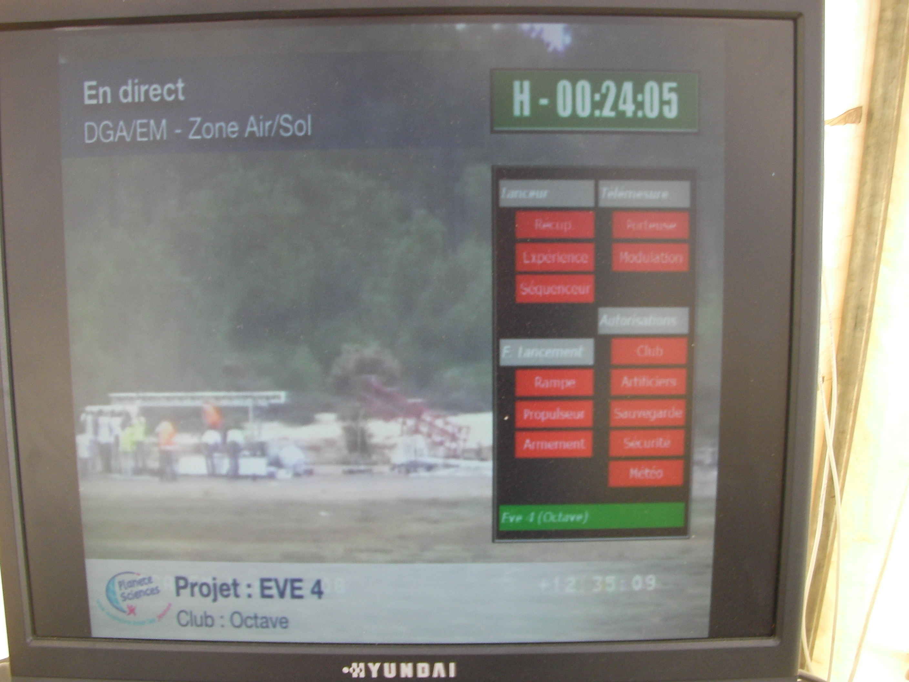
website/images/selec/SANY0874.JPG
