thriller91/Cansat-SupOp/website/images/selec/SANY0877.JPG

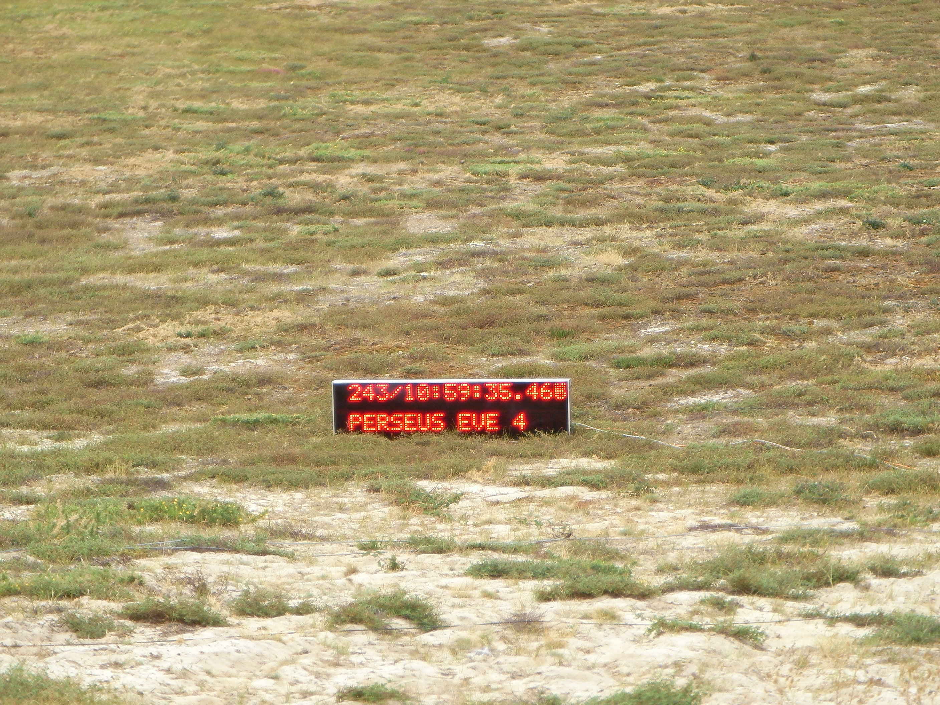
website/images/selec/SANY0877.JPG
