thriller91/Cansat-SupOp/website/images/selec/SANY0880.JPG

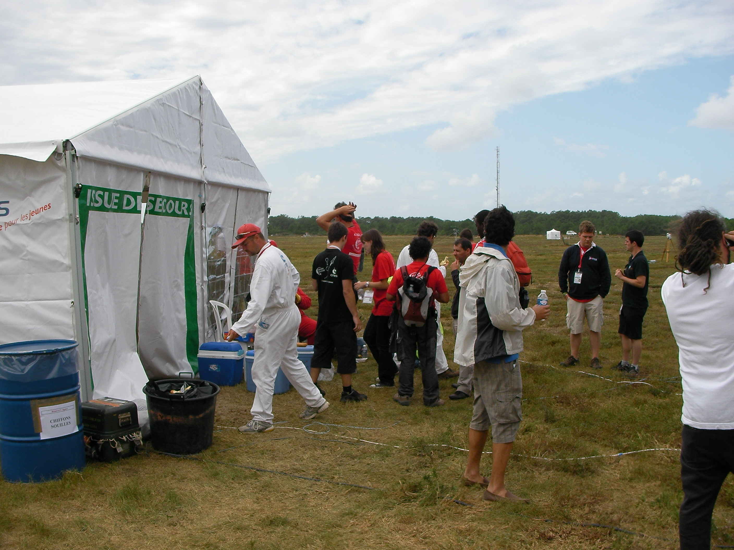
website/images/selec/SANY0880.JPG
