thriller91/Cansat-SupOp/website/images/selec/SANY0884.JPG

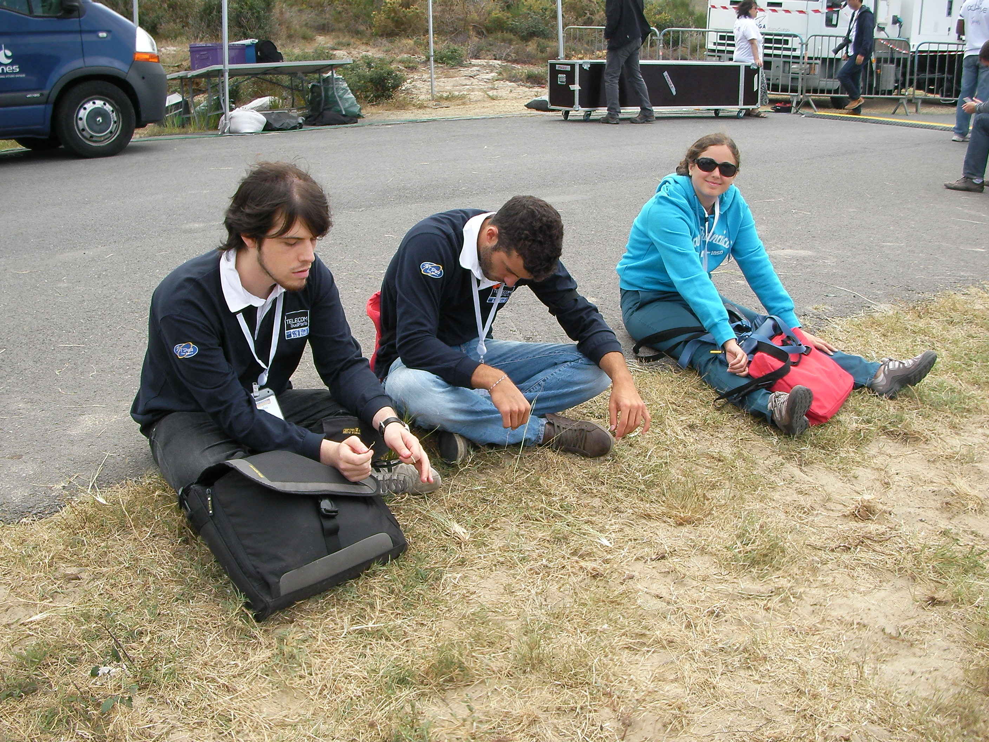
website/images/selec/SANY0884.JPG
