thriller91/Cansat-SupOp/website/images/selec/SANY0888.JPG

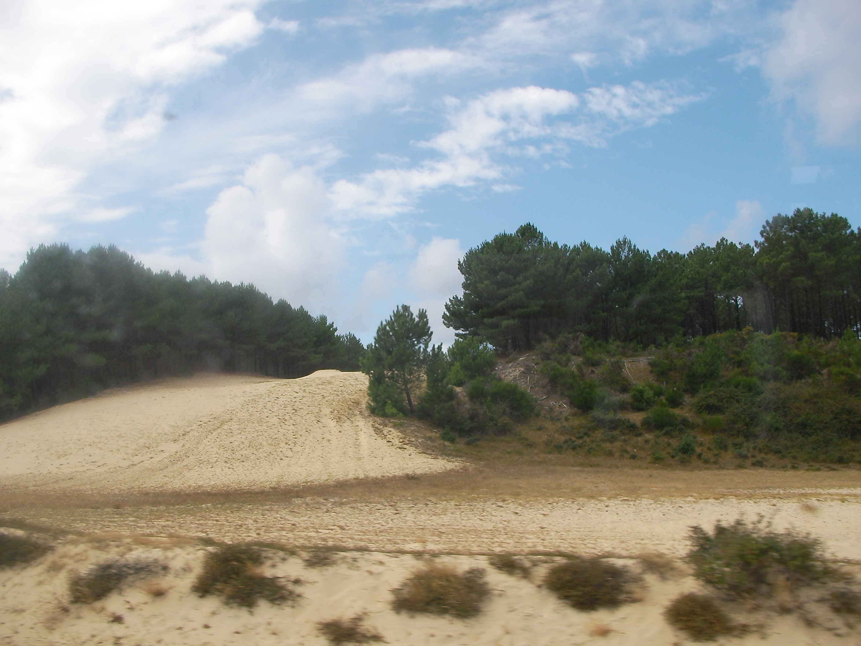
website/images/selec/SANY0888.JPG
