thriller91/Cansat-SupOp/website/images/selec/SANY0898.JPG

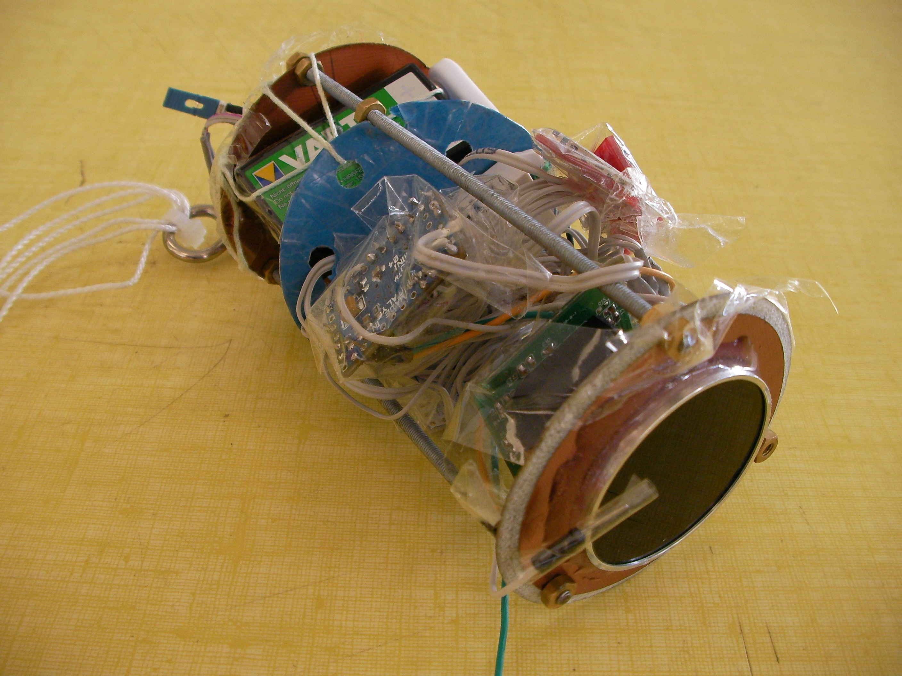
website/images/selec/SANY0898.JPG
