thriller91/Cansat-SupOp/website/images/selec/thumbs/DSCF3127.gif

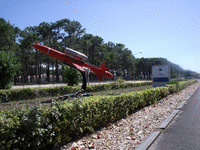
website/images/selec/thumbs/DSCF3127.gif
