thriller91/Cansat-SupOp/website/images/selec/thumbs/DSCF3130.gif

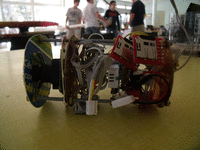
website/images/selec/thumbs/DSCF3130.gif
