thriller91/Cansat-SupOp/website/images/selec/thumbs/DSCF3134.gif

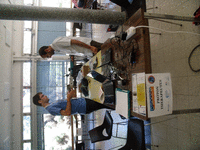
website/images/selec/thumbs/DSCF3134.gif
