thriller91/Cansat-SupOp/website/images/selec/thumbs/DSCF3138.gif

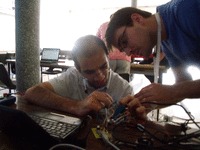
website/images/selec/thumbs/DSCF3138.gif
