thriller91/Cansat-SupOp/website/images/selec/thumbs/DSCF3139.gif

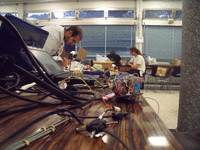
website/images/selec/thumbs/DSCF3139.gif
