thriller91/Cansat-SupOp/website/images/selec/thumbs/DSCF3146.gif

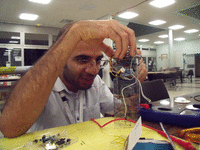
website/images/selec/thumbs/DSCF3146.gif
