thriller91/Cansat-SupOp/website/images/selec/thumbs/DSCF3148.gif

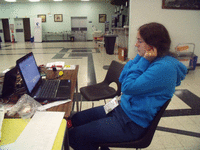
website/images/selec/thumbs/DSCF3148.gif
