thriller91/Cansat-SupOp/website/images/selec/thumbs/DSCF3209.gif

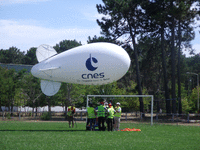
website/images/selec/thumbs/DSCF3209.gif
