thriller91/Cansat-SupOp/website/images/selec/thumbs/DSCF3322.gif

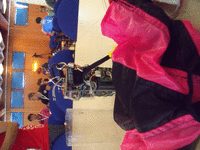
website/images/selec/thumbs/DSCF3322.gif
