thriller91/Cansat-SupOp/website/images/selec/thumbs/SANY0812.gif

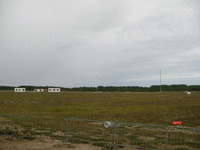
website/images/selec/thumbs/SANY0812.gif
