thriller91/Cansat-SupOp/website/images/sun.jpg

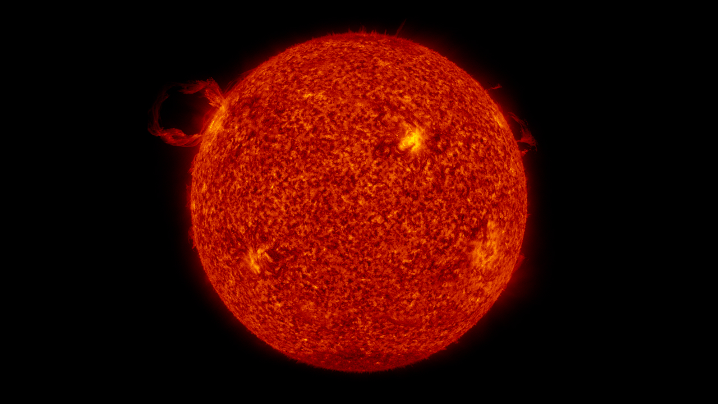
website/images/sun.jpg
