thriller91/Cansat-SupOp/website/photo_equipe.jpg

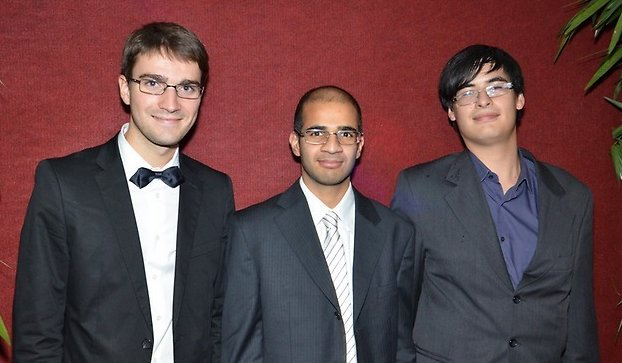
website/photo_equipe.jpg
