thriller91/Cansat-SupOp/website/images/plots/elec_cost.png

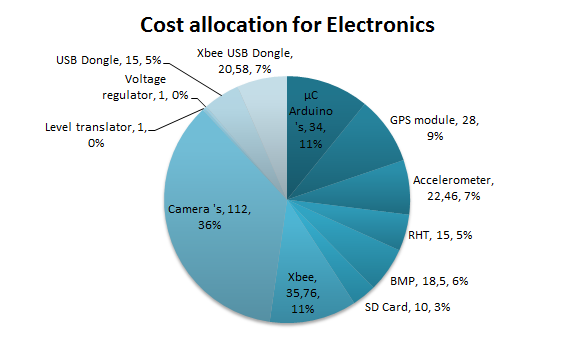
website/images/plots/elec_cost.png
