thriller91/Cansat-SupOp/website/images/plots/total_cost.png

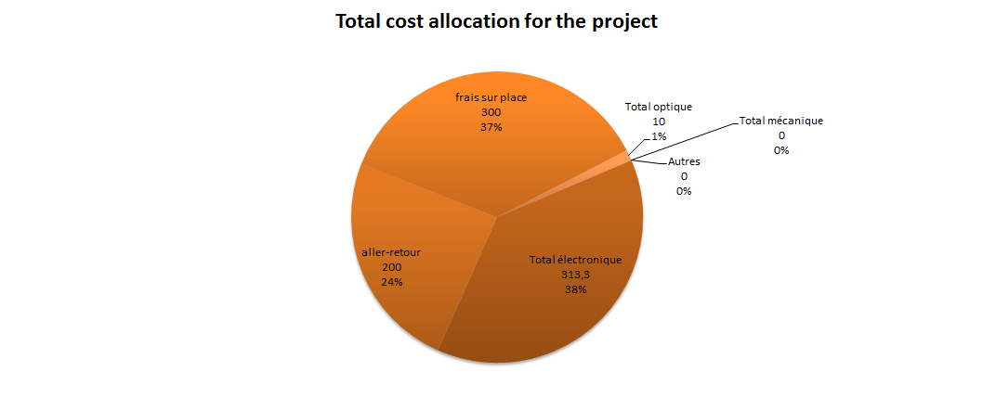
website/images/plots/total_cost.png
