thriller91/Cansat-SupOp/website/presentation_test.pdf

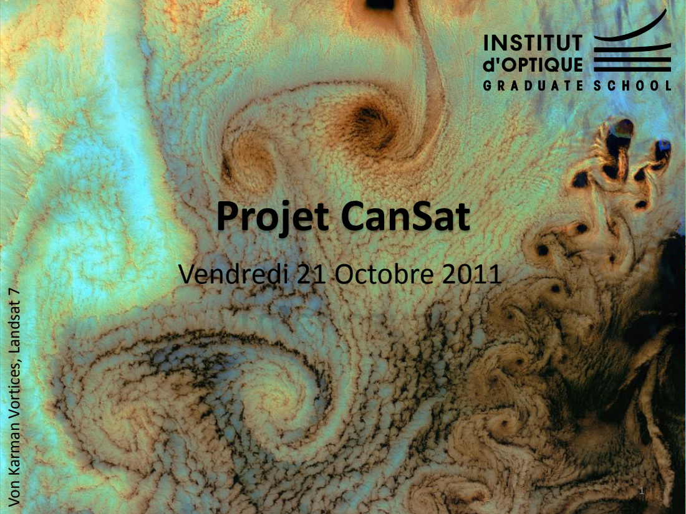
[picture p188: page 1]
Projet CanSat; Vendredi 21 Octobre 2011

Von Karman Vortices, Landsat 7

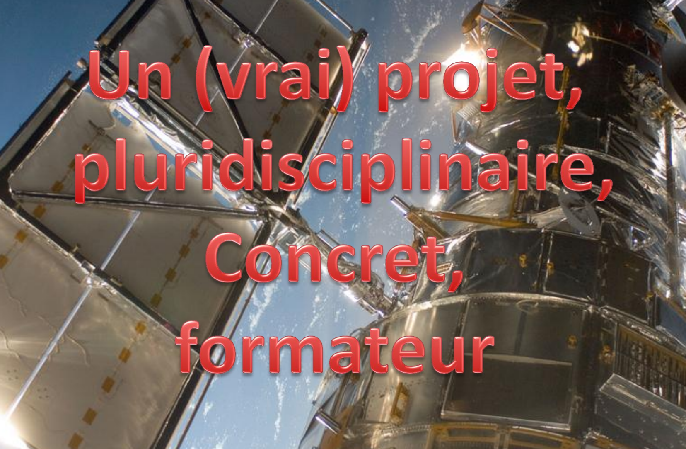
[picture p189: figure]

hubble space telescope

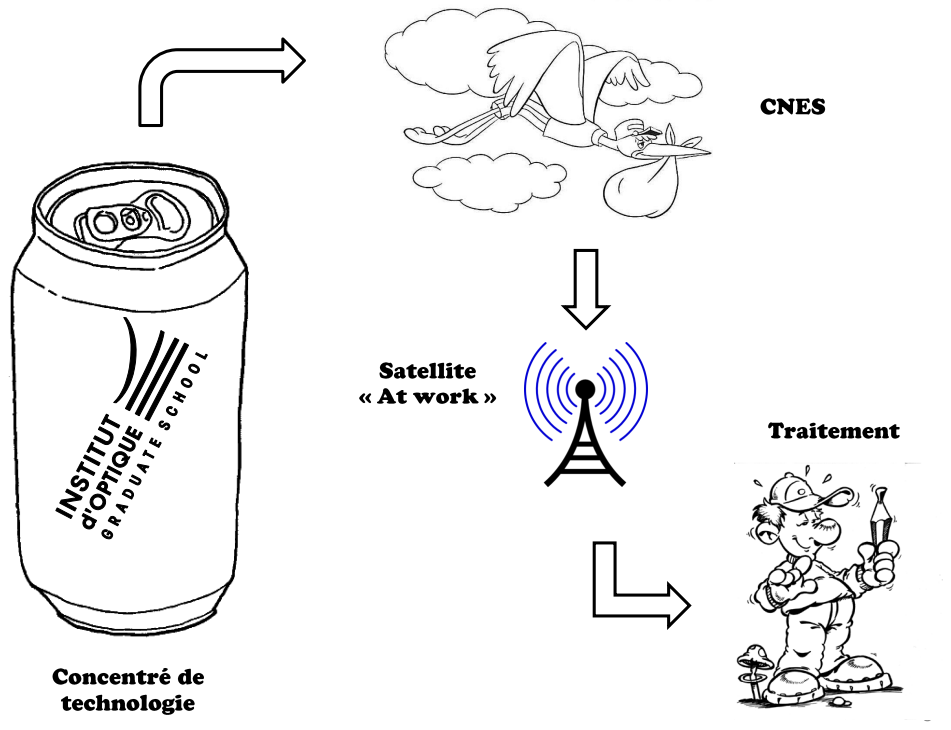
[picture p190: page 3]

## International class

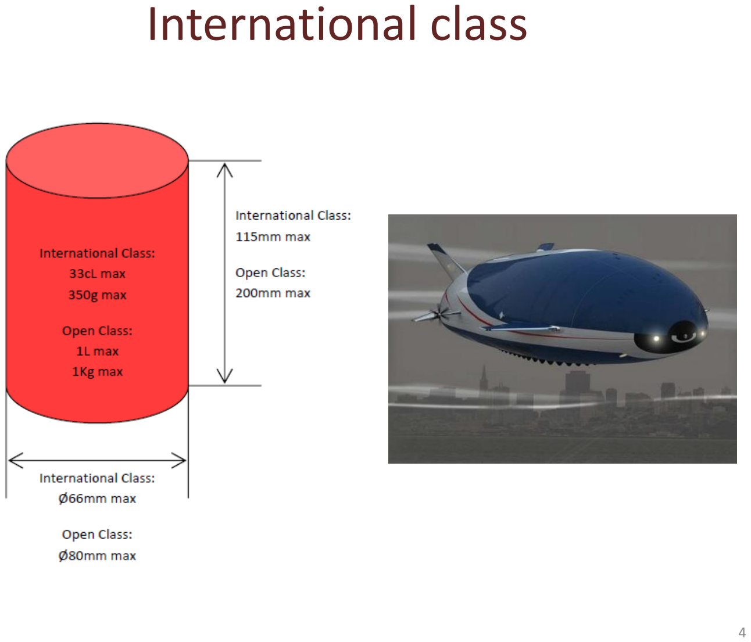
[picture p191: page 4]

## Nos Missions

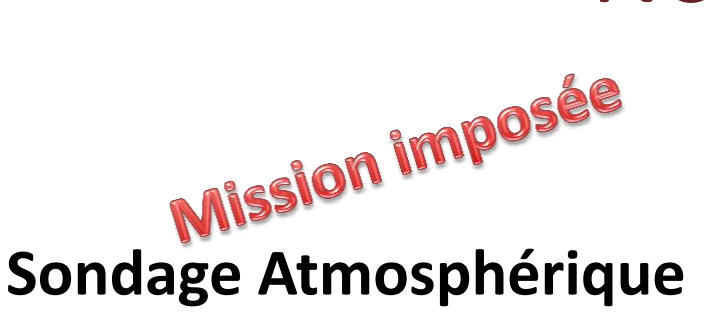
[picture p192: figure]
Sondage Atmosphérique

- Mesure d’hygrométrie au
moins toutes les 5 secondes
- Mesure d’altitude au moins toutes les 5 secondes
(barométrie)
- Bonus : mesure de la
température.
- Transmet les valeurs à une station au sol

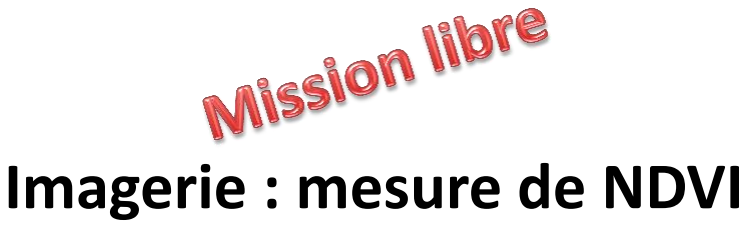
[picture p193: figure]
Imagerie : mesure de NDVI

- Acquisition simultanée de la même image dans 2
gammes spectrales
différentes
- Stockage des données
- Transmet les valeurs à une station au sol

# Mission 1 : Sondage atmosphérique

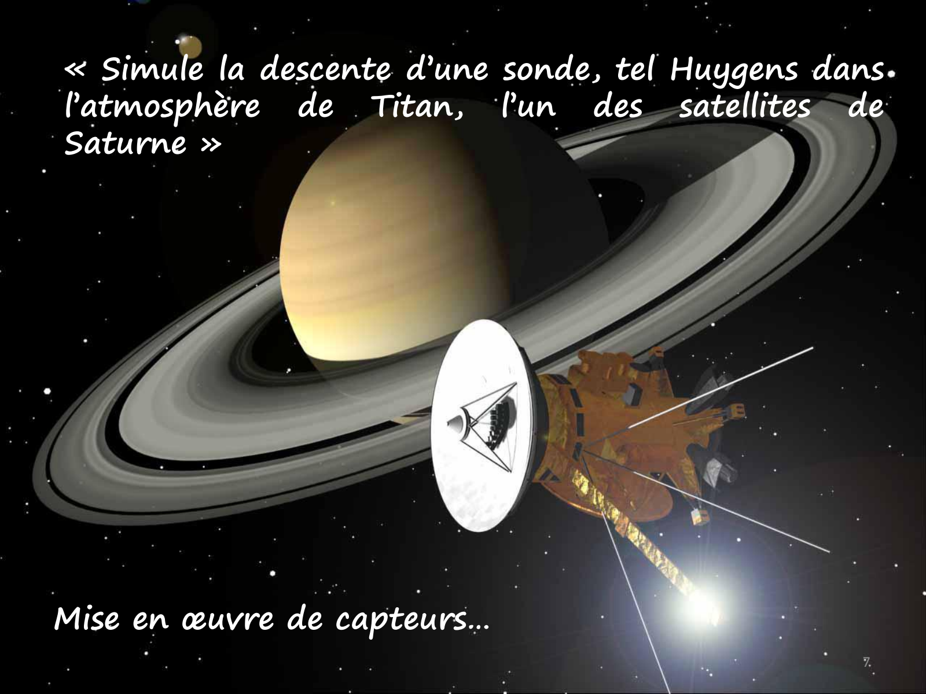
[picture p194: page 7]

« Simule la descente d’une sonde, tel Huygens dans l’atmosphère de Titan, l’un des satellites de Saturne »

Mise en œuvre de capteurs…

# Mission 2 : Imagerie NDVI

## NDVI ?

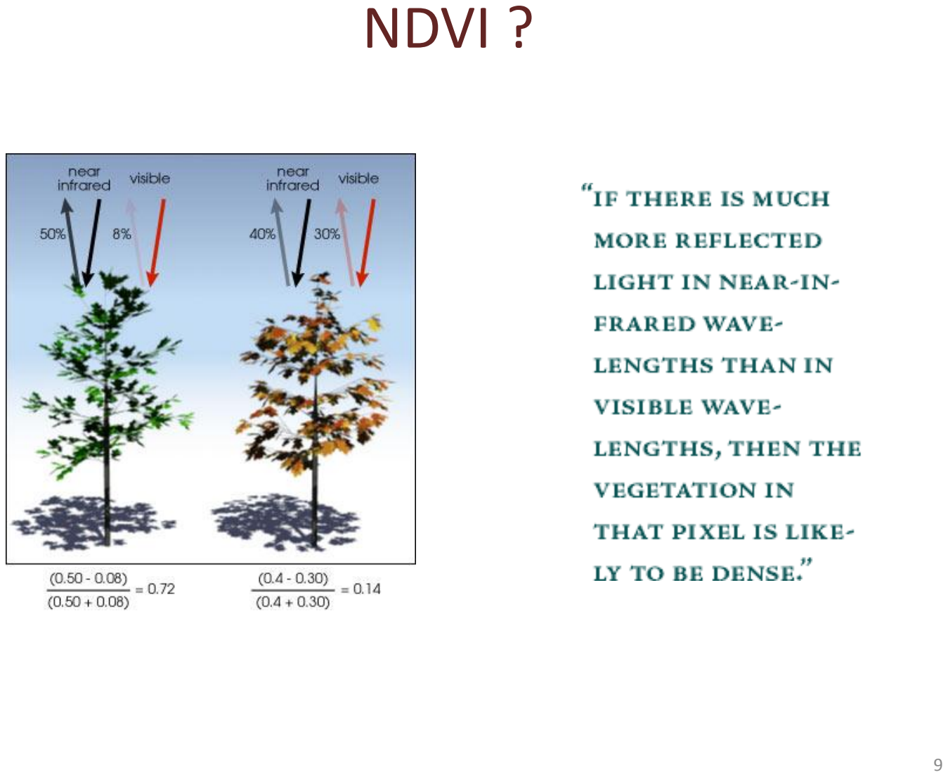
[picture p195: page 9]

# Notre expérience embarquée

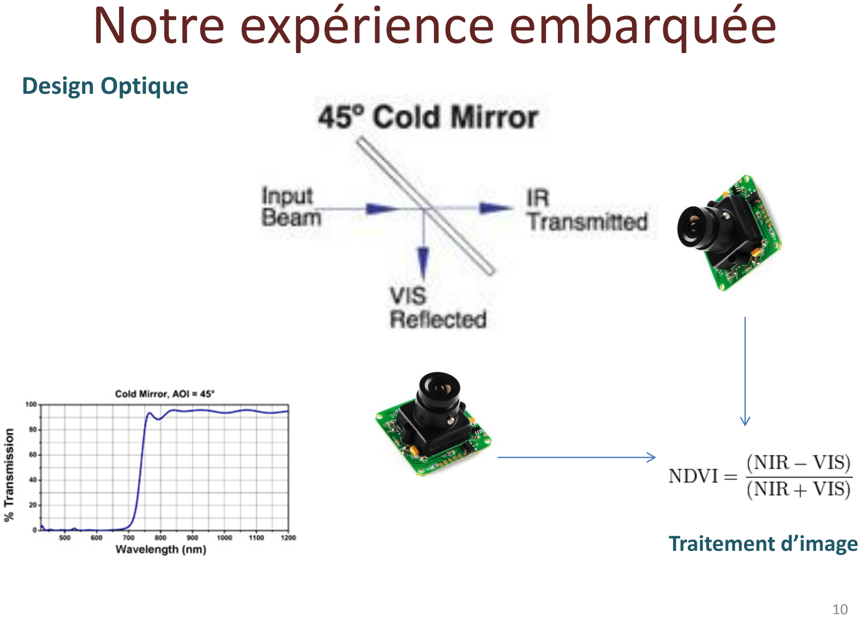
[picture p196: page 10]

Traitement d’image

Design Optique

## Test en laboratoire Compensation numérique Intégration du système

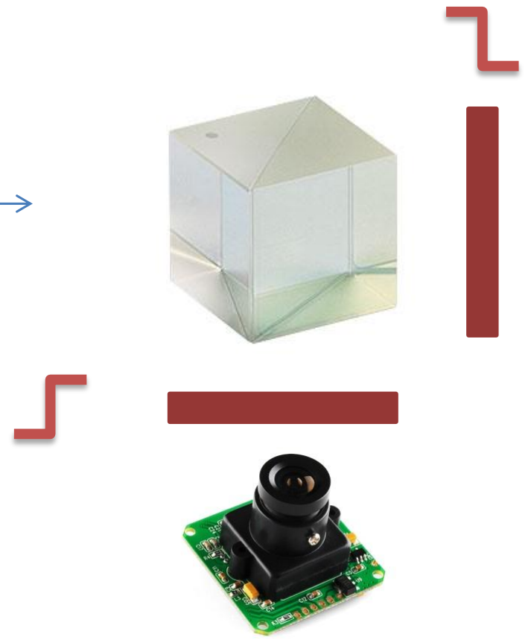
[picture p197: figure]
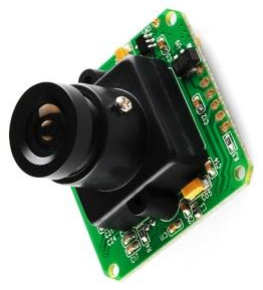
[picture p198: figure]

Solution bis :

# Traitement d’image

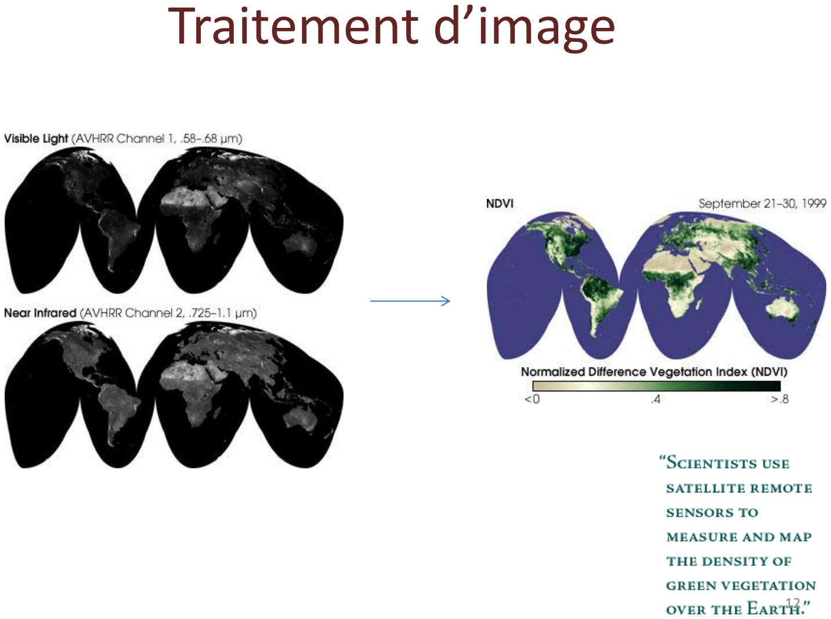
[picture p199: page 12]

# Design Electronique

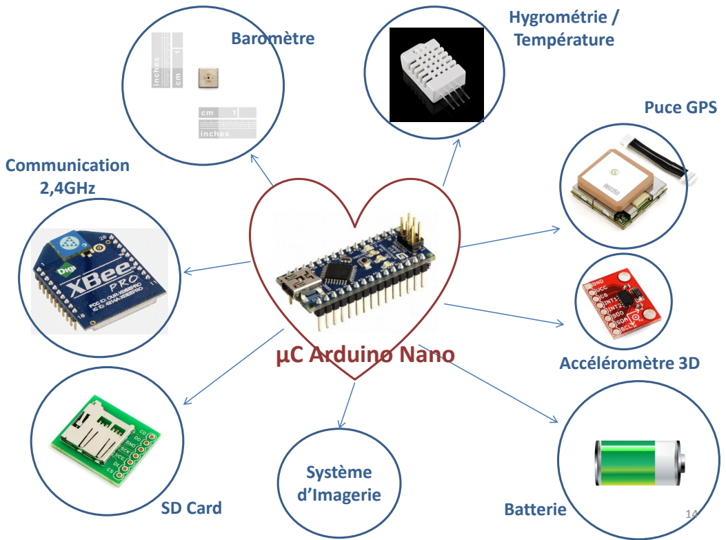
[picture p200: page 14]
Système d’Imagerie; Baromètre; Hygrométrie / Température; Puce GPS; Accéléromètre 3D; Batterie; Communication 2,4GHz; SD Card

µC Arduino Nano

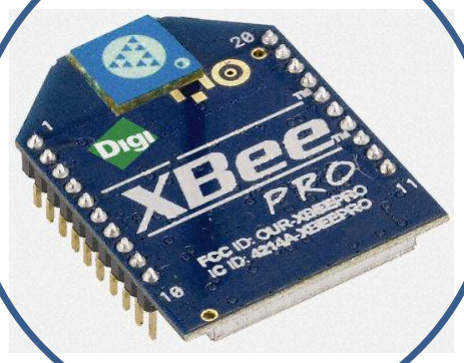
[picture p201: figure]

Communication
2,4GHz

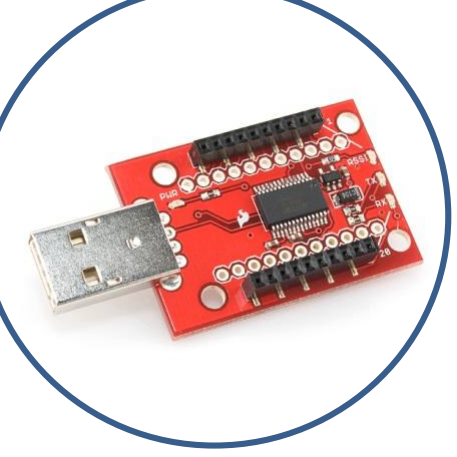
[picture p202: figure]

Xbee USB
Dongle

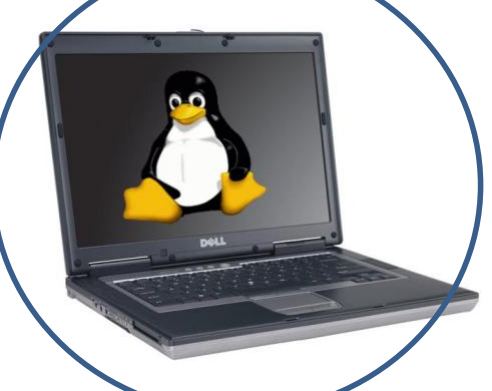
[picture p203: figure]

PC

# Station au sol

15 Contact micro-soudure : Coutrot Anne-Lise

# Design Mécanique

### - Bilan en masse :

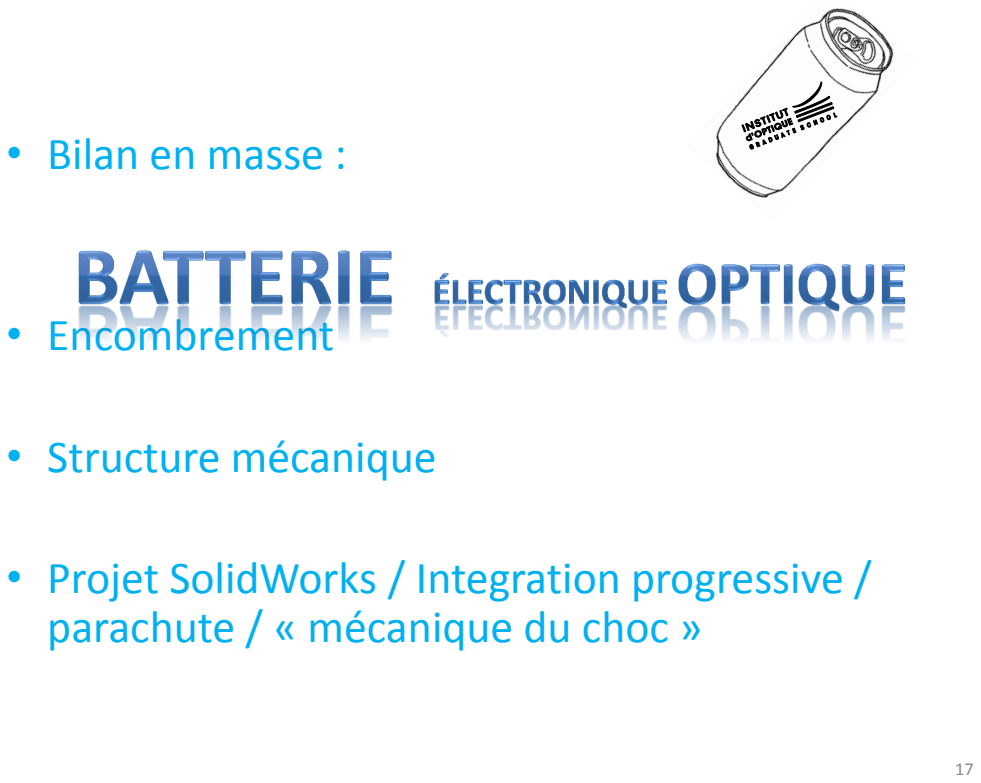
[picture p204: page 17]
• Encombrement; • Structure mécanique

• Projet SolidWorks / Integration progressive /
parachute / « mécanique du choc »

# Gestion de Projet

CanSat | Prix ( € )
GPS | 45
Accéléromètre | 28
Hygrométrie / température | 7
Pression | 7
Xbee Pro | 35
Carte SD | 8
Micro -controlleur | 42
TOTAL | 172
Station au sol | Prix ( € )
Xbee Explorer dongle USB | 19
Xbee ( récepteur ) | 30
TOTAL | 49
Optiques embarquées | Prix ( € )
2 Caméras | ~100
Miroir froid | 14
TOTAL | 114
TOTAL | 335

# Budget

Piste de Financement : CROUS, FFSE, Anciens…

# Notre programme

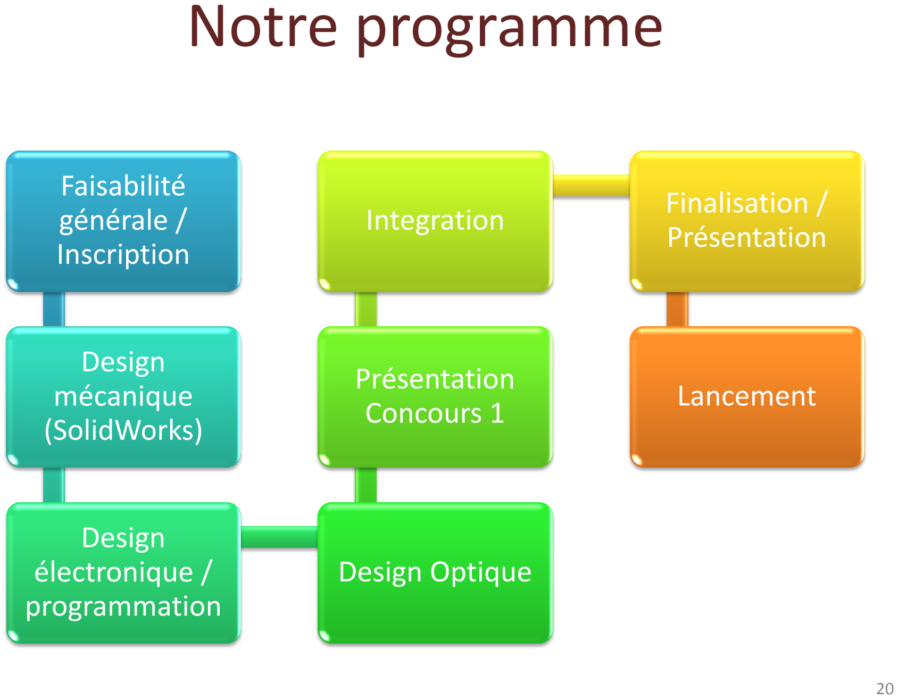
[picture p205: page 20]

Faisabilité
générale /
Inscription

Design
mécanique
(SolidWorks)

Design
électronique /
programmation

Design Optique

Présentation
Concours 1
Integration | Finalisation / Présentation

Lancement

# Notre Site

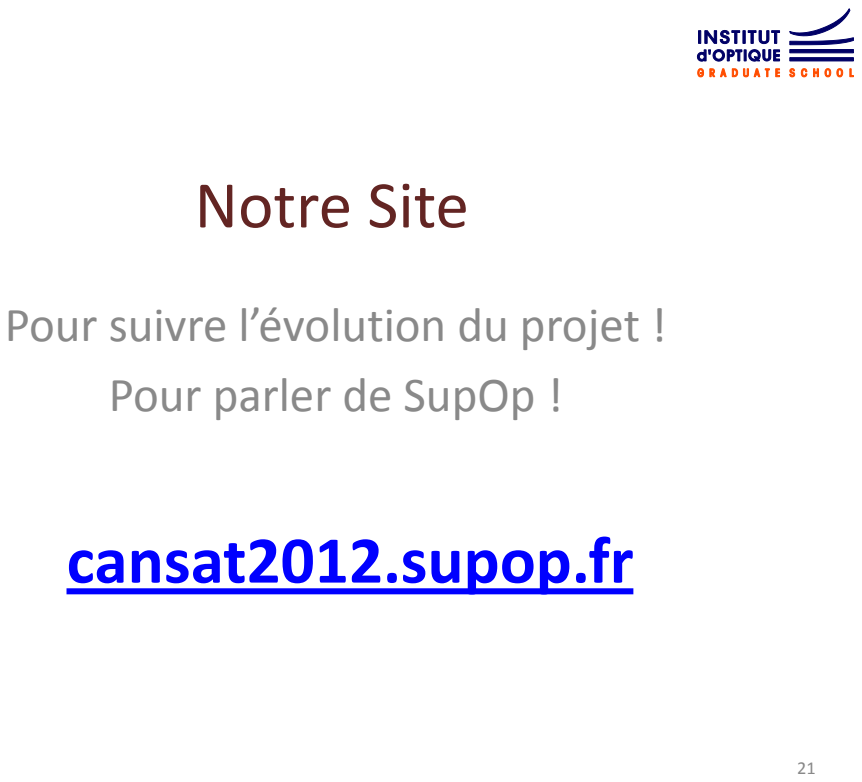
[picture p206: page 21]
cansat2012.supop.fr

Pour suivre l’évolution du projet !
Pour parler de SupOp !
