thriller91/Cansat-SupOp/sources/prgm sol/traitement images/efg/test10044.png

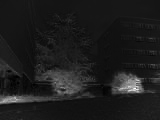
sources/prgm sol/traitement images/efg/test10044.png
