thriller91/Cansat-SupOp/sources/prgm sol/traitement images/research/Result of Num.tif

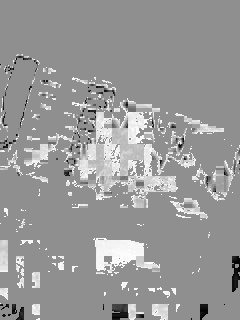
sources/prgm sol/traitement images/research/Result of Num.tif
