thriller91/Cansat-SupOp/sources/prgm sol/traitement images/test10039.jpg

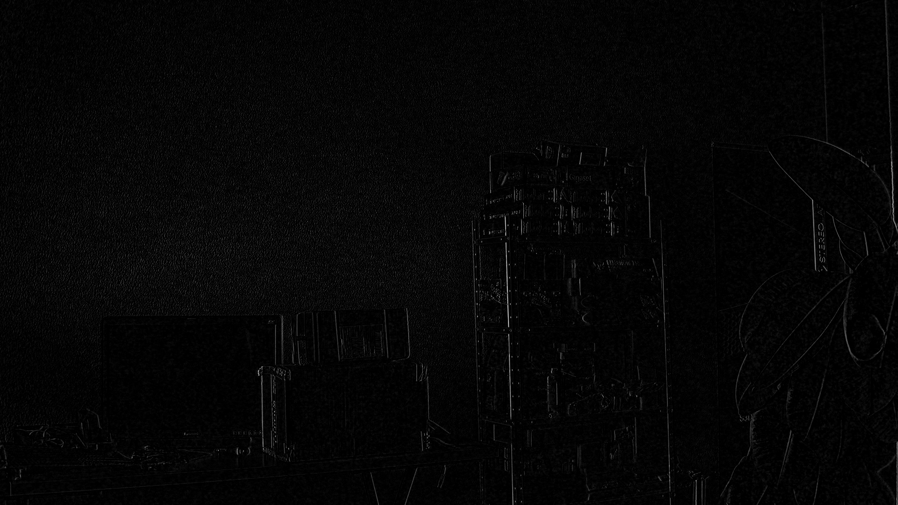
sources/prgm sol/traitement images/test10039.jpg
