thriller91/Cansat-SupOp/sources/prgm sol/traitement images/test10040.jpg

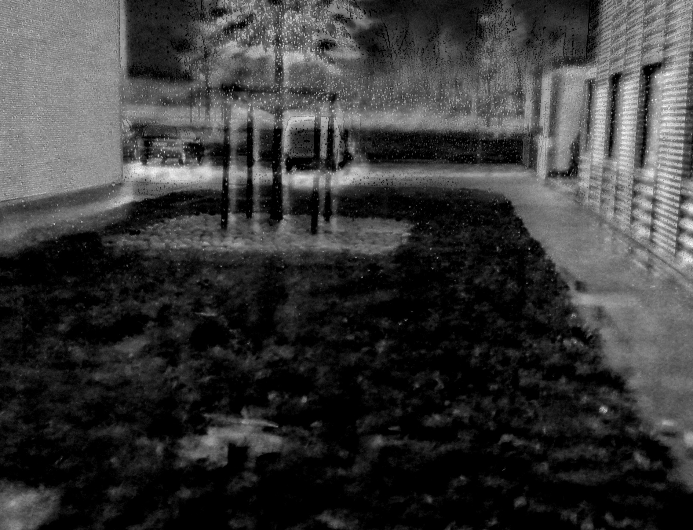
sources/prgm sol/traitement images/test10040.jpg
