thriller91/Cansat-SupOp/sources/prgm sol/traitement images/test10042.jpg

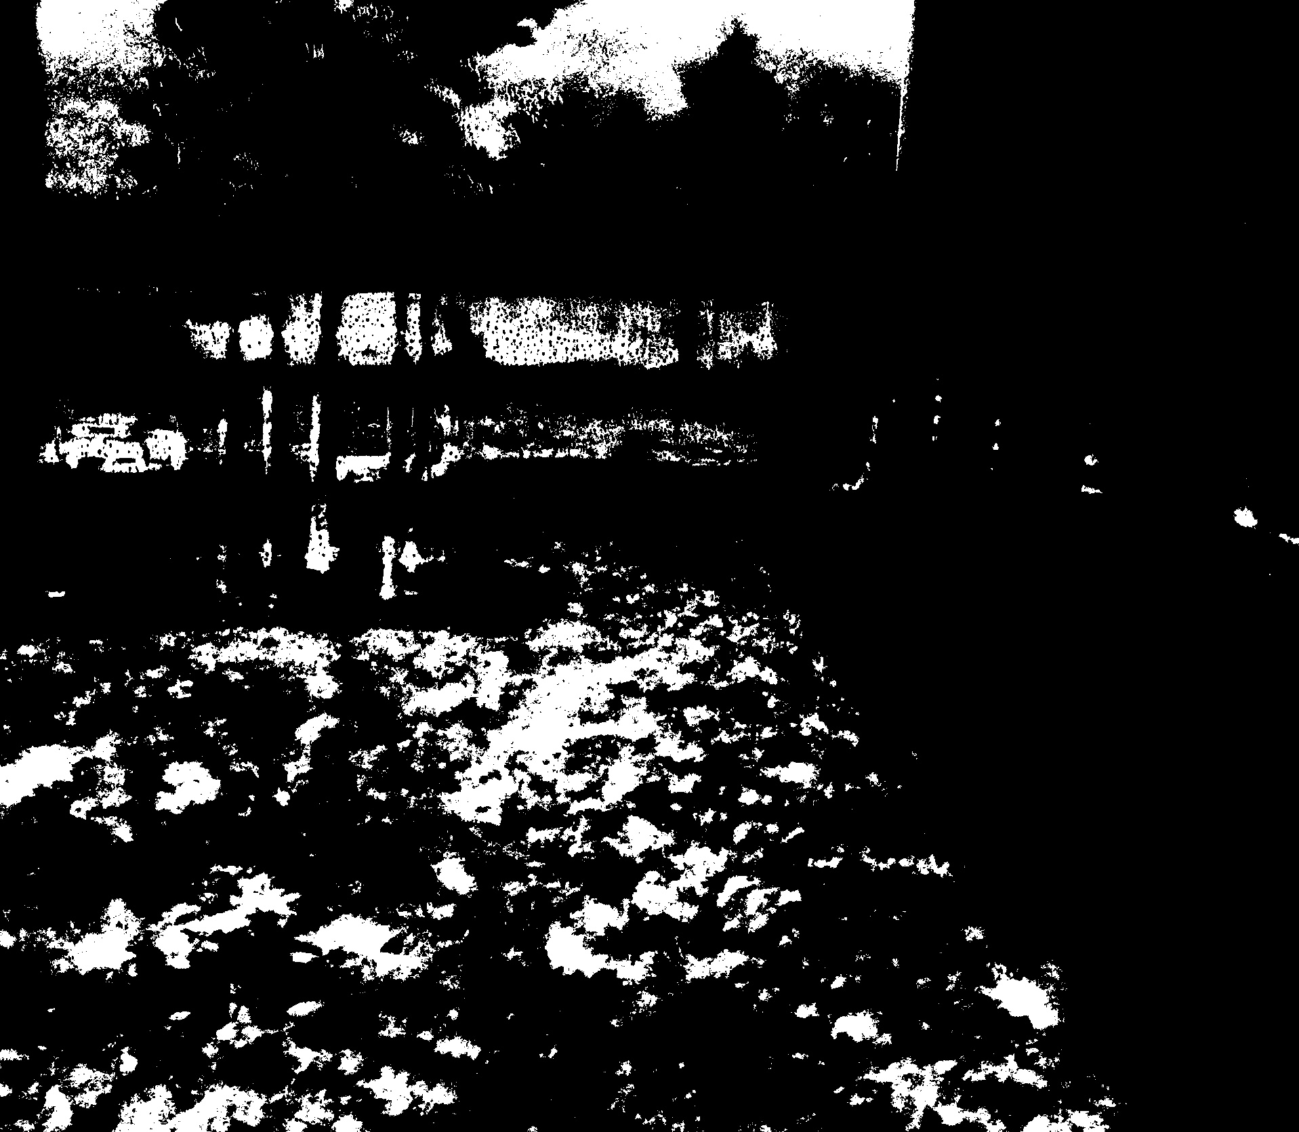
sources/prgm sol/traitement images/test10042.jpg
