thriller91/Cansat-SupOp/sources/prgm sol/traitement images/test10043.jpg

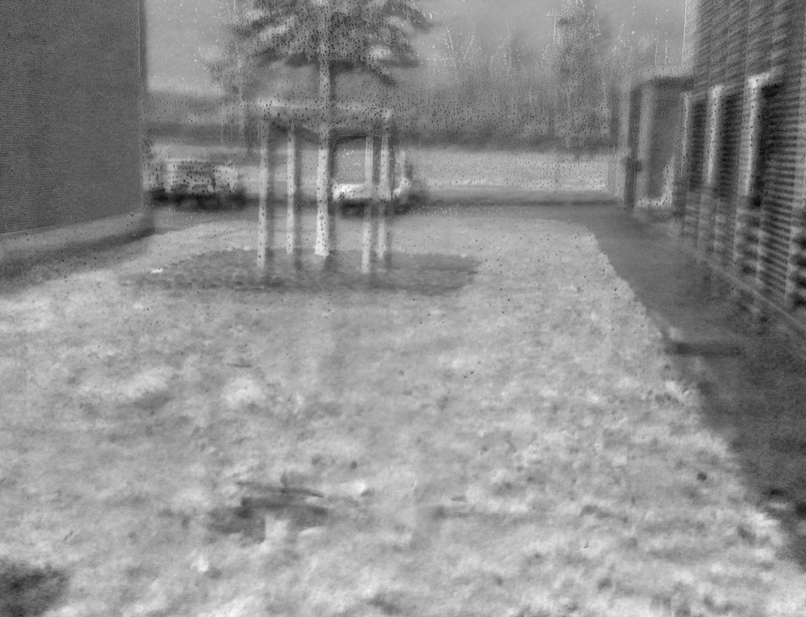
sources/prgm sol/traitement images/test10043.jpg
