thriller91/Cansat-SupOp/website/images/resultats/IMG01.JPG

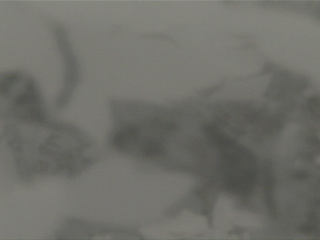
website/images/resultats/IMG01.JPG
