thriller91/Cansat-SupOp/website/images/resultats/temoin/IMG01.JPG

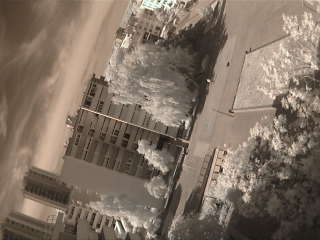
website/images/resultats/temoin/IMG01.JPG
