thriller91/Cansat-SupOp/website/images/resultats/temoin/IMG02.JPG

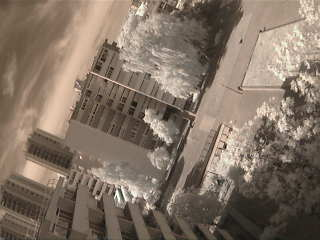
website/images/resultats/temoin/IMG02.JPG
