thriller91/Cansat-SupOp/website/images/resultats/temoin/IMG03.JPG

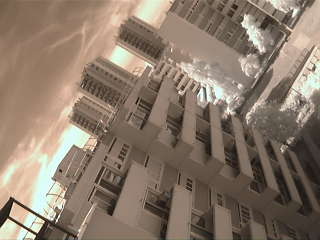
website/images/resultats/temoin/IMG03.JPG
