thriller91/Cansat-SupOp/website/images/resultats/temoin/IMG04.JPG

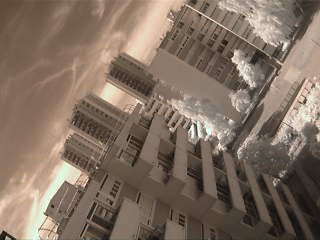
website/images/resultats/temoin/IMG04.JPG
