thriller91/Cansat-SupOp/website/images/resultats/temoin/IMG05.JPG

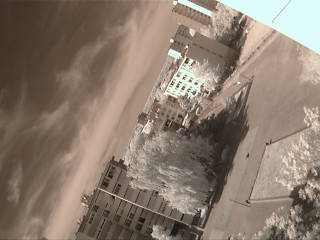
website/images/resultats/temoin/IMG05.JPG
