thriller91/Cansat-SupOp/elec/tetrapharmakos.pdf

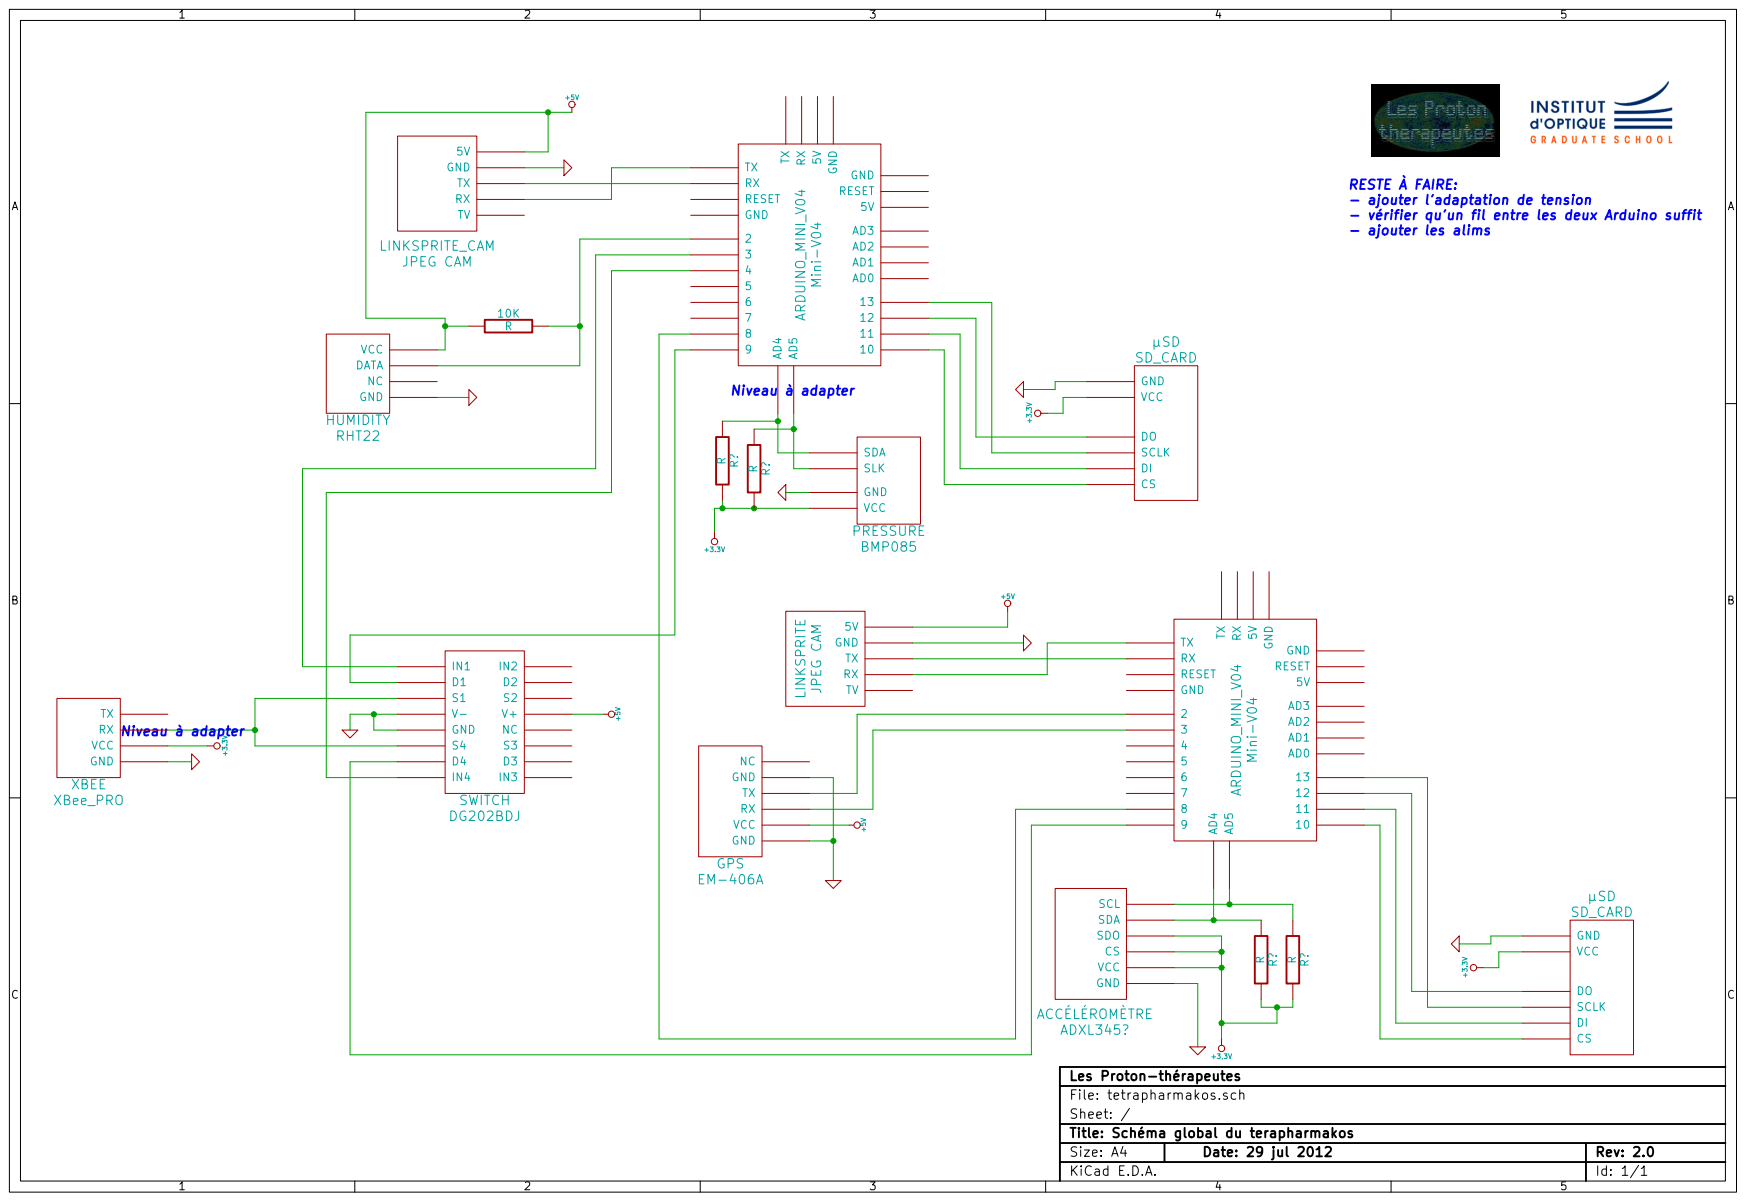
[picture p219: page 1]
