thriller91/Cansat-SupOp/sources/prgm sol/communication/pycrop/cooked/Temp.pdf

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

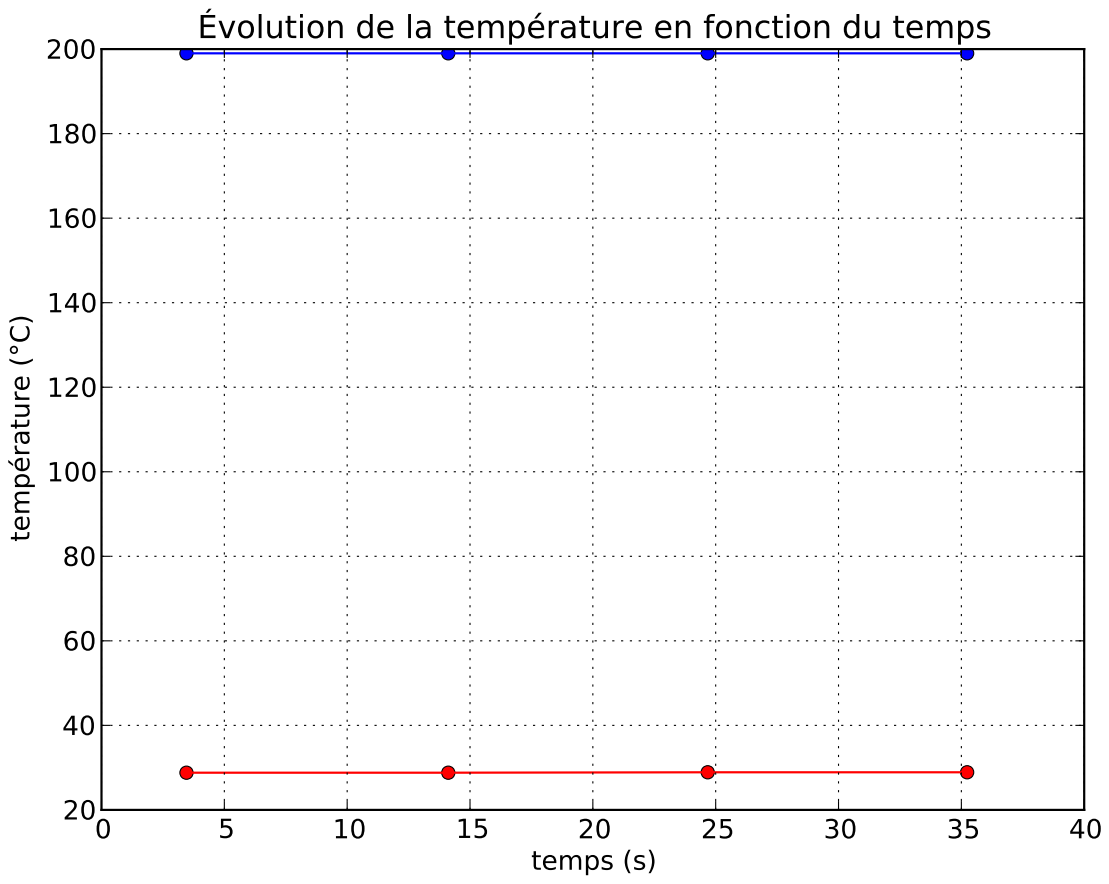
[picture p220: page 1]
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
