thriller91/Cansat-SupOp/elec/tetrapharmakos.sch

## KiCad design elec/tetrapharmakos.sch (2012-09-30)

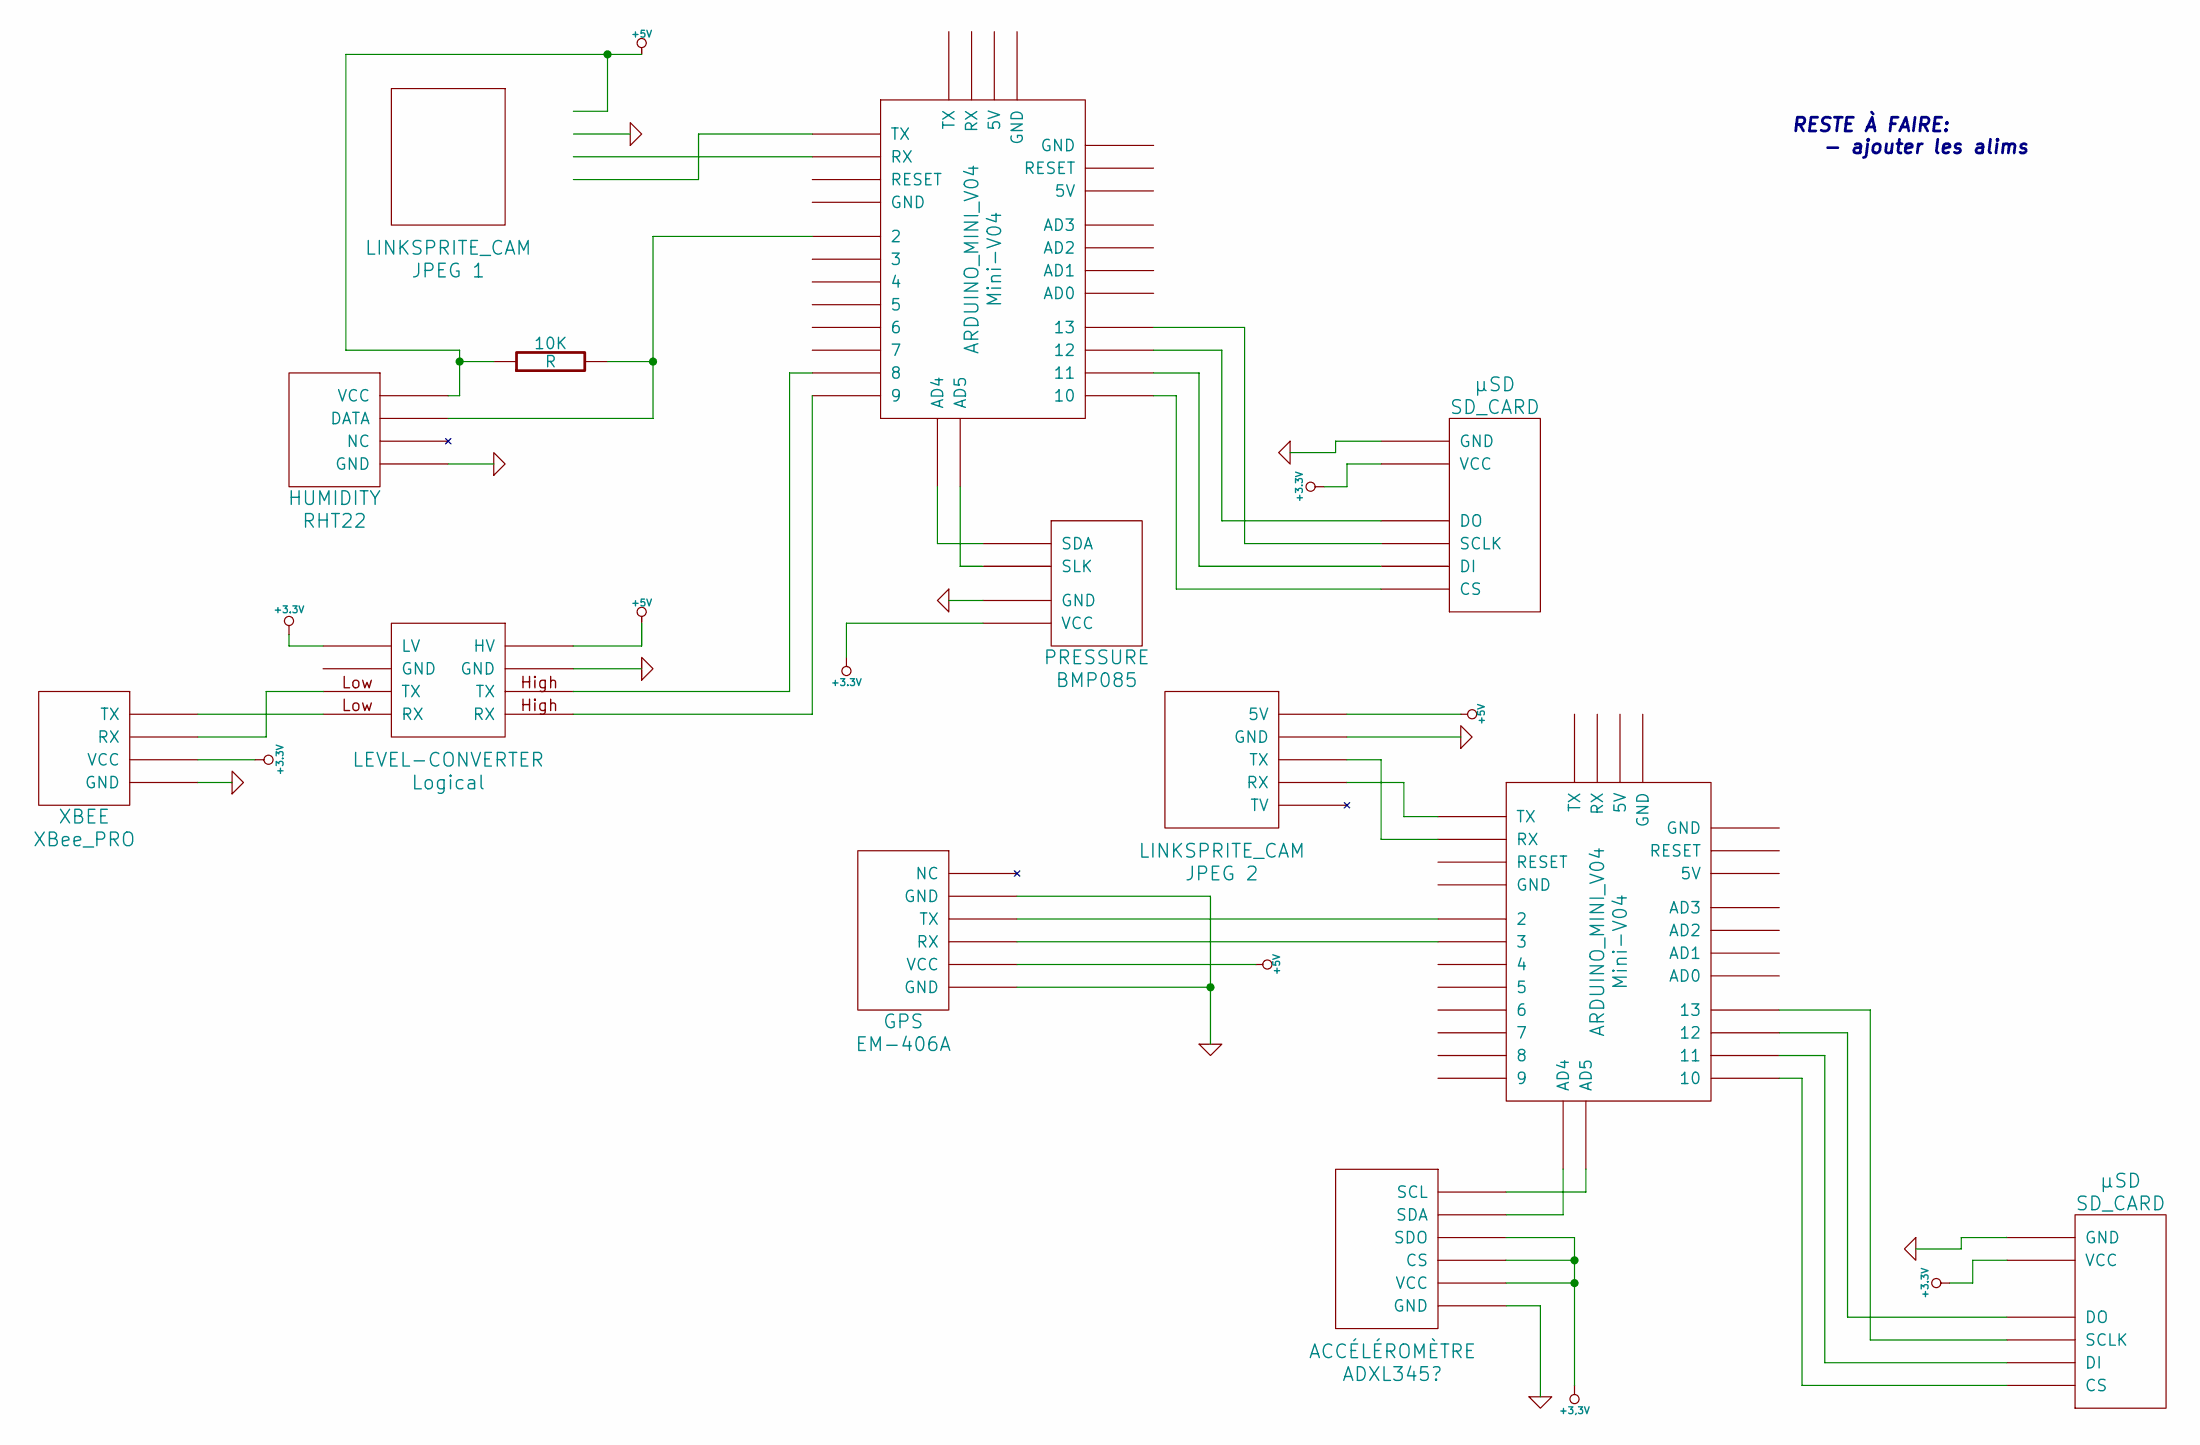
[picture p221: schematic tetrapharmakos.sch]

Parts:
10K: R
BMP085: PRESSURE
EM-406A: GPS
JPEG: LINKSPRITE_CAM
Logical: LEVEL-CONVERTER
Mini-V04: ARDUINO_MINI_V04
RHT22: HUMIDITY
XBee_PRO: XBEE
µSD: SD_CARD

Connections:
+3.3V: BMP085.~, Logical.~ (GND), XBee_PRO.~, µSD.~
+5V: 10K.1, EM-406A.~, JPEG.~, Logical.~ (GND), RHT22.~
GND: BMP085.~, EM-406A.~, JPEG.~, Logical.~ (GND), RHT22.~, XBee_PRO.~, µSD.~
unnamed: 10K.2, Mini-V04.~, RHT22.~
unnamed: BMP085.~, Mini-V04.~
unnamed: EM-406A.~, Mini-V04.~
unnamed: JPEG.~, Mini-V04.~
unnamed: Logical.High (RX), Mini-V04.~
unnamed: Logical.Low (RX), XBee_PRO.~
unnamed: Mini-V04.~, µSD.~

Notes on the sheet:
RESTE À FAIRE: - ajouter les alims
