thriller91/Cansat-SupOp/sources/Arduino/tetra1/tetra1_final/tetra1_final.ino

/*
Programme embarqué sur l'Arduino Mini n°1 du τετραφάρμακος, pour la Fête de la science 2012.
Date du largage: 13 octobre 2012.
Auteur: Zubair Iftikhar
Licence: Libre
*/
#include <SD.h>
#include <SoftwareSerial.h>
#include "tetrapharmakos.h"
#include "DHT.h"
#include <Wire.h>
#include "BMP085.h"

#define ULTLOG_NAME "ULTM.LOG"

// RHT03
#define DHTPIN 2
#define DHTTYPE DHT22 
#define PTH_FILENAME "PTH.TXT"
File PTH_File;
DHT dht(DHTPIN, DHTTYPE);

byte incomingbyte;
byte a[32];                            //Array to store image chuncks to be read off the camera
int x=0x0000,j=0,k=0;                  //Read Starting address   
uint8_t MH=0x00,ML=0x00;
boolean EndFlag=0;
int chipSelect = 10;                    //Required when using Sparkfun SD shield
File logfile;

void ShutDownCmd();
void WakeUpCmd();
void RatioCmd();

void SendResetCmd();
void ReadImageSizeCmd();
void SetBaudRateCmd();
void SetImageSizeCmd();
void SendTakePhotoCmd();
void SendReadDataCmd();
void StopTakePhotoCmd();

void OpenFile();
char filename[] = "IMG00.jpg";

bool data_flag=false;

SoftwareSerial XBee(8,9);



File logy;


void setup()
{
	Serial.begin(38400);
	XBee.begin(9600);
        attachInterrupt(INTERRUPT_PIN, send_data, RISING);

	//RHT03
	dht.begin();
	//BMP085
	Wire.begin();
	bmp085Calibration();

	XBee.println("Debut");
	pinMode(10, OUTPUT);
	if (!SD.begin(CHIP_SELECT)) {
		while(!SD.begin(CHIP_SELECT)) { // ça sert à rien de continuer
                          Serial.println("No SD");
                          delay(10000);
                }
	}

	delay(3000);
}

void loop()
{
	PTH_File = SD.open(PTH_FILENAME, FILE_WRITE);

	PTH_File.print(millis());

	float temperature = bmp085GetTemperature(bmp085ReadUT()); //MUST be called first
	float pressure = bmp085GetPressure(bmp085ReadUP());
	PTH_File.print("\t");
	PTH_File.print(temperature, 2); //display 2 decimal places
	PTH_File.print("\t");
	PTH_File.print(pressure, 0); //whole number only.

	float h = dht.readHumidity();
	float t = dht.readTemperature();
	if (isnan(t)|| isnan(h))
		PTH_File.println("\tNaN\tNaN");
	else {
		PTH_File.print("\t");
		PTH_File.print(h);
		PTH_File.print("\t");
		PTH_File.println(t);
	}


	if(data_flag){
		PTH_File.close();
		XBee.print("*[%4%]*");
		//Transmission PTH
		PTH_File = SD.open(PTH_FILENAME);

		if (PTH_File) {
			while (PTH_File.available())
				XBee.write(PTH_File.read());
			PTH_File.close();
		}
		delay(100);
		PTH_File.close();
		SD.remove(PTH_FILENAME);


		/*
		logy = SD.open(ULTLOG_NAME, FILE_WRITE);
		logy.println(millis());
		logy.close();
		*/

		OpenFile();              // Function to create a new file (IMGXX.jpeg)
		x=0x0000;
		x-=0x20;
		EndFlag=0;

		XBee.println("*[%3%]*");
		SendResetCmd();                  // Reset the Camera
		delay(3000);                     //After reset, wait 2-3 second to send take picture command 

		XBee.print("*[%2%]*");
		SendTakePhotoCmd();
		while(Serial.available()>0)
		{
			incomingbyte=Serial.read();
		}

		while(!EndFlag)
		{
			j=0;
			k=0;

			SendReadDataCmd();
			delay(15);

			while(Serial.available()>0)
			{
				incomingbyte=Serial.read();
				k++;
				if((k>5)&&(j<32)&&(!EndFlag))
				{
					a[j]=incomingbyte;
					if((a[j-1]==0xFF)&&(a[j]==0xD9))      //Check if the picture is over
						EndFlag=1;
					logfile.print((char)incomingbyte);
					j++;
				}
			}
		}
		logfile.close();

		XBee.print("*[%1%]*");
		// Transmission
		logfile = SD.open(filename);

		if (logfile) {
			while (logfile.available())
				XBee.write(logfile.read());
			logfile.close();
		}
		XBee.print("*[%0%]*");
		delay(100);

		PTH_File = SD.open(PTH_FILENAME, FILE_WRITE);
		data_flag=false;
	}
	PTH_File.close();
	delay(10000);
}

void send_data() {
	data_flag=true;
}
// Function to create a new image name every time
void OpenFile()
{
 for (uint8_t i = 0; i < 100; i++) {
      filename[3] = i/10 + '0';
      filename[4] = i%10 + '0';
      if (!SD.exists(filename)) {
        logfile = SD.open(filename, FILE_WRITE);   // only open a new file if it doesn't exist
        break;                                     // leave the loop!
      }
  }
}

//Camera functions

void ShutDownCmd() {
	Serial.write(0x56);
	Serial.write(byte(0x00));
	Serial.write(0x3E);
	Serial.write(0x03);
	Serial.write(byte(0x00));
	Serial.write(0x01);
	Serial.write(0x01);
}

void WakeUpCmd() {
	Serial.write(0x56);
	Serial.write(byte(0x00));
	Serial.write(0x3E);
	Serial.write(0x03);
	Serial.write(byte(0x00));
	Serial.write(0x01);
	Serial.write(byte(0x00));
}

void RatioCmd() {
	Serial.write(0x56);
	Serial.write(byte(0x00));
	Serial.write(0x31);
	Serial.write(0x05);
	Serial.write(0x01);
	Serial.write(0x12);
	Serial.write(0x04);
        Serial.write(0xF0);
}

//Send Reset command
void SendResetCmd()
{
      Serial.write(0x56);
      Serial.write(byte(0x00));
      Serial.write(0x26);
      Serial.write(byte(0x00));
}

// Send image size command, image size is returned
void ReadImageSizeCmd()
{
      Serial.write(0x56);
      Serial.write(byte(0x00));
      Serial.write(0x34);
      Serial.write(0x01);
      Serial.write(byte(0x00));
}

// Set image size
void SetImageSizeCmd()
{
      Serial.write(0x56);
      Serial.write(byte(0x00));
      Serial.write(0x31);
      Serial.write(0x05);
      Serial.write(0x04);
      Serial.write(0x01);
      Serial.write(byte(0x00));
      Serial.write(0x19);
      Serial.write(0x22);
}

//Set up the Baud Rate of the camera
void SetBaudRateCmd()
{
      Serial.write(0x56);
      Serial.write(byte(0x00));
      Serial.write(0x24);
      Serial.write(0x03);
      Serial.write(0x01);
      Serial.write(0xAE);
      Serial.write(0xC8);

}

//Send take picture command
void SendTakePhotoCmd()
{
      Serial.write(0x56);
      Serial.write(byte(0x00));
      Serial.write(0x36);
      Serial.write(0x01);
      Serial.write(byte(0x00));  
}

//Read data
void SendReadDataCmd()
{

      MH=x/0x100;
      ML=x%0x100; 
      Serial.write(0x56);
      Serial.write(byte(0x00));
      Serial.write(0x32);
      Serial.write(0x0c);
      Serial.write(byte(0x00)); 
      Serial.write(0x0a);
      Serial.write(byte(0x00));
      Serial.write(byte(0x00));
      Serial.write(MH);
      Serial.write(ML);  
      Serial.write(byte(0x00));
      Serial.write(byte(0x00));
      Serial.write(byte(0x00));
      Serial.write(0x20);
      Serial.write(byte(0x00));  
      Serial.write(0x0a);
      x+=0x20;                            //address increases 32£¬set according to buffer size
}

//Stop taking a picture
void StopTakePhotoCmd()
{
      Serial.write(0x56);
      Serial.write(byte(0x00));
      Serial.write(0x36);
      Serial.write(0x01);
      Serial.write(0x03);        
}
