thriller91/Cansat-SupOp/sources/Arduino/tetra2/tetra2_final/tetrapharmakos.h

#ifndef tetrapharmakos_h
#define tetrapharmakos_h

#define XBEE_RX 8
#define XBEE_TX 9

#include <Arduino.h>
#include <SD.h>

#define CHIP_SELECT 10

#define INTERRUPT_PIN 1

const unsigned long stop_missions_time = 10000000; // 10 secondes (en µs)

#endif
