thriller91/Cansat-SupOp/(commit log)

2011-10-22 j'enlève mon fond d'écran qui s'était glissé dans les images
2012-02-25 ajout du nouveau logo passage à un fond plus clair distance entre les objets en rem (incompatible avec les anciens navigateurs) --- eventuellement à changer en em ---
2012-03-02 On branch master new file: sources/Arduino/ADXL335/ADXL335.cpp new file: sources/Arduino/ADXL335/ADXL335.h new file: sources/Arduino/ADXL335/keywords.txt new file: sources/Arduino/BMP085/BMP085.cpp n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
2012-03-03 added arduino libraries
2012-04-24 ajout des effets javascript pour les liens internes et les images en mode Polaroïd(C) ajout de la page sur le parachute
2012-04-27 ajout des images pour la fabrication du parachute en plastique (attention les images ne sont pas ajoutées dans le repertoire git) ajout d'un ptit script pour générer un chemin lisible par Google Eart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
2012-04-28 ajout de la réception des données caméra
2012-04-30 début de la semaine spécifique
2012-04-30 début de la semaine spécifique 2
2012-04-30 pour éviter de filer mes virus à Clément
2012-05-02 Effacement de Tiny GPS du dossier Arduino (inutile, on ne transemet que les trames
2012-05-02 Reception GPS Série (la vraie)
2012-05-02 ajout du logiciel de controle de la caméra sur pc
2012-05-02 ajout du programme principal de l'Arduino n°1
2012-05-03 separation des arduino
2012-05-03 DHT OK avec mini, reste a nettoyer le programme pour en extraire la substantifique moelle. BMP OK avec Uno sans translateur, mais pb avec la Mini.
2012-05-04 Nouveau prog, OK pour le DHT avec la mini
2012-05-07 test OK pour l'accéléro sur la mini, mais sans translateur
2012-05-09 ajout d'un exemple de sortie de l'accéléromètre pour pouvoir l'étaloner
2012-05-09 BMP085 fonctionnel sur Arduino Mini, mais sans translateur de niveau
2012-05-12 ajout des commentaires
2012-05-14 ajout de la page pour l'élec
2012-05-14 nettoyage de printemps
2012-05-14 ajout d'un exemple de sortie du capteur d'hygrométrie
2012-05-14 récupération du dossier des programmes de la station au sol (supprimé par mégarde)
2012-05-15 fin de l'erreur du nettoyage de printemps (j'espère)
2012-06-02 ajout de la partie mission écrite par Denis
2012-06-03 ajout des mission et de l'intro pour le rapport
2012-06-04 et les images qui vont avec le rapport
2012-06-24 ajout d'un Makefile pour le programme C++ de la µCam
2012-06-30 communication serie avec Arduino pour transmettre des bytes sémentiques
2012-06-30 Syncronisation OK avec la Arduino !!!
2012-07-14 Sans bug c'est quand même mieux, même si l'image reste illisible
    [test.ino]
2012-07-14 le dossier Spark contient le sketch initial donné par quelqu'un sur Sparkfun, il permet d'obtenir --- youpi! --- des images à partir de l'Atmega328
2012-07-14 Mise-à-jour avant la modif du site pour le rendre lisible
    [Frais.ods]
2012-07-15 Récuperation d'une image écrite dans la carte SD à partir d'un programme de la station au sol à l'aide de la liaison HardwareSerial
2012-07-15 Test réussi avec le Software Serial, il n'y a donc a priori aucun problème à prévoir avec la XBee
2012-07-21 Test de documentation dans le repository
2012-07-21 Ajout de la doc du BMP085 dans le repo
2012-07-21 Avec de jolies flèches
2012-07-22 Ajout d'un schéma électronique réalisé avec KiCad
    [tetrapharmakos.sch]
2012-07-28 Ajout de la bibliothèque de l'accéléro numérique (ADXL345). Fonctionnel sur Mini sans adaptation de niveau, et branché en I2C
2012-07-29 Ajout de l'accéléromètre numérique dans le schéma électronique
    [tetrapharmakos.sch]
2012-08-06 changement des fichiers du programme de l'Arduino n°1 en liens symboliques
    [tetrapharmakos.sch]
2012-08-07 Programme tetra1 avec support de la carte SD
2012-08-07 Ajout de la communication via SoftwareSerial, pour la XBee, OK
2012-08-07 Ajout de la prise en charge du Switch, mais c'est bizarre, la reception XBee est bonne, qu'on place SWITCH_A1 en LOW ou HIGH (le Switch n'a donc aucun intérêt)
2012-08-08 Avec une prise de photo (à l'arrache), non testée en pratique
2012-08-09 Ajout d'un programme de station au sol en Python
2012-08-09 Retrait du traitement avec des expressions régulières (pas assez robuste en l'état), remplacement par des tests IF simples
2012-08-10 Ça marche, mais il reste des modifs à faire pour améliorer la robustesse
2012-08-13 Nettoyage: suppression des bibliothèques inutiles
2012-08-15 Ébauche de programme pour la 2ème Arduino
2012-08-16 Ajout de programmes de test des composants, tous nos composants fonctionnent (BMP, RHT, ADXL, GPS)\!
2012-08-17 Ajout d'un script de traitement des données météorologiques
2012-08-18 Test de l'envoi d'un fichier binaire via HardwareSerial, avec réception par la station au sol, OK.
2012-08-18 Programme de test de communication via SoftwareSerial entre 2 Arduino, OK, mais peut être améliorée (trop lent et trop d'erreurs).
2012-08-19 Réception d'un truc bizzare (aucune information, mais taille de fichier du bon ordre de grandeur)
2012-08-19 Ah oui\! J'avais oublié de remplacé le 'print' de la version d'avant par 'write'
2012-08-20 Transfert d'image OK entre les 2 Arduinos, mais il faudrait essayer d'aller plus vite et avec moins d'erreurs.
2012-08-23 Il faudra recoller la caméra sur le HardwareSerial, mais sinon, ça va.
2012-08-23 Prise en charge de la reception de données depuis la station au sol
2012-08-23 Fonctionnement OK entre station au sol et le programme de la Arduino n°1
2012-08-23 Prise en charge du jumper de détection de largage.
2012-08-24 Prise en charge du jumper dans le programme principal. OK.
2012-08-28 Programme final de l'Arduino1
2012-08-29 Programme final embarqués sur les Arduino Mini du τετραφάρμακος
2012-08-31 Programme du tetrapharmakos embarqué dans la fusée expérimentale EVE4 de l'équipe Octave pour le projet Perseus
2012-09-23 Mise à jour du site et début du tuto pour Evola.fr
    [Frais.ods]
2012-09-23 Ajout de l'accéléromètre au tuto
2012-09-30 Suite du tuto jusqu'à la partie de la transmission de données sans-fil
    [tetrapharmakos.sch]
2012-10-12 Ah, j'ai trouvé! Faisons des anaglyphes!
2012-10-13 Pret pour la fete de la science 2012
2017-02-20 useless commit
    il restait un fichier de test modifié qui n’avait pas été commité,
    maintenant, c’est fait
