thriller91/Cansat-SupOp/(notices)

Notices in the files:
sources/Arduino/tetra2/tetra2_final/ADXL345.cpp:
This program is free software: you can redistribute it and/or modify
it under the terms of the version 3 GNU General Public License as
published by the Free Software Foundation.
